TheMechatronic/Skripsie-2022/Report/AppendixDefinitions.tex

\newpage

\chapter{Definitions, Clarifications and Explanations}

\label{ch:defs}

\section{Chapter \ref{ch:concept}}

\subsection*{Definitions}

\label{sec:defs3}

\textbf{Platform}: A solution neutral reference to the system that is being conceptualised. Used interchangeably with \acf{nsoi}, the platform has defined boundaries and interfaces with the \acf{wsoi} and the environment.

\textbf{User}: Refers to the cyclist who will be using the developed platform. At this stage, conceptualisation was focused on the development of the platform as opposed to the overarching objective of providing source material and resources to future development.

\subsection*{Explanations}

\subsubsection{Performance Requirements \ref{PR:27speed} \& \ref{PR:29speed}:}

The typical speed of a cyclist typically ranges from \SI{10}{\kilo\meter\per\hour} to \SI{50}{\kilo\meter\per\hour} when cycling on reasonably flat ground. For the design of the platform, a maximum required speed of \SI{50}{\kilo\meter\per\hour} was assumed. Considering the two wheel sizes that were identified in Chapter~\ref{sec:specs}, the expected wheel rotational speeds are determined by Equation~\ref{eq:omega}.

\begin{equation}
	\ac{omega} = \frac{2 \ac{v}}{D_{wheel}}
	\label{eq:omega}
\end{equation}

\subsubsection{Performance Requirement \ref{PR:power}:}

Typically, amateur cyclists maintain an average power output between \SI{75}{\watt} and \SI{280}{\watt}, and pro cyclists can maintain up to \SI{400}{\watt}, during a 1 hour workout. As the cyclist's speed increases, less torque is required to maintain the same power output. The relation is expressed as Equation~\ref{eq:pow} and can be used to determine the force that would need to be applied at different wheel speeds to achieve these power outputs.

\begin{figure}[H]
	\begin{center}
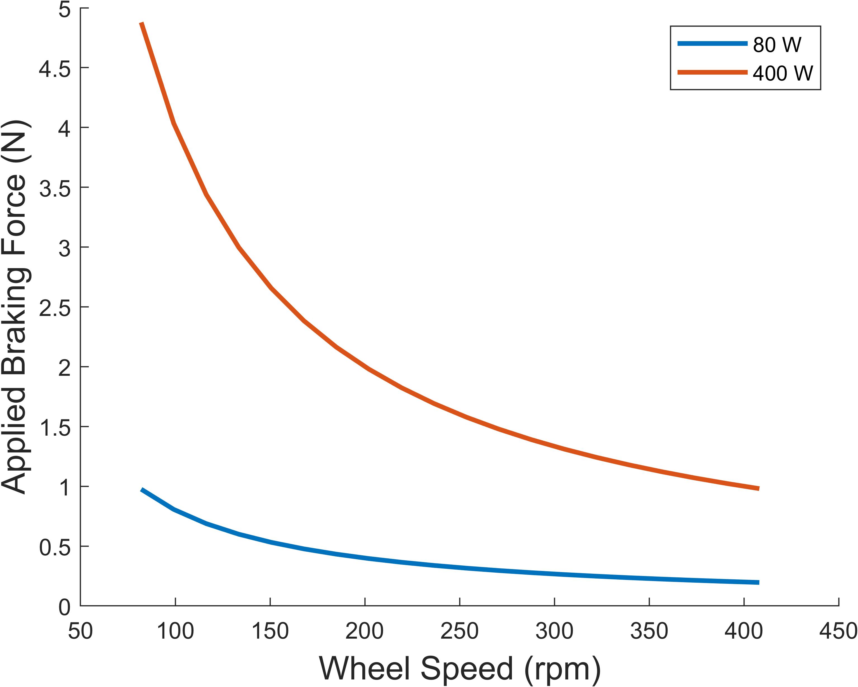
[picture p1: Report/graphics/BrakingForce.jpg]
		
		\caption{Required Braking Force Range}
		\label{fig:force}
	\end{center}
\end{figure}

\subsubsection{System Interface 2: \ac{ble} with \ac{ftms} implementation}

In order to achieve Design Objective 3, requiring the development of software that will be usable by future projects, dependency on the Zwift application \ac{api} had to be avoided. This resulted in the development of software that will enable micro controllers to interact with application hosts in a similar way to conventional smart trainers. This means that the solution will be compatible with the Zwift application irrespective of the device that acts as a host for the application. \ac{ble} was chosen as the communication protocol as this is what is available on most consumer electronic devices that Zwift is expected to operate on, and will thus not need an external unit to communicate with the platform.

%\begin{figure}[h!]
%	\centering
%	\begin{subfigure}[b]{.475\textwidth}
	%		\centering
	%		\includegraphics[width=.9\linewidth]{FluxZeroDeg.jpg}
	%		\caption{\SI{0}{\degree} Phase}
	%		\label{fig:Flux0}
	%	\end{subfigure}
%	\hfill
%	\begin{subfigure}[b]{.475\textwidth}
	%		\centering
	%		\includegraphics[width=.9\linewidth]{FluxSixtyDeg.jpg}
	%		\caption{\SI{60}{\degree} Phase}
	%		\label{fig:Flux60}
	%	\end{subfigure}
%	\vskip\baselineskip
%	\begin{subfigure}[b]{.475\textwidth}
	%		\centering
	%		\includegraphics[width=.9\linewidth]{FluxOneTwentyDeg.jpg}
	%		\caption{\SI{120}{\degree} Phase}
	%		\label{fig:Flux120}
	%	\end{subfigure}
%	\hfill
%	\begin{subfigure}[b]{.475\textwidth}
	%		\centering
	%		\includegraphics[width=.9\linewidth]{FluxOneEightyDeg.jpg}
	%		\caption{\SI{180}{\degree} Phase}
	%		\label{fig:Flux180}
	%	\end{subfigure}
%	\begin{subfigure}{.475\textwidth}
	%		\centering
	%		\includegraphics[width=\linewidth]{FluxLegend.jpg}
	%	\end{subfigure}
%	\caption{Flux Distribution}
%	\label{fig:Flux}
%\end{figure}

\section{Chapter~\ref{ch:electronics}}

\subsubsection{RPR-220 Data Summery}

\begin{table}[H]
	\renewcommand{\arraystretch}{\tablestretch}
	\centering
	\caption{RPR-220 Data Sheet Parameter Summary}
	\citep[2015]{RPR:2015}
	\begin{tabularx}{\textwidth}{X >{\raggedright}p{3cm} >{\raggedright\arraybackslash}p{2cm} }
		\toprule
		Parameter                       & Condition & Value                   \\
		\midrule
		LED Current                     & Maximum   & \SI{50}{\milli\ampere}  \\
		LED Voltage                     & Rated     & \SI{5}{\volt}           \\
		Phototransistor Current (Dark)  & Rated     & \SI{0.5}{\micro\ampere} \\
		Phototransistor Current (Light) & Rated     & \SI{0.8}{\milli\ampere} \\
		Phototransistor Current         & Maximum   & \SI{}{\milli\ampere}    \\
		Phototransistor Response Time   & Rated     & \SI{10}{\micro\second}  \\
		\bottomrule
	\end{tabularx}
	\label{tab:rprdata}
\end{table}

\subsubsection{Nema-23 Wiring}

Determining the correct wiring of the stepper motor requires determining where on the coils the wires are connected. Figure~\ref{fig:motorWire} shows a schematic of the wire colors and coil orientations that were determined for this project.

\begin{figure}[H]
	\begin{center}
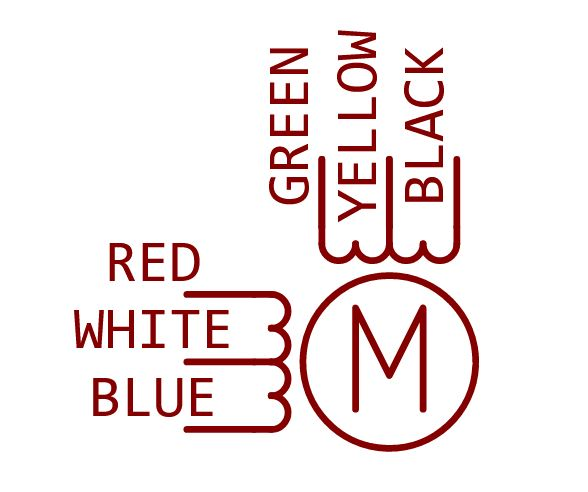
[picture p2: Report/graphics/MotorWire.JPG]
		
		\caption{Nema-23 Wiring}
		\label{fig:motorWire}
	\end{center}
\end{figure}

After testing the resistance level between the wires on the Nema-23 stepper motor, the results are shown in Figure~\ref{tab:nemaTest}. From Table \ref{tab:nemaTest}, the wires associated with each coil can be identified. A resistance of > \SI{1}{\mega\ohm} indicates that the wires are not connected to the same coil. For the wires on the same coil, a larger resistance indicates that there is more coiled wire between the connections, and they are thus further apart.

\begin{table}[H]
	\renewcommand{\arraystretch}{\tablestretch}
	\centering
	\caption{Stepper Motor Wire Resistance Measurement Results}
	\begin{tabularx}{\textwidth}{X X X X X X  }
		\toprule
		& Black               & Green                 & Red                   & Yellow                & White                 \\
		\midrule
		Blue   & > \SI{1}{\mega\ohm} & > \SI{1}{\mega\ohm}   & \SI{41.2}{\ohm}       & > \SI{1}{\mega\ohm}   & \SI{20.7}{\ohm}       \\
		White  & > \SI{1}{\mega\ohm} & > \SI{1}{\mega\ohm}   & \SI{20.8}{\ohm}       & > \SI{1}{\mega\ohm}   & \cellcolor{lightgray} \\
		Yellow & \SI{20.7}{\ohm}     & \SI{20.5}{\ohm}       & > \SI{1}{\mega\ohm}   & \cellcolor{lightgray} & \cellcolor{lightgray} \\
		Red    & > \SI{1}{\mega\ohm} & > \SI{1}{\mega\ohm}   & \cellcolor{lightgray} & \cellcolor{lightgray} & \cellcolor{lightgray} \\
		Green  & \SI{40.5}{\ohm}     & \cellcolor{lightgray} & \cellcolor{lightgray} & \cellcolor{lightgray} & \cellcolor{lightgray} \\
		\bottomrule
	\end{tabularx}
	\label{tab:nemaTest}
\end{table}
