TheMechatronic/Skripsie-2022/Report/Main.pdf

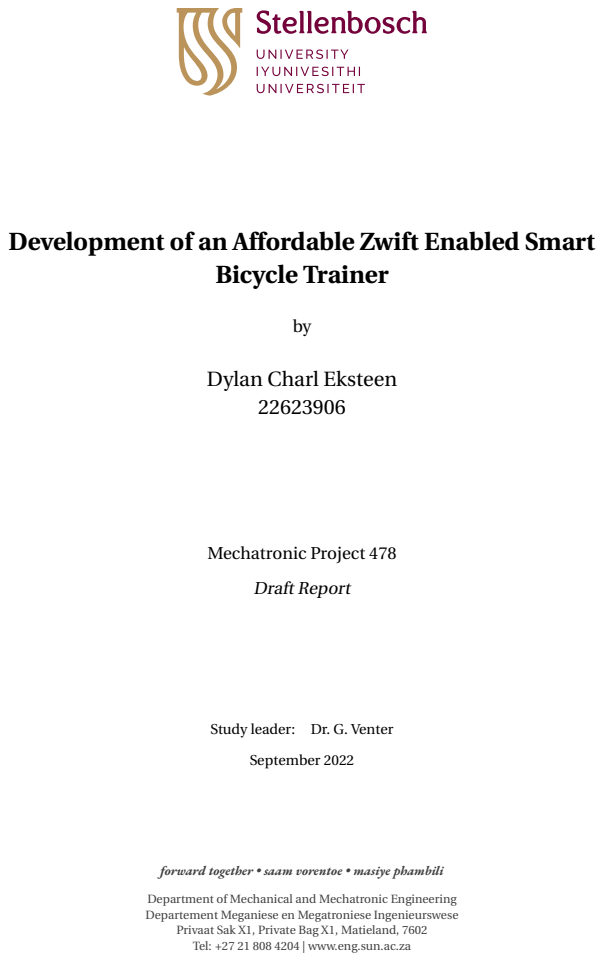
[picture p54: page 1]
Bicycle Trainer; Mechatronic Project 478; Draft Report; September 2022

Development of an Affordable Zwift Enabled Smart

Dylan Charl Eksteen

Study leader: Dr. G. Venter

forward together • saam vorentoe • masiye phambili

Department of Mechanical and Mechatronic Engineering
Departement Meganiese en Megatroniese Ingenieurswese
Privaat Sak X1, Private Bag X1, Matieland, 7602
Tel: +27 21 808 4204 | www.eng.sun.ac.za

# Declaration

By submitting this report electronically, I declare that the entirety of the work contained therein is my own, original work, that I am the sole author thereof (save to the extent explicitly otherwise stated), that reproduction and publication thereof by Stellenbosch University will not infringe any third party rights and that I have not previously in its entirety or in part submitted it for obtaining any qualification.

Signature: |

September 20, 2022
Date: |
D. C. Eksteen
Student Name: |

22623906
Student Number: |

Copyright © 2022 Stellenbosch University All rights reserved.

i

### MECHATRONIC PROJECT 478:

### EXECUTIVE SUMMARY

Student: D. C. Eksteen

Title of Project

Development of an Affordable Zwift Enabled Smart Bicycle Trainer

Objectives

- Design and build an inexpensive bicycle trainer with controllable resistance
- Design and implement software for connecting and interfacing with Zwift
- Test and calibrate the resistance and connectivity of the trainer

What is current practice and what are its limitations?

- Commercial smart trainers that are compatible with Zwift are very expensive and thus inaccessible to

many consumers

- Accessories such as training tyres and additional cassettes also add to the costs of many available trainers

What is new in this project?

The project will develop a focused product, that will be inexpensive, simple and intuitive to use and easy

to maintain

If the project is successful, how will it make a difference?

The developed trainer will make the Zwift training experience more accessible and affordable to a wider

range of consumers. The trainer will also not need many accessories to use, and will be usable by many

different types of bicycles

What are the risks to the project being a success? Why is it expected to be successful?

- Connectivity with Zwift: There is a risk that Zwift will require proprietary software in order to connect

hardware to the platform

- Supply and manufacturing of components. There is a global shortage of components and manufacturing

may be expensive and time consuming

What contributions have other students made?

- There are various different examples of non-smart trainers on the market, which will serve as examples

of what technologies work with similar products

- There are some examples of developed BLE connectivity, as well as some libraries to enable the use of

python in the development process

ii

Mechatronic Project 478: | Executive Summary | iii

Which aspects of the project will carry on after completion and why?

NA

What arrangements have been made to expedite continuation?

- The developed software and electronics schematics will be available on a GitHub repository under an

open license

- The hardware design and concept will be documented and presented in this report, and in the final

project poster

Student

September 20, 2022

Date | Lecturer

### MECHATRONIC PROJECT 478: ECSA EXIT LEVEL OUTCOME EVALUATION

ELO 1: Problem Solving
Demonstrate competence to identify, assess, formulate and solve convergent and divergent engineering problems creatively and innovatively.
- Chapters 1,2,3
and 4
- Poster
- Identify the need for an inexpensive smart trainer that will be able to interface with

Zwift.

- Indicate the criteria needed to connect with Zwift, as well as have a usable trainer done

in Introcuction and Literature Review. (Chapter 1 and 2).

- Best sollution for general problem presented, then split into seperate sections to solve

further ito. Software and Hardware requirements (Chapter 3 and 4)

ELO 2: Application of Scientific and Engineering Knowledge Demonstrate competence to apply knowledge of mathematics, basic science and engineering sciences from first principles to solve engineering problems.

- Section 4.1
- Model of Forces involved in trainer for use in basic hardware design and component

selection.

- Mathematical model and analysis of Eddy Current Brake. (Section 4.1)

ELO 3: Engineering Design
Demonstrate competence to perform creative, procedural and non-procedural design and synthesis of components, systems, engineering works, products or processes.
- Chapter 2 and 3
- Design the software approach, communicating with Zwift through BLE protocol.
- Design a hardware approach for both the resistance brake and the general trainer.
- Design the electro-mechanical control of the braking unit and the controlling software.

(Chapter 2 and 3)

iv

Mechatronic Project 478: | Executive Summary | v

ELO 5: Engineering Methods, Skills and Tools, Including Information Technology Demonstrate competence to use appropriate engineering methods,
skills and tools, including those based on information technology.
- Chapter 3 and 4
- Engineering method applied to solving the communication and control of the trainer

with an external Zwift host.

- Engineering method applied to selecting, designing and implementing the hardware

components needed for the trainer.

- Adequate consideration for the goal of the product applied to the planning and design

phases.

ELO 6: Professional and Technical Communication Demonstrate competence to communicate effectively, both orally and in writing, with engineering audiences and the community at large.

- Report
- Poster
- Presentation
- The Report and the oral presentation will aim to prove the ability to achieve the

communication.

- The Report will focus on presenting the project to a technical and engineering

audience where the poster will be aimed at presenting to the wider community.

ELO 8: Individual, Team and Multidisciplinary Working Demonstrate competence to work effectively as an individual, in teams and in multi-disciplinary environments.

- Section X
- Project focuses on Individual work, with guidance from supervisor and input from

other students working under same supervisor.

- The project proposal, progress report, progress presentation, draft report and final

report will be handed in to achieve this.

Mechatronic Project 478: | Executive Summary | vi

ELO 9: Independent Learning Ability Demonstrate competence to engage in independent learning through well-developed learning skills.

- Chapter 2 & 3
- The learning of Bluetooth technology and application of Eddy Current Brake models

prove independent learning.

# Contents

Declaration | i
Executive Summary | ii
ECSA Exit Level Outcome Evaluation | iv
Contents | vii
List of Tables | ix
List of Figures | x
List of Abbreviations | xi
List of Symbols | xii
1 Introduction | 1
2 Literature Review | 4

vii

CONTENTS | viii
3 Hardware Development | 14
4 Software Development | 20
5 Electronics Design | 24
List of References | 28
A Eddy Current Brake Calculations | i
B Budget | iv

# List of Tables

2.1 | Zwift Supported Fittness Machine Data (FTMS) Commands | | 6
2.2 | Technical Specifications of the Bluetooth Low Energy (BLE) Standard | 9
2.3 | Relevant Optional Fitness Machine Features of Fittness Machine
Data (FTMS) Protocol | 10
2.4 Relevant Optional Target Setting Features of Fittness Machine Data
(FTMS) Protocol | 10
2.5 | Indoor Bike Simulation (SIM) Mode Parameter Data | 11
2.6 | Best Selling Road and Mountain Bike (MTB) specifications | 12
3.1 | Objectives of Hardware Development | 14
3.2 | Outcomes of Condition Analysis | 16
5.1 | RPR-220 Data Sheet Parameter Summary | 25
5.2 | Stepper Motor Wire Resistance Measurement Results | 26

ix

# List of Figures

2.1 | Bluetooth Low Energy (BLE) Star Network Topology | | 8
2.2 | Bicycle Dimensions | 12
3.1 | Rotational Speed of Roller Size Comparison | 15
3.2 | Magnetic Flux Density of Disc Magnet | 17
3.3 | Flux Distribution | 18
3.4 | Figure 7 | 19
3.5 | Figure 8 | 19
4.1 | Overview of General Software Structure | 21
4.2 | Bluetooth Low Energy (BLE) Protocol Stack | 22
5.1 | Sensor Implementation | 26
5.2 | Motor Control Components | 26
5.3 | Nema-23 Wiring | 27
A.1 | Eddy Current Brake Dimensions | | i
A.2 | Figure 5 | | iii
A.3 | Figure 6 | | iii

x

# List of Abbreviations

API | Application Program Interface
BLE | Bluetooth Low Energy
BR/EDR Basic Rate/Enhanced Data Rate
BSIG | Bluetooth Special Interest Group
Crr | Coefficient of Rolling Resistance
Cw | Wind Resistance Coefficient
DIS | Device Information Service
FTMS | Fittness Machine Data
GATT | Generic ATTribute Profile
GPIO | General Purpose Input and Output
IDE | Integrated Development Environment
IPC | Inter-Process Communicationt
MTB | Mountain Bike
RPC | Remote Procedure Calls
rpm | Revolutions Per Minute
SIM | Indoor Bike Simulation
UHF | Ultra-High Frequency

xi

# List of Symbols

Br | Magnet Remanence Field | T
ω | Angular Velocity | rads⁻¹
θ | Angle | rad
T | Torque | Nm
F | Force | N
I | Current | A
v | Velocity | ms⁻¹
B | Magnetic Flux Density | T
σ | Conductivity | Sm⁻¹

xii

# Chapter 1

# Introduction

## 1.1 Background

Bad weather, time, safety or other factors may prevent cyclists from being able to train outside. Modern city lifestyle often means that it is often safer and more convenient In recent years, it has become very popular for cyclists to train indoors as this is often safer than cycling on busy city streets, it makes cycling less reliant on the weather and is more convenient. The problem is that indoor cycling can often be very boring and lonely.
Zwift is an online based virtual reality platform that allows indoor cyclists to virtually ride courses in the real world whilst communicating and competing with other people in real time through the platform. This allows for indoor cycling to become more interactive and exciting, allowing the cyclist to train more effectively and enabling social engagement during training sessions. In order to use the Zwift platform, you need a compatible trainer or training device in order to send riding information to Zwift and to receive feedback that will adjust the riding experience based on the virtual circumstances. These trainers are very expensive and thus not very accessible to many consumers. This project will aim to demonstrate the development, design and testing of an inexpensive smart bicycle trainer. The project, conducted by Mr D.C. Eksteen as part of Mechatronic Project 475, stems from a proposal by Dr G. Venter.

1

CHAPTER 1. INTRODUCTION | 2

## 1.2 Aim and Objectives

This project aims to develop, build and test a smart trainer, with specific focus on compatibility with Zwift.
The objectives will be to:
- Develop Hardware to:
1. Monitor and measure the rider inputs. These include, for example, cycling speed, cadence, power, heart rate etc.
2. Change the riding conditions based on feedback from Zwift platform. These include, for example, rolling resistance, incline etc.
- Develop Software to:
1. Collect and process rider inputs and to communicate this to the Zwift platform.
2. Receive feedback information from Zwift and enable hardware to change the riding conditions as mentioned above.
- Combine developed Hardware and Software to produce a smart trainer that is comparable to smart trainers that are available on the market, but at a lower cost point. (Needs refinement)

CHAPTER 1. INTRODUCTION | 3

## 1.3 Motivation

Motivation will focus on:

- What:

– Zwift = popular indoor training and competitive platform.

– Bicycle trainer = Convenient way to train cycling without needing to cycle outside.

- Why:

– Indoor training increasing in popularity.

– Making access to Zwift more accessible and thus promoting cycling and exercise.

- How:

– Convert existing "dumb" trainer into smart trainer.

– Enable trainer to connect with Zwift platform.

– Using and leveraging existing industry standards to produce a robust solution.

# Chapter 2

# Literature Review

The literature review is performed to define the requirements for the connection with Zwift, as well as discovering and understanding the various desired and required features and products that exist on the market today.

## 2.1 Overview

4

CHAPTER 2. LITERATURE REVIEW | 5

## 2.2 Zwift: Technology and Requirements

As mentioned above, Zwift uses real-time training data to drive the avatar in the virtual world. In order to achieve this, Zwift needs to run on a device that has :

- An internet connection to connect to the Zwift servers via the Application Program Interface (API).
- Bluetooth Low Energy (BLE) or ANT+ functionality to receive the data from the training session.

This device is usually a laptop, mobile phone or tablet, and will also display the avatar in the virtual world to the player. Moving forward, this device will be referred to as the "host" device as it is the central device controlling the user experience. (von Bromley, 2022)

### 2.2.1 Basic Requirements

As mentioned above, Zwift requires real-time tracking data from the player in order to control the avatar. The interactiveness and accuracy of the experience greatly depends on the amount and nature of the data that is sent to the host device (also sometimes referred to as the ’main unit’).

Parameter | Unit | Connectivity | Control
Speed | (rpm) | Essential | Essential
Cadence | (rpm) | Optional | Optional
Power | (W) | Optional | Optional

### 2.2.2 BLE vs ANT+

Both BLE and ANT+ devices communicate using Ultra-High Frequency (UHF) electromagnetic waves with frequencies around 2.4 GHz. The communication also takes part over a small distance.

CHAPTER 2. LITERATURE REVIEW | 6

BLE for Fitness Devices

BLE is one of two standards for Bluetooth communication that has been developed and maintained by Bluetooth Special Interest Group (BSIG).¹The

specific details of the technology and standard is discussed in Section 2.4. For the sake of Zwift requirements, this section will look at the specific protocol of the BLE specification that Zwift supports.
In the past, when Zwift was just launched, all of the Bluetooth communication was performed using proprietary protocols provided by the manufacturers of trainers and training equipment as there has not yet been a standard protocol defined to handle Bluetooth communication of controllable sports equipment. On 14 February 2017, BSIG adopted the Fittness Machine Data (FTMS) protocol to the BLE Generic ATTribute Profile (GATT). Then, in late 2021 Zwift announced that they will be supporting FTMS in their latest update, and thus any new trainer that would like to interact with the Zwift platform would be required to follow the FTMS protocol as is discussed in Section 2.4. (Zwift Forums)
Table 2.1 below shows the different commands within the FTMS protocol that Zwift uses to control connected trainers. This can be deducted from the control modes that are available on the platform, and have been confirmed by a Zwift engineer on the official support forums.

Table 2.1: Zwift Supported FTMS Commands

Command | Description

Set Target Resistance
Level

Sends the desired resistance level to the trainer.

Set Target Power | Sends the targeted power (Watts) that the trainer
should aim to maintain.
Start or Resume | Starts or resumes a training session on the trainer
Stop or Pause | Stop or pause a training session on the trainer.

Set Indoor Bike
Simulation Parameter

Set the simulation parameters on the trainer

1The other being Bluetooth Basic Rate/Enhanced Data Rate (BR/EDR)

CHAPTER 2. LITERATURE REVIEW | 7

Depending on the type of workout that is being performed, Zwift will use the different control point commands listed in Table 2.1 above. When the user is normally riding around within the Zwift world, it will send Indoor Bike Simulation (SIM) parameter commands. This is explained in more detail in Section 2.4. When the user is using the "Workout Mode", Zwift has the option to engage "ERG" mode, where it will send a desired power target that the trainer should aim to maintain regardless of the speed. Thus the user can decide to go faster, with the trainer lowering the resistance, or go slower with the trainer having an increased resistance. Lastly, the user can adjust the resistance on their trainer from within the Zwift software, requiring Zwift to then send that specific command to the trainer.

CHAPTER 2. LITERATURE REVIEW | 8

## 2.3 Existing Trainer Technology

## 2.4 BLE Communication

BLE works by forming pico - and scatter-net networks between various master and slave devices. Each device in the network is either a master or a slave, but never both. The devices then form a piconet when one or more slaves connect and synchronize with a single master device. The role of the master device is then to manage the slave devices through the protocol. This forms a network as can be seen in Figure 2.1 below.

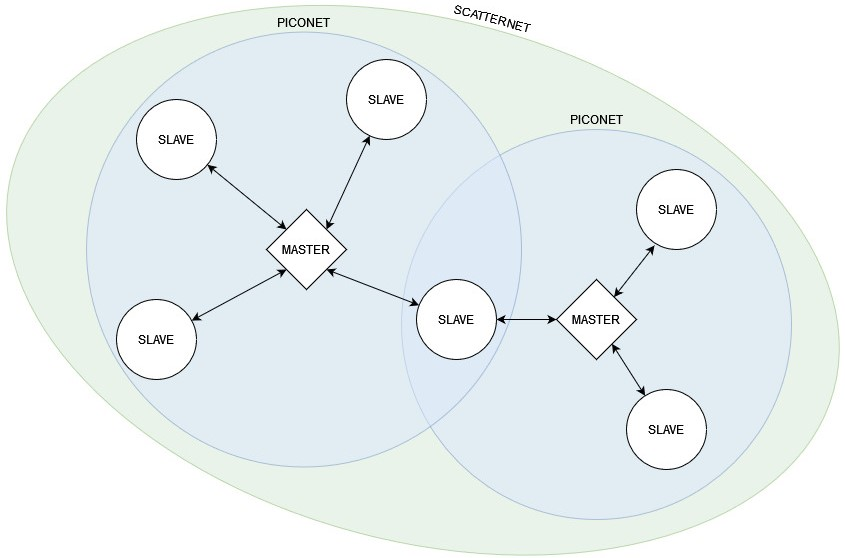
[picture p55: figure]

Figure 2.1: BLE Star Network Topology

The master thus determines how often a slave is allowed to communicate, and slaves only communicate when requested to do so by a master. This is with one exception in the case of "advertising". Advertising is a feature that allows a slave device to announce that it has something to transmit to the master. This is either an event message or a measurement value.

CHAPTER 2. LITERATURE REVIEW | 9

Some other features worth considering are listed in Table 2.2 below:

Table 2.2: Technical Specifications of the BLE Standard

Description | Specification | Detail
Data Package Size | 64 bit (min) to 216 bit (max) | The size data packages that can be sent between a master and slave(s).
Data Transfer Rate | 1 Mbps | The rate at which the data is typically transferred between devices.
Security | 128-bit AES | Security and encryption varies in levels, but generally data is encrypted between devices with a "shared secret" key that is generated during pairing.
Latency | 6 ms | Time between device starting transmission and data getting transferred. (Aka network lag).
Power Consumption | 0.01 W to 0.5 W | The power required by a device to join and operate on the piconet.

FTMS Protocol

Within the FTMS protocol, there is a sub-protocol dedicated to Indoor Bike Data that focuses specifically on the application of the protocol for bike trainers. (Bluetooth®Service Specification, section 4.9).

The specification outlines and defines services that are supported by the protocol. Table 2.3 and 2.4 below lists the available features that are of interest to the project. Machine Features are Parameters that can be requested from the trainer, and Target Features are training parameters that can be set from an external device. (Bluetooth®Service Specification)

CHAPTER 2. LITERATURE REVIEW | 10

Table 2.3: Relevant Optional Fitness Machine Features of FTMS Protocol

Number Feature | Description

NAa
| Instantaneous Speed | Trainer can determine the instantaneous speed of the user.
0 | Average Speed Supported | Trainer can determine the average speed of the user for the duration of the session.
1 | Cadence Supported | Trainer can determine pedalling rate of the user (rpm).
7 | Resistance Level Supported | Trainer can determine the resistance the user experiences.
10 | Heart Rate Measurement Supported | Trainer is able to determine the heart rate of the user.
14 | Power Measurement Supported | Trainer is able to determine the power generated by the user.

aThis feature is compulsory for protocol.

The parameters that would be relevant to the control of a bicycle trainer connected to Zwift are listed in Table 2.4 below:

Table 2.4: Relevant Optional Target Setting Features of FTMS Protocol

Number Feature | Description
1 | Inclination Target Setting | Trainer can adjust difficulty to simulate inclination.
2 | Resistance Target Setting | Trainer can adjust resistance level.
3 | Power Target Setting | Trainer can adjust difficulty to maintain power target.
13 | SIM Parameters | Trainer supports SIM mode.

CHAPTER 2. LITERATURE REVIEW | | | 11

SIM mode

This mode is defined in the FTMS documentation, and needs Control Permission to be activated. Once the mode is activated, the trainer will receive parameter arrays with the data shown in Table 2.5 below to determine the required resistance level.

Table 2.5: SIM Mode Parameter Data

Parameter | Unit | Size | Resolution
Wind Speed | ms⁻¹ | 16 bit | 0.001
Grade | % | 16 bit | 0.01
Coefficient of Rolling Resistance (Crr) | | 8 bits | 0.0001
Wind Resistance Coefficient (Cw) | kgm⁻¹ | 8 bits | 0.01

The Grade indicates the gradient of the road that the avatar is travelling on. The Coefficient of Rolling Resistance (Crr) is determined by the road surface and wheel type of the avatar in the game, where the Wind Resistance Coefficient (Cw) is determined by the player’s weight and height, and can then be reduced by in-game events such as equipment selection and drafting behind other avatars when this feature is active. Currently Zwift does not utilize the Wind Speed parameter.
These parameters are then used by the trainer to determine the resistance required to simulate the conditions in the game. This is what creates the realistic training experience.

CHAPTER 2. LITERATURE REVIEW | 12

## 2.5 Bicycle Specifications

The two most common types of bicycles that are expected to be used on the trainer are Mountain Bikes (MTBs) and road bicycles. For the design of a bike trainer, the relevant dimensions to consider are the wheelbase wheel diameter and weight. Figure 2.2 below shows where the dimensions are measured.

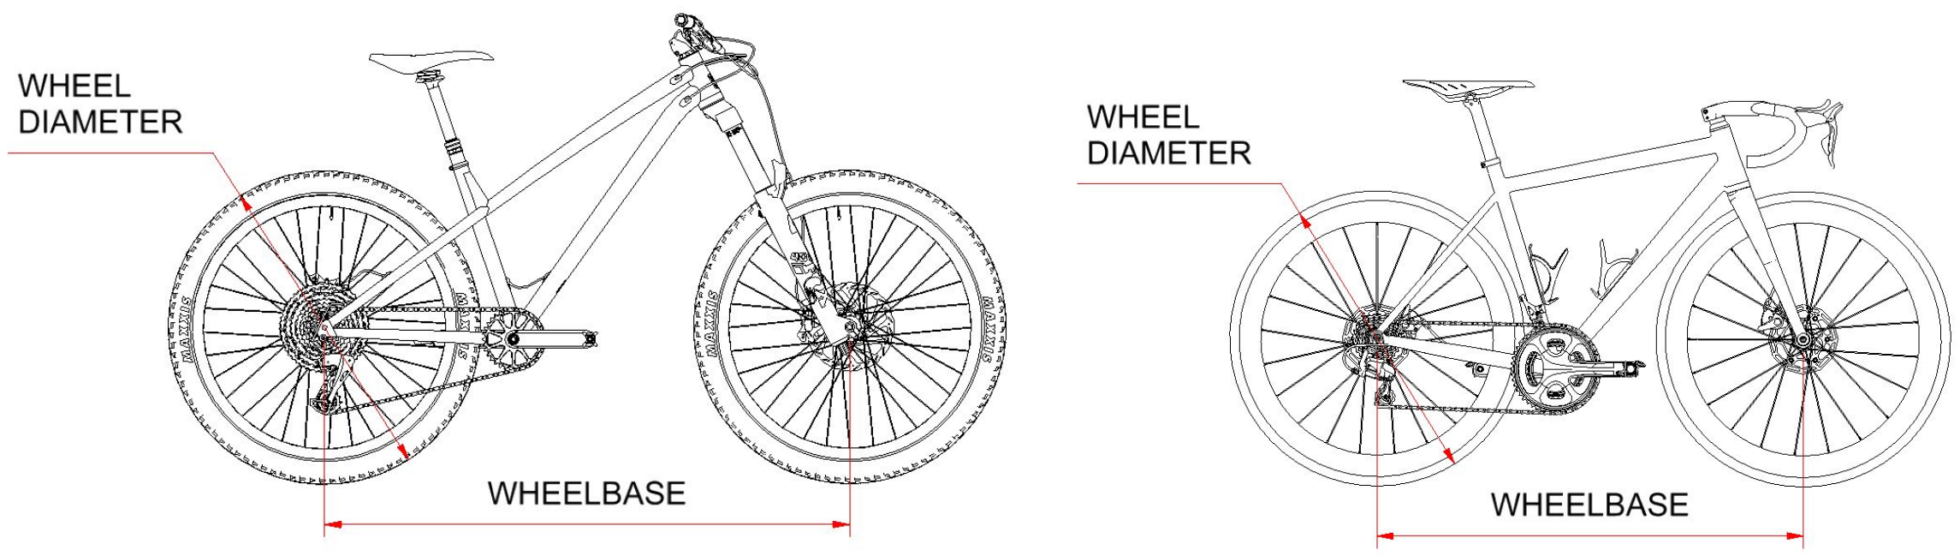
[picture p56: figure]

(a) MTB (model by: Pratama, 2021) (b) Road Bicycle (model by: Morozev, 2017)

Figure 2.2: Bicycle Dimensions

Although these dimensions vary between brands, models and sizes, a general overview of common dimensions can be found by comparing the dimensions of the largest and smallest size offerings from the best selling models in each category. (Lin, 2021)The results are shown in Table 2.6 below: (Geometry Geeks)

Table 2.6: Best Selling Road and MTB specifications

Road Bike | Wheelbase | MTB | Wheelbase
Smallest Largest | Smallest Largest

Specialized
Tarmac
969 mm | 1012 mm | Specialized
Epic

1116 mm 1211 mm

Specialized
Roubaix
981 mm | 1024 mm | Trek Fuel EX | 1144 mm 1323 mm
Cervelo R3 | 971 mm | 1024 mm | Specialized
Stumpjumper

1152 mm 1302 mm

CHAPTER 2. LITERATURE REVIEW | 13

## 2.6 Eddy Current Brake

## 2.7 Sensor Technology

## 2.8 Conclusion

# Chapter 3

# Hardware Development

For the project, hardware was developed with the aim of achieving the objectives shown in 3.1 below:

Table 3.1: Objectives of Hardware Development

Hardware Design
Outcome
Description | Target Objective
HDO 1 | Eddy Current Brake Design | O1
HDO 2 | Speed Sensors Design | Adequate Braking Force
HDO 3 | Frame and Shafts Design | Description
HDO 4 | Outcome 4 | Description

14

CHAPTER 3. HARDWARE DEVELOPMENT | 15

## 3.1 Expected Operating Conditions

Roller trainers require the cyclist to be travelling at some speed for stability. Thus, the expected operating range of a cyclist on the trainer will typically range between 10 kmh⁻¹

and 50 kmh⁻¹
. For the design, a maximum high speed of 60 kmh⁻¹ was considered. The corresponding drum speeds are shown in Figure

3.1 below.

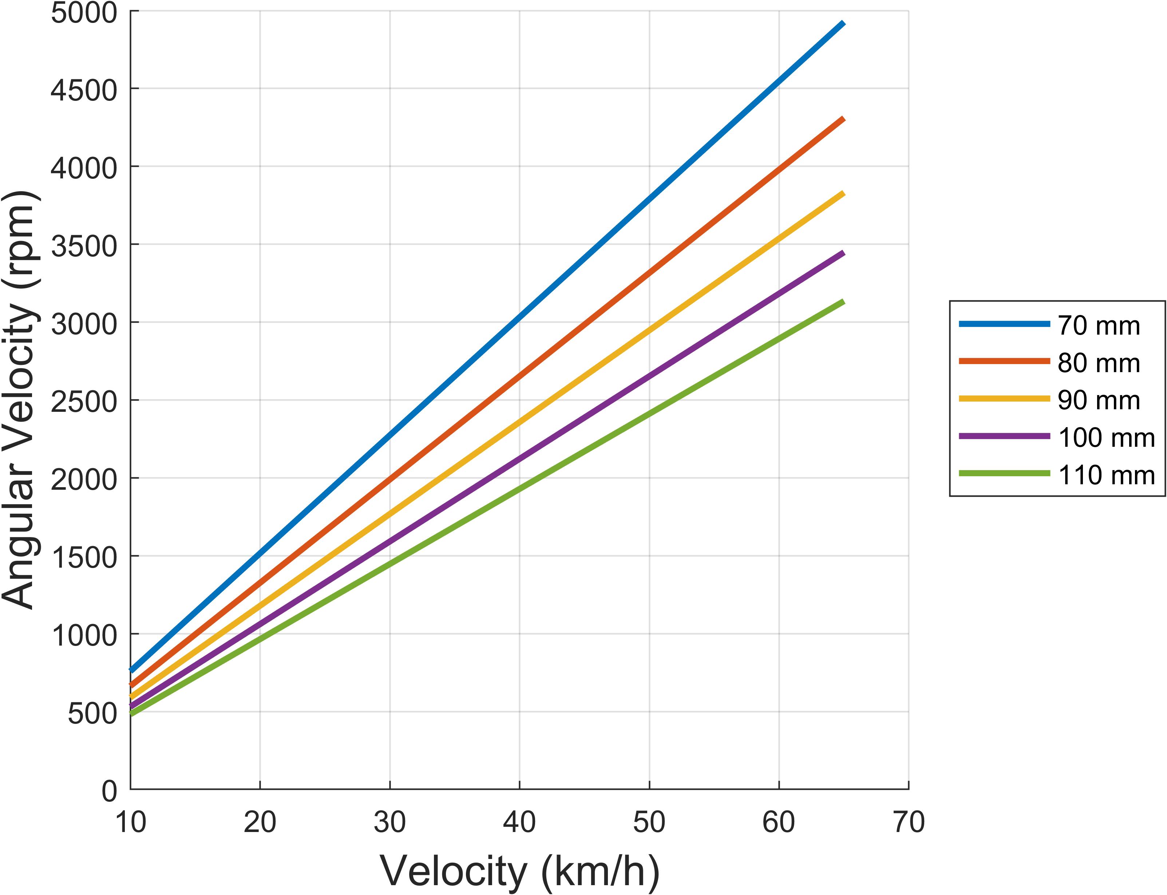
[picture p57: figure]

Figure 3.1: Rotational Speed of Roller Size Comparison

Considering the design of the Eddy Current brake, as discussed in Section 3.2, higher braking force can be achieved at higher drum speeds, and result in a larger operating range. On the other hand, On the other hand, higher speeds will also increase the free-rolling resistance of the trainer, and allow for less range at higher speeds. Thus, 90 mm drums were selected as a good compromise, and were selected for the model.

Typical cyclists average between 75 and 100 W, and pro cyclists can reach up to 400 W, during a 1 hour workout.

CHAPTER 3. HARDWARE DEVELOPMENT | 16

Table 3.2: Outcomes of Condition Analysis

Outcome | Description | Value
Drum Rotational Speed | Maximum | 3500 rpm
Wheelbase | Range
Braking Torque | Target
Allowable Weight | Maximum

CHAPTER 3. HARDWARE DEVELOPMENT | 17

## 3.2 Eddy Current Brake Design


Figure 3.2: Magnetic Flux Density of Disc Magnet

(Addapted from Supermagnete)

B =

Br
2

(

t + z
p
r

2 + t + z

2

−

z
r

2 + z

2

) | (3.1)

CHAPTER 3. HARDWARE DEVELOPMENT | 18

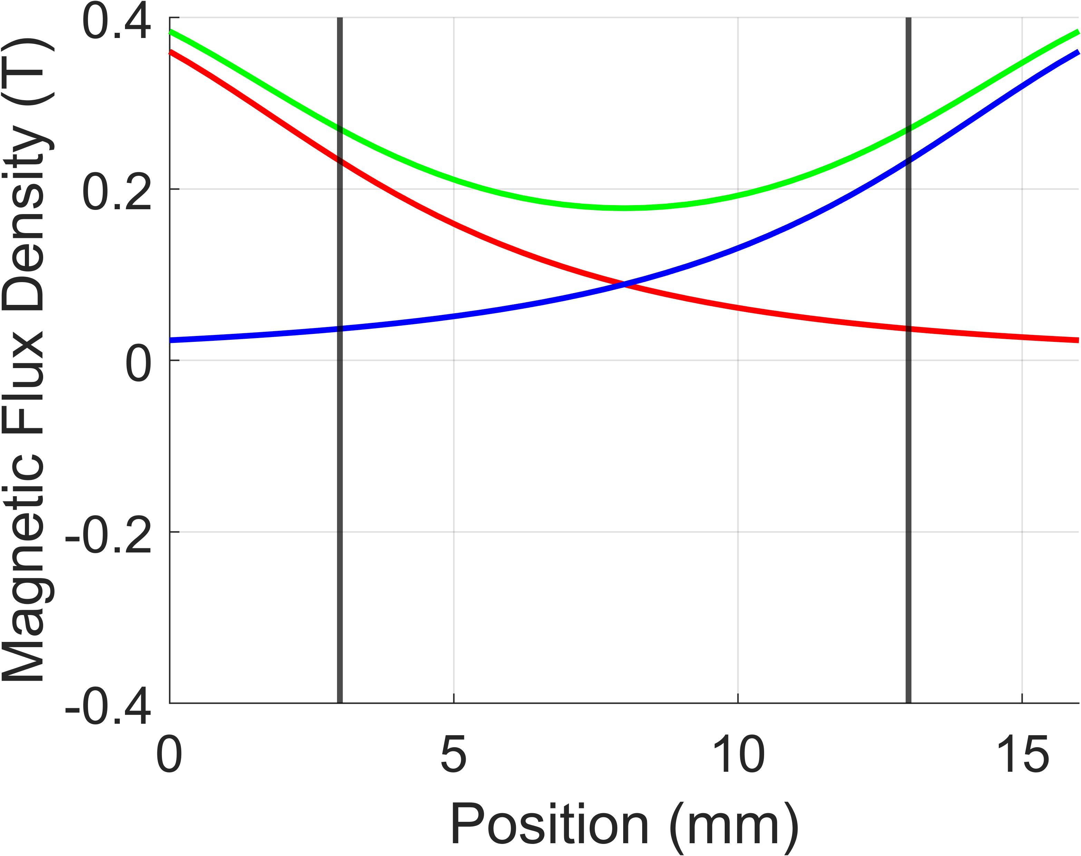
[picture p58: figure]
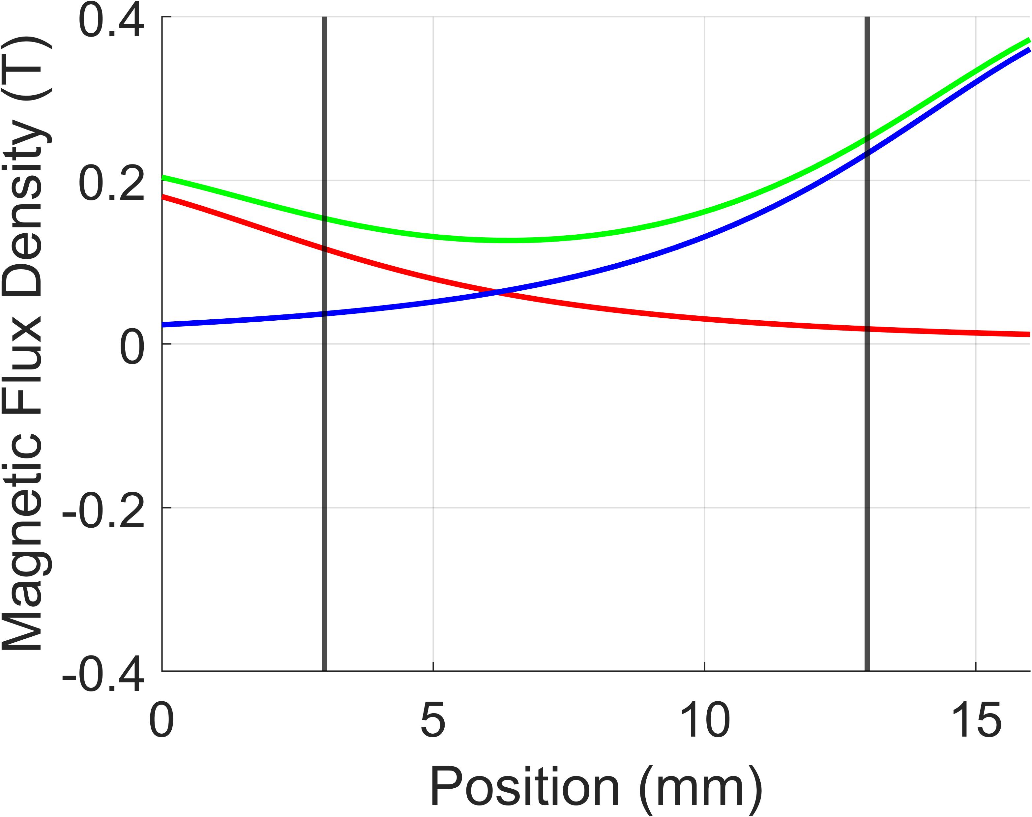
[picture p59: figure]

(a) 0◦ Phase | (b) 60◦ Phase

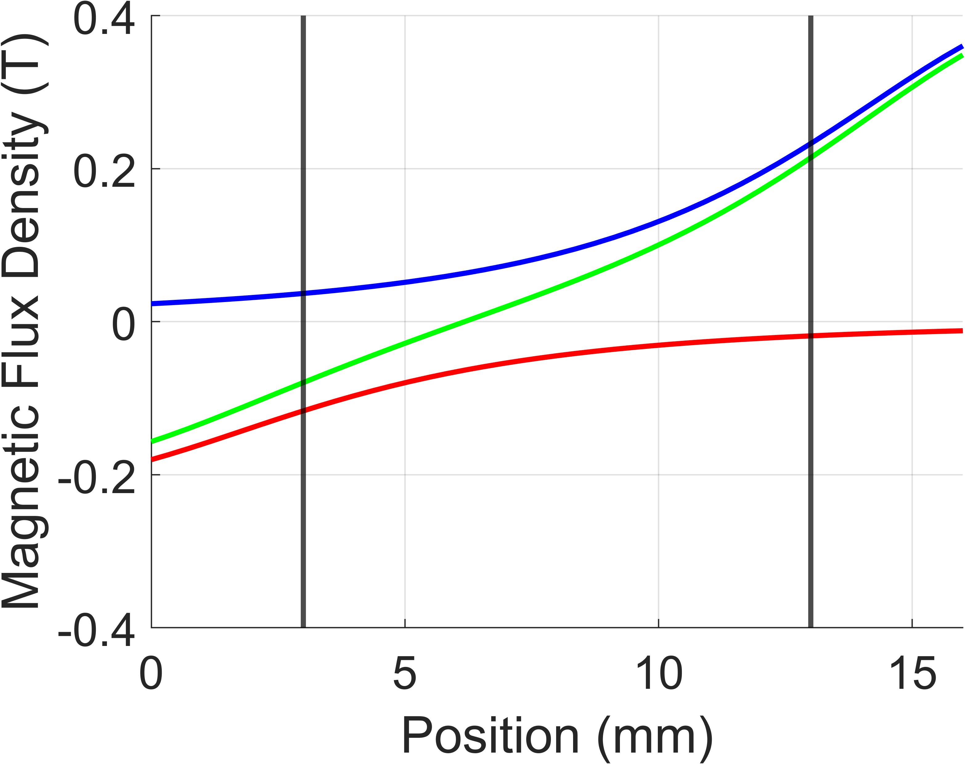
[picture p60: figure]
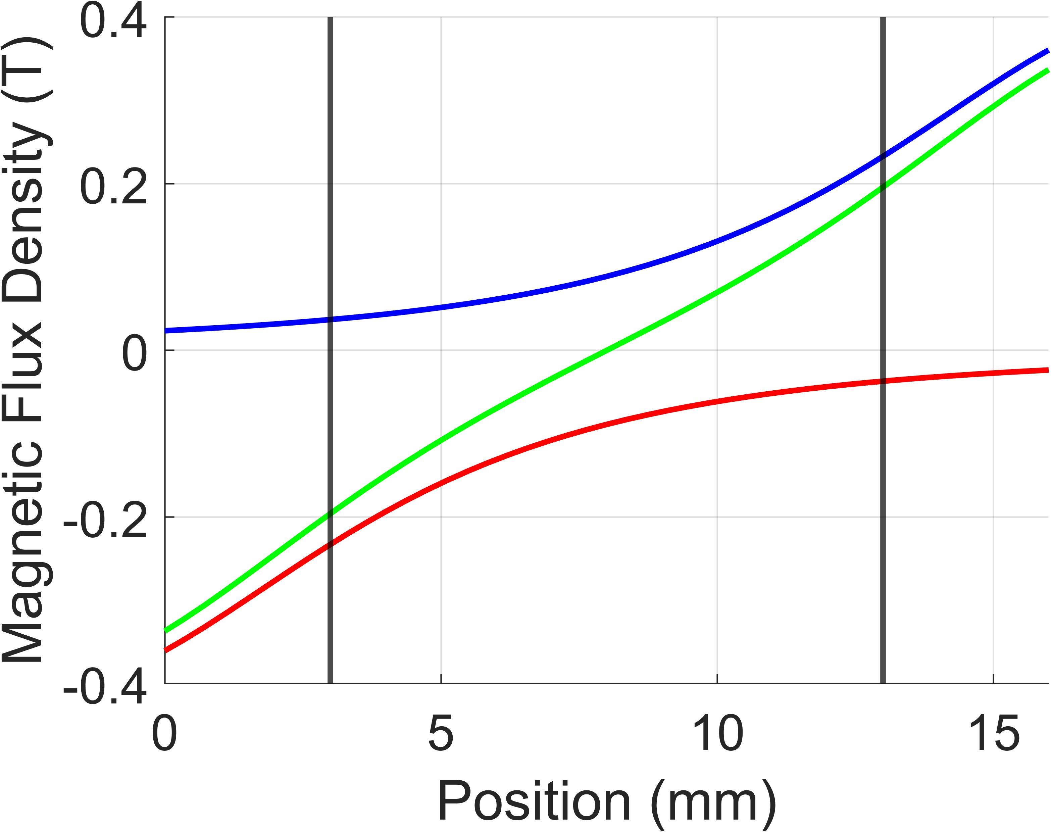
[picture p61: figure]

(c) 120◦ Phase | (d) 180◦ Phase

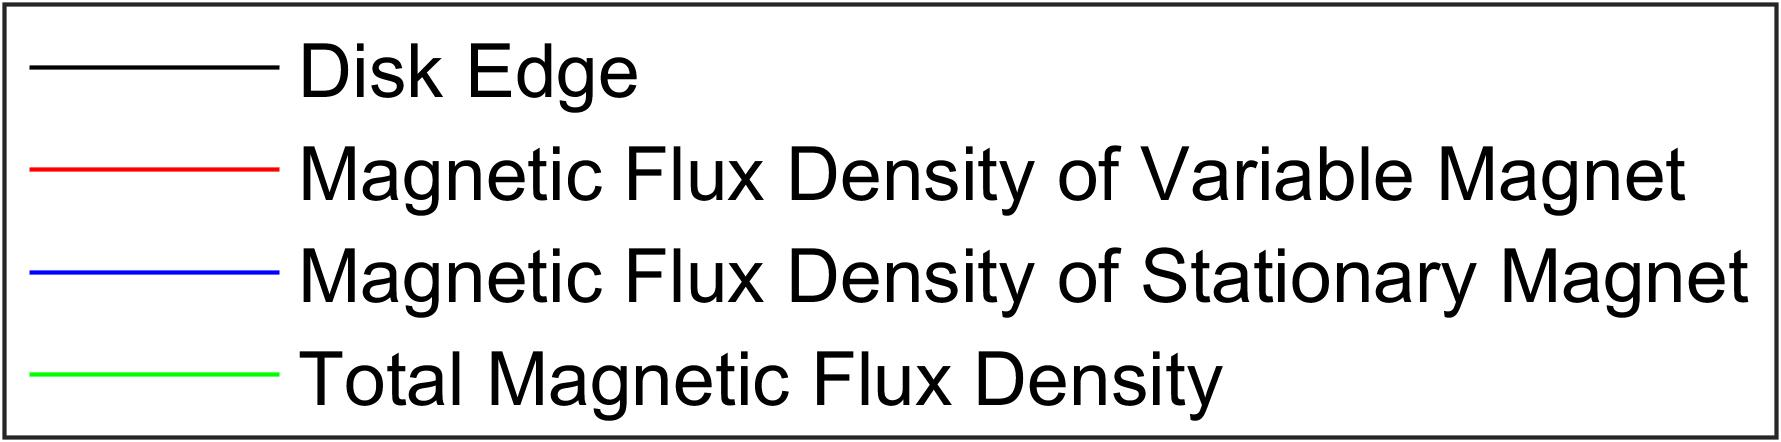
[picture p62: figure]

Figure 3.3: Flux Distribution

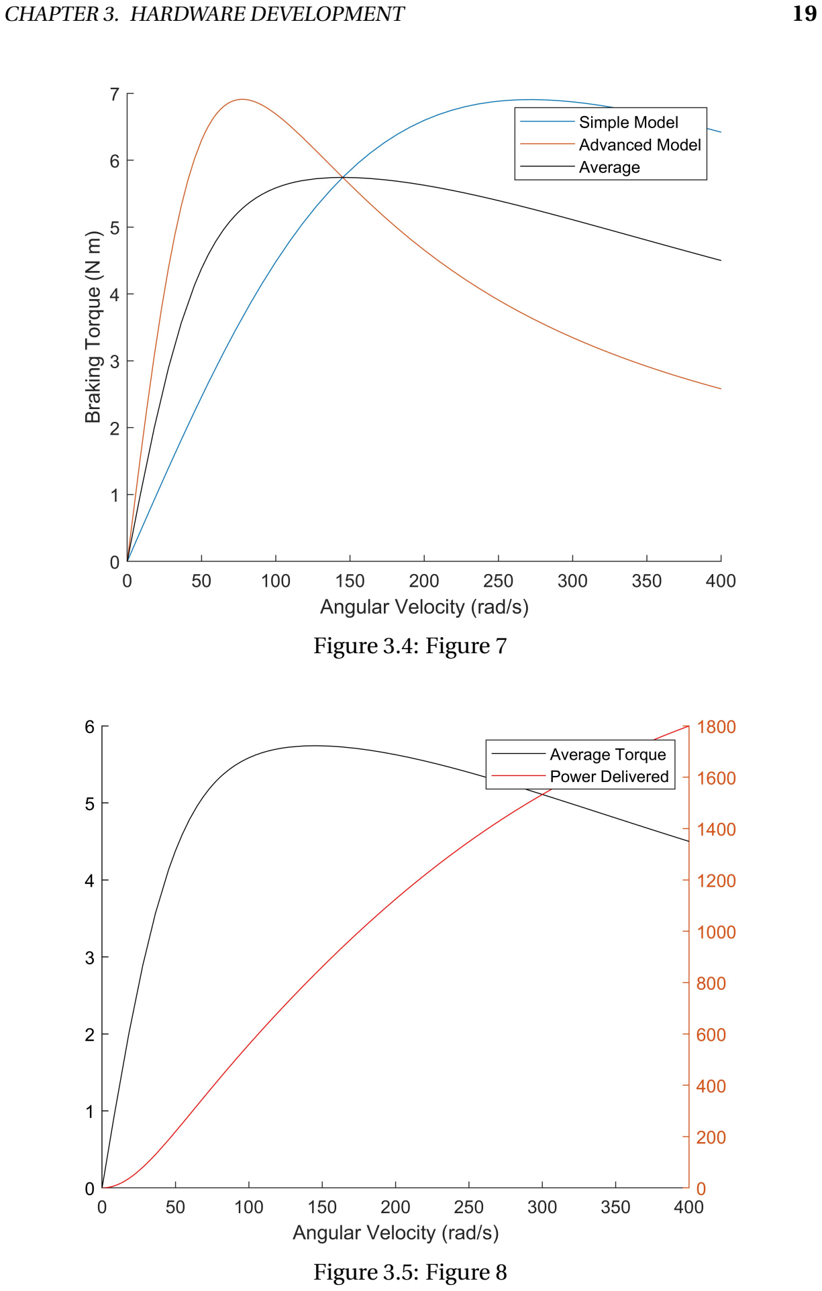
[picture p63: page 32]

CHAPTER 3. HARDWARE DEVELOPMENT | 19

Figure 3.4: Figure 7

Figure 3.5: Figure 8

# Chapter 4

# Software Development

The software that was developed for this project was written in Python 3, using Visual Studio Code Integrated Development Environment (IDE). The software was then deployed on a Raspberry Pi 3 B+ computer.

20

CHAPTER 4. SOFTWARE DEVELOPMENT | 21

## 4.1 Structure

The software for the project has been written to form a very modular structure with separate "handlers" being written/developed for different functions of the greater application. There are some exceptions where existing libraries and servers were used, but these are referenced in the relevant sections later in this chapter.
Figure 4.1 below shows the modular structure that was implemented for the control of the Raspberry Pi 3B+ single-board computer

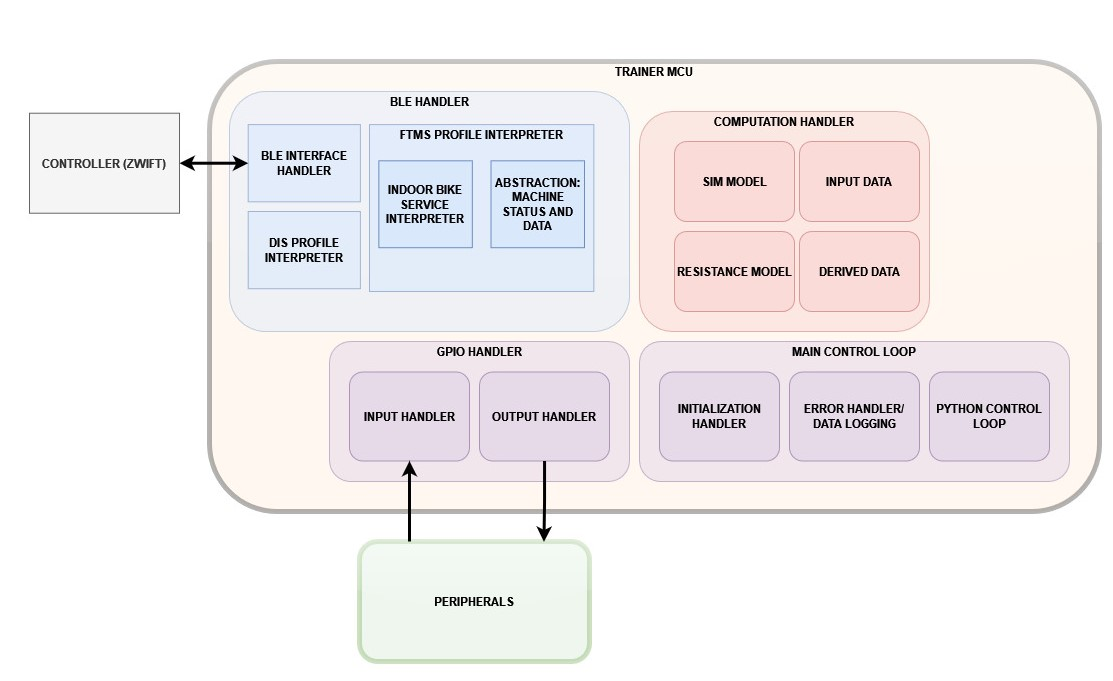
[picture p64: figure]

Figure 4.1: Overview of General Software Structure

## 4.2 BLE Handler

The BLE handler is responsible for all of the Bluetooth communication protocols, and has to strictly conform to the BLE specifications in order to ensure compatibility with common devices. The handler consists of a few different services that in tern manage some service or function within the greater protocol.
The BLE protocol was designed to be used with various layers of abstraction

CHAPTER 4. SOFTWARE DEVELOPMENT | 22

between the low level operations of the system. This results in the structure for the abstraction layers as seen in Figure 4.2 below:

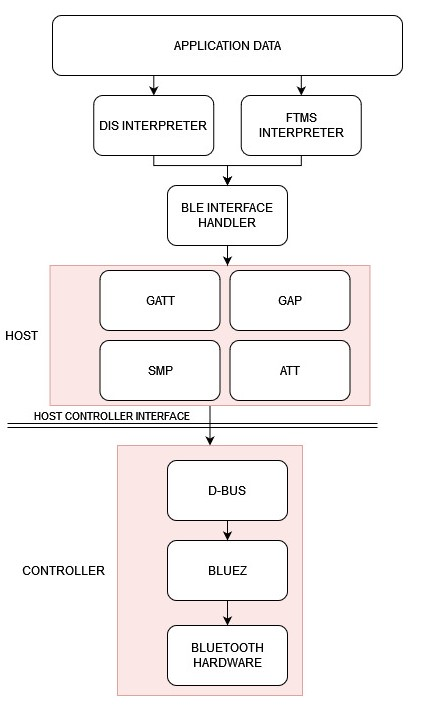
[picture p65: figure]

Figure 4.2: BLE Protocol Stack

The abstraction all the way up to the host already exists and is implemented on the Raspberry Pi. The D-Bus is an Inter-Process Communicationt (IPC) method that allows for Remote Procedure Calls (RPC) between the various processes. The role of the BLE Interface Handler is thus to handle communication between the main process and Bluez. Bluez is the official Linux Bluetooth protocol stack, and is what controls the Bluetooth operations of the system. (Lee, 2020)

The FTMS and Device Information Service (DIS) Interpreters receive and send various BLE commands, requests and replies between the BLE Interface Handler and the running application. It is here where messages are split up into their

CHAPTER 4. SOFTWARE DEVELOPMENT | 23

various components before being acted apron, and replies get created in the required format before being sent to the Bluez stack.

# Chapter 5

# Electronics Design

Electronics section overview ...

24

CHAPTER 5. ELECTRONICS DESIGN | 25

## 5.1 Sensors

Speed sensors are required to measure the rotational speed of the two rear drums. For the application, RPR-220 infrared photoreflectors were used as they allow for reliable contactless speed measurements. The RPR-220 unit was also readily available, inexpensive and would work with the Raspberry Pi’s GPIO pins.

Sensors are required to measure the angular velocity of both the rear cylinders. It was decided that using a infrared transmitter-receiver device with reflective strips on the cylinder would be sufficient. The sampling rate of the sensors should be high enough to gather high resolution measurements, but should remain accurate up to the maximum expected drum speed.

The raspberry Pi is capable of measuring inputs using the standard Rpi.GPIO library up to 5 kHz. Since the maximum expected drum rotation speed is 3500 rpm, which equates to 66.6 Hz, the sensors would be capable of handling up to 75 segments per revolution. Considering a safety factor and in order to reduce the data burden, a sensor system implementing 60 segments was selected to ensure high enough resolution at low speeds.

Table 5.1: RPR-220 Data Sheet Parameter Summary

(RPR-220)

Parameter | Condition | Value
LED Current | Maximum | 50 mA
LED Voltage | Rated | 5 V
Phototransistor Current (Dark) | Rated | 0.5 µA
Phototransistor Current (Light) | Rated | 0.8 mA
Phototransistor Response Time | Rated | 10 µs

fc =

1
2RC

(5.1)

CHAPTER 5. ELECTRONICS DESIGN | 26

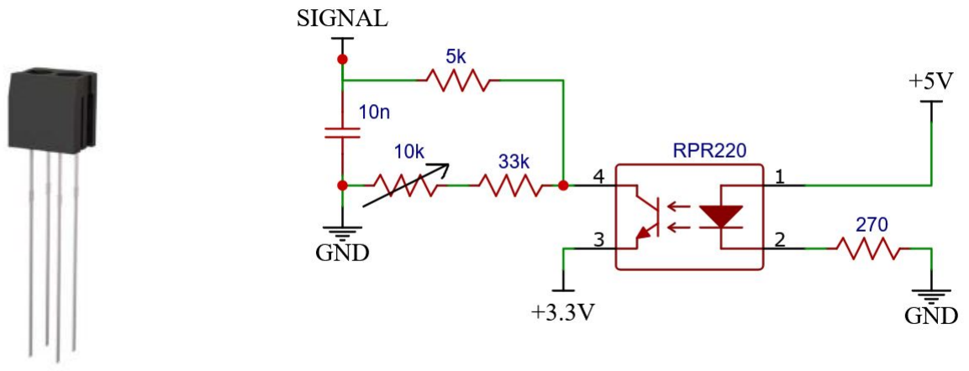
[picture p66: figure]

(a) RPR-220 Photoreflector

(RPR-220)

(b) Sensor Biasing and Filter Circuit

Figure 5.1: Sensor Implementation

## 5.2 Motor Control

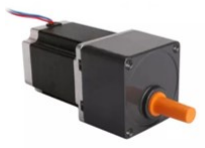
[picture p67: figure]

(a) Nema 23 Stepper Motor with 15:1 Gearbox

(Micro Robotics)

(b) TB660 v1.1 Stepper Motor Driver

(Communica)

Figure 5.2: Motor Control Components

After testing the resistance level between the wires on the Nema-23 stepper motor, the results were:

Table 5.2: Stepper Motor Wire Resistance Measurement Results

| Black | Green | Red | Yellow | White
Blue | > 1 MΩ | > 1 MΩ | 41.2 Ω | > 1 MΩ | 20.7 Ω
White | > 1 MΩ | > 1 MΩ | 20.8 Ω | > 1 MΩ
Yellow | 20.7 Ω | 20.5 Ω | > 1 MΩ
Red | > 1 MΩ | > 1 MΩ
Green | 40.5 Ω

CHAPTER 5. ELECTRONICS DESIGN | 27

From Table 5.2 above, the wires associated with each coil can be identified. A resistance of > 1 MΩ indicates that the wires are not connected to the same coil. For the wires on the same coil, a larger resistance indicates that there is more coiled wire between the connections, and they are thus farther apart. This results in the :


Figure 5.3: Nema-23 Wiring

# List of References

Bluetooth® Service Specification (2017 February 14). Fitness machine service v1.0 [online].

Availible at: https://www.bluetooth.org/DocMan/handlers/DownloadDoc.ashx?doc_

id=423422. (https://www.bluetooth.org/DocMan/handlers/DownloadDoc.ashx?doc_id=423422)
[Accessed 1 January 2022].

Communica (2022). Hkd tb6600 stepper driver 4.5a. [online].
Availible at: https://www.communica.co.za/products/hkd-tb6600-stepper-driver-

4-5a. (https://www.communica.co.za/products/hkd-tb6600-stepper-driver-4-5a)
[Accessed 20 September 2022].

Geometry Geeks (2022). Find and compare bike geometry. [online]. Availible at: https://geometrygeeks.bike/.
[Accessed 18 September 2022].

Lee, A. (2020 June 29). Creating a ble peripheral with bluez [online].
Availible at: https://punchthrough.com/creating-a-ble-peripheral-with-bluez. [Accessed 1 January 2022].

Lin, B. (2021 December 27). The pro’s closet. [online].
Availible at: https://www.theproscloset.com/blogs/news/best-selling-bikes-

2021. (https://www.theproscloset.com/blogs/news/best-selling-bikes-2021)
[Accessed 1 January 2022].

Micro Robotics (2022). Online store. [online]. Availible at: https://www.robotics.org.za/. [Accessed 20 September 2022].

Morozev, M. (2017 December 30). Grabcad [online].
Availible at: https://grabcad.com/library/road-bike-12. [Accessed 1 January 2022].

28

LIST OF REFERENCES | 29

Pratama, M.R.R. (2021 November 20). Grabcad [online].
Availible at: https://grabcad.com/library/am-ht-1.
[Accessed 1 January 2022].
RPR-220 (2017). | RPR-220 Reflective photosensor (photoreflector) Datasheet, Rev.B. | ROHM
Co., | https://fscdn.rohm.com/en/products/databook/datasheet/opto/optical_
sensor/photosensor/rpr-220.pdf. (https://fscdn.rohm.com/en/products/databook/datasheet/opto/optical_sensor/photosensor/rpr-220.pdf)

Supermagnete (2010 January 1). Faq: How do you calculate the magnetic flux density? [online]. Availible at: https://www.supermagnete.de/eng/faq/How-do-you-calculate-the-

magnetic-flux-density. (https://www.supermagnete.de/eng/faq/How-do-you-calculate-the-magnetic-flux-density)
[Accessed 1 January 2022].

von Bromley, S. (2022). Zwift: your complete guide: Everything you need to know [online]. Availible at: https://www.bikeradar.com/features/zwift-your-complete-guide. [Accessed 1 January 2022].

Zwift Forums (2022 January 2). Improvements to ftms controllable trainers [online].
Availible | at: | https://forums.zwift.com/t/bluetooth-improvements-for-
controllable-trainers-treadmills-january-2022/569781/38?page=4. (https://forums.zwift.com/t/bluetooth-improvements-for-controllable-trainers-treadmills-january-2022/569781/38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) [Accessed 1 January 2022].

# Appendix A

# Eddy Current Brake Calculations

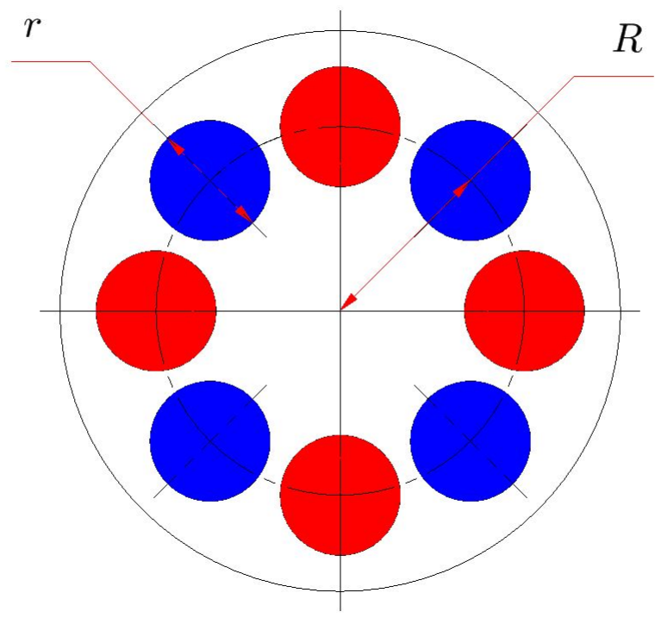
[picture p68: figure]

Figure A.1: Eddy Current Brake Dimensions

i

APPENDIX A. EDDY CURRENT BRAKE CALCULATIONS | ii

At low speeds:
The Eddy Currents in the Aluminium disc will be:

I e =

σBv
2

The eddy currents within the disc is then:

di =

I e
2π

dθ

Using Ampere’s Law, the force on an element at length l is then:

dF = B di dl

dT = l dF

Thus, combining all these, we get:

dT =

B I e
2π

l dθdl

By integrating, we get:
Z R

0

Z 2π

0

B I e
2π

l dθdl

T =

σB

2ωnR

2

6

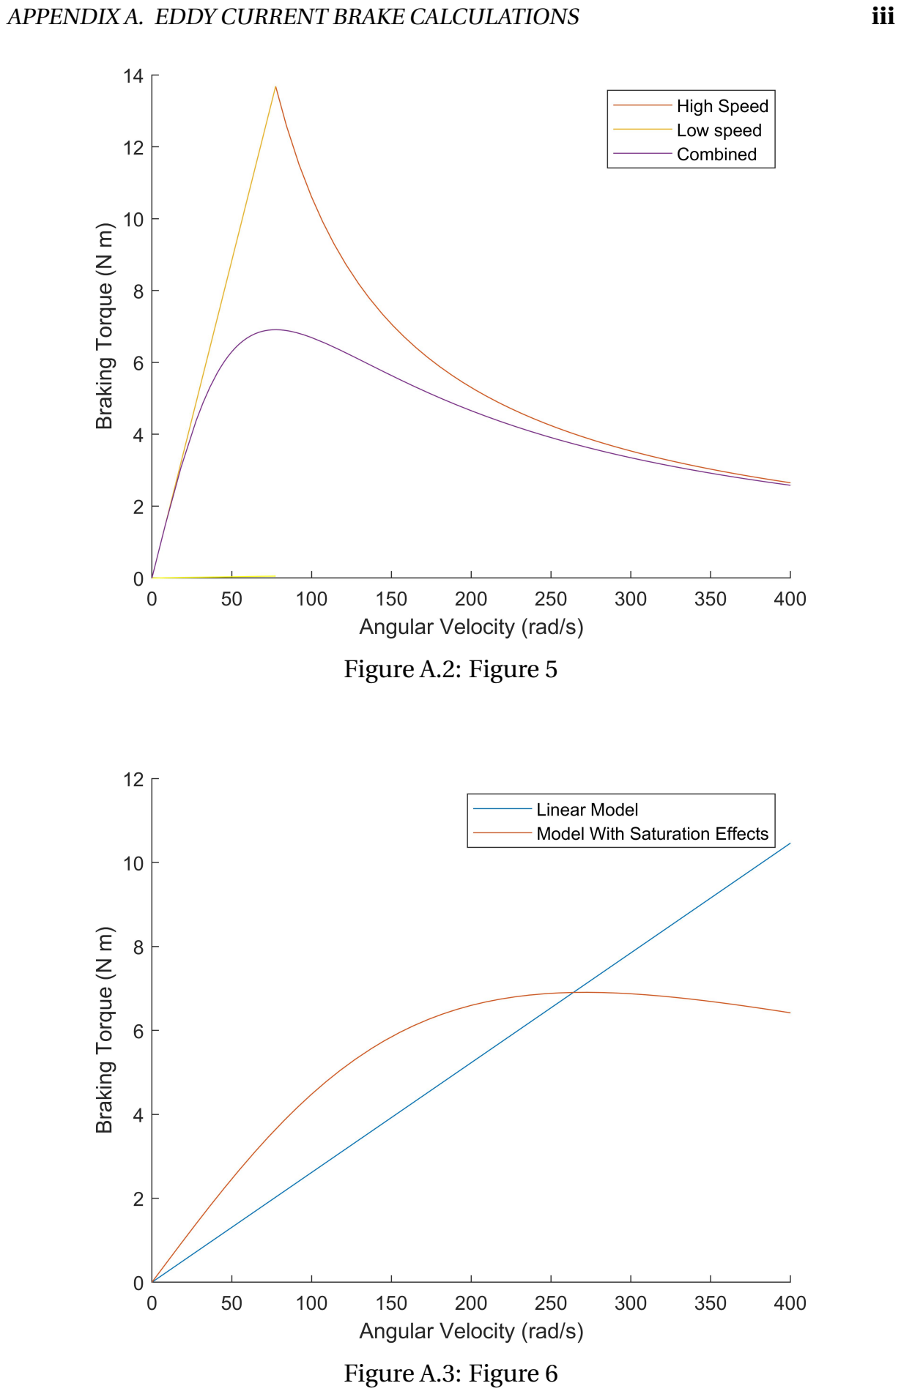
[picture p69: page 45]

APPENDIX A. EDDY CURRENT BRAKE CALCULATIONS | iii

Figure A.2: Figure 5

Figure A.3: Figure 6

# Appendix B

# Budget

Description | Supplier | Amount (R)
Stepper Motor | Micro Robotics SA | 1665. 20
Bearings 6902RS | Bearings Online SA | 392. 00
Magnets N38 | MagnetStoreSA | 392. 00
TOTAL | 4 000. 00

iv
