TheMechatronic/Skripsie-2022/Report/Safety Report/11_PDFsam_Main.pdf

# List of Figures

2.1 | Zwift Connection Overview | | 6
2.2 | Bluetooth Low Energy (BLE) Star Network Topology | 11
2.3 | Bluetooth Low Energy (BLE) Specification Structure | 12
2.4 | Bicycle Dimensions | 15
2.5 | Bicycle Dimensions | 16
2.6 | Eddy Current Brake Dimensions (To be changed ...) | 18
3.1 | Concept Boundary of Interest | 22
4.1 | Rotational Speed of Roller Size Comparison | 26
4.2 | Roller Development | 27
4.3 | Torque Requirement Curve | 28
4.4 | Disk Magnet | 29
4.5 | Flux Distribution | 30
4.6 | Figure 7 | 31
4.7 | Figure 8 | 31
5.1 | Overview of General Software Structure | 33
5.2 | Bluetooth Low Energy (BLE) Protocol Stack | 34
6.1 | Sensor Design | 42
6.2 | Motor Control Components | 43
6.3 | Nema-23 Wiring | 44
1 | Structural Lab Escape Route | vii

x
