TheMechatronic/Skripsie-2022/Report/Safety Report/12_PDFsam_Main.pdf

# List of Abbreviations

API | Application Program Interface
BLE | Bluetooth Low Energy
BR/EDR Basic Rate/Enhanced Data Rate
BSIG | Bluetooth Special Interest Group
Crr | Coefficient of Rolling Resistance
Cw | Wind Resistance Coefficient
DIS | Device Information Service
ECB | Eddy Current Brake
ERG | "Ergasia"
FE-C | Fitness Equipment - Control
FM | Fitness Machine
FTMS | Fittness Machine Data
GATT | Generic ATTribute Profile
GPIO | General Purpose Input and Output
IDE | Integrated Development Environment
IPC | Inter-Process Communicationt
LED | Light Emitting Diode
MTB | Mountain Bike
N-SOI | Narrow System of Interest
RPC | Remote Procedure Calls
rpm | Revolutions Per Minute
SIM | Indoor Bike Simulation
UHF | Ultra-High Frequency
uPVC | Unplasticized Polyvinyl Chloride
UUID | Universal Unique Identifier
W-SOI | Wider System of Interest
| xi
