TheMechatronic/Skripsie-2022/Report/Safety Report/13_PDFsam_Main.pdf

# List of Symbols

µ | Magnetic Permeability | Hm⁻¹
E | Electric Field | Vm⁻¹
J | Current | A
Br | Magnet Remanence Field | T
ω | Angular Velocity | rads⁻¹
T | Torque | Nm
F | Force | N
v | Velocity | ms⁻¹
B | Magnetic Flux Density | T
σ | Conductivity | Sm⁻¹

xii
