TheMechatronic/Skripsie-2022/Report/Safety Report/31_PDFsam_Main.pdf

CHAPTER 2. LITERATURE REVIEW | 18

Mathematical Model

Smythe first proposed a mathematical model that includes two distinct torque regions. Below the critical speed, the torque vs. speed relation is approximately linear, and the high speed region approaches some constant. This model was the further expanded and improved by Smythe (1950).

Wouterse (1991) proposed a model for the induced torque at the critical speed, as the torque in this region cannot be expressed simply as a function of magnetic flux and disk speed.

Baum and Eberhardt (2016) proposed a model for the performance of an ECB with two pole pairs on a rotating conductive disk. This model builds on the work of Smythe (1950) and Wouterse (1991) to take into account the saturation of the disk and the demagnetization effect of the induced magnetic flux on the magnets. This results in Equation 2.6 for the low speed region and Equation 2.7 for the high speed region. The critical speed is found by equating these two equations.

FLowSpeed = npai r s ·σ· v ·B0

2
- Amag net ·tdi sk | (2.6)

F Hi g hSpeed = npai r s ·

1
v

·t

2
mag net ·

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
2Dmag net

tdi sk ·δdmag net s

(2.7)

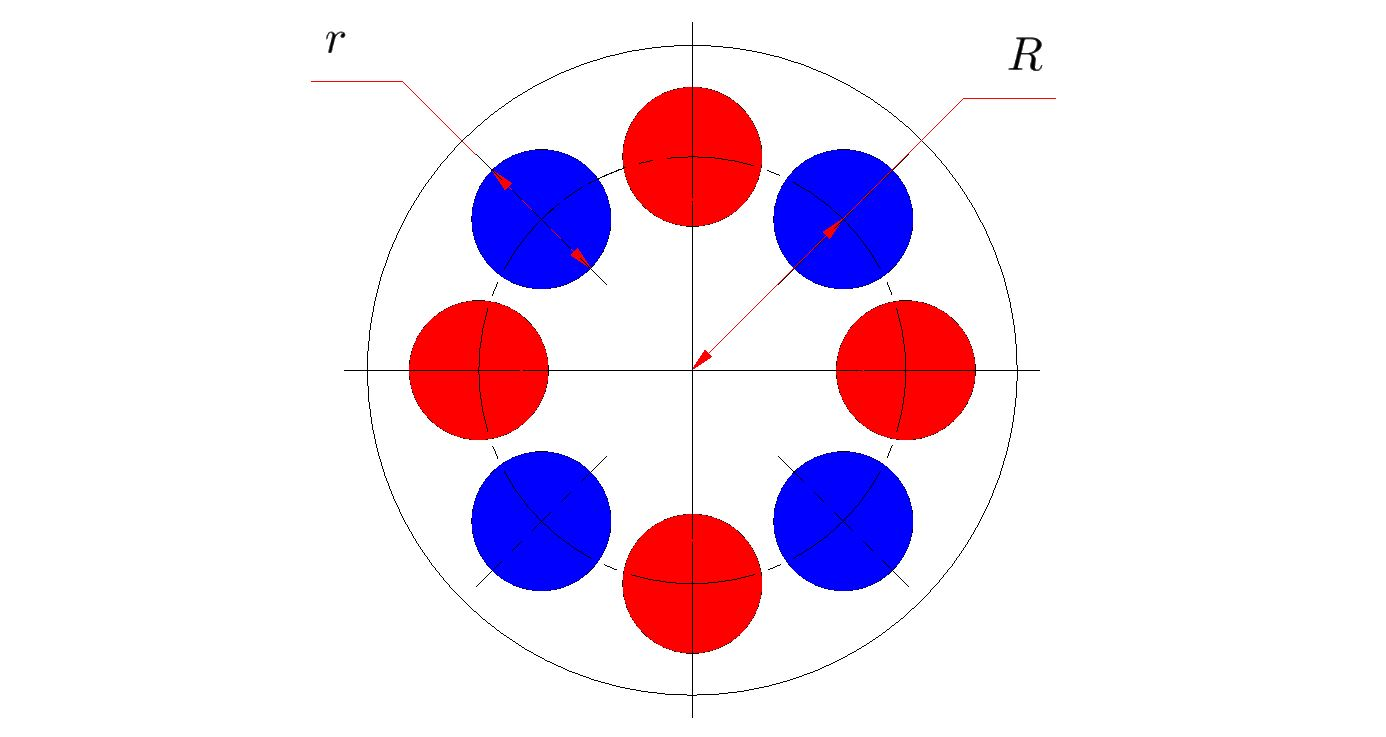
[picture p74: figure]

Figure 2.6: Eddy Current Brake Dimensions (To be changed ...)
