TheMechatronic/Skripsie-2022/Report/Safety Report/32_PDFsam_Main.pdf

CHAPTER 2. LITERATURE REVIEW | 19

## 2.7 Sensor Technology
