TheMechatronic/Skripsie-2022/Report/Safety Report/40_PDFsam_Main.pdf

CHAPTER 4. HARDWARE DEVELOPMENT | 27

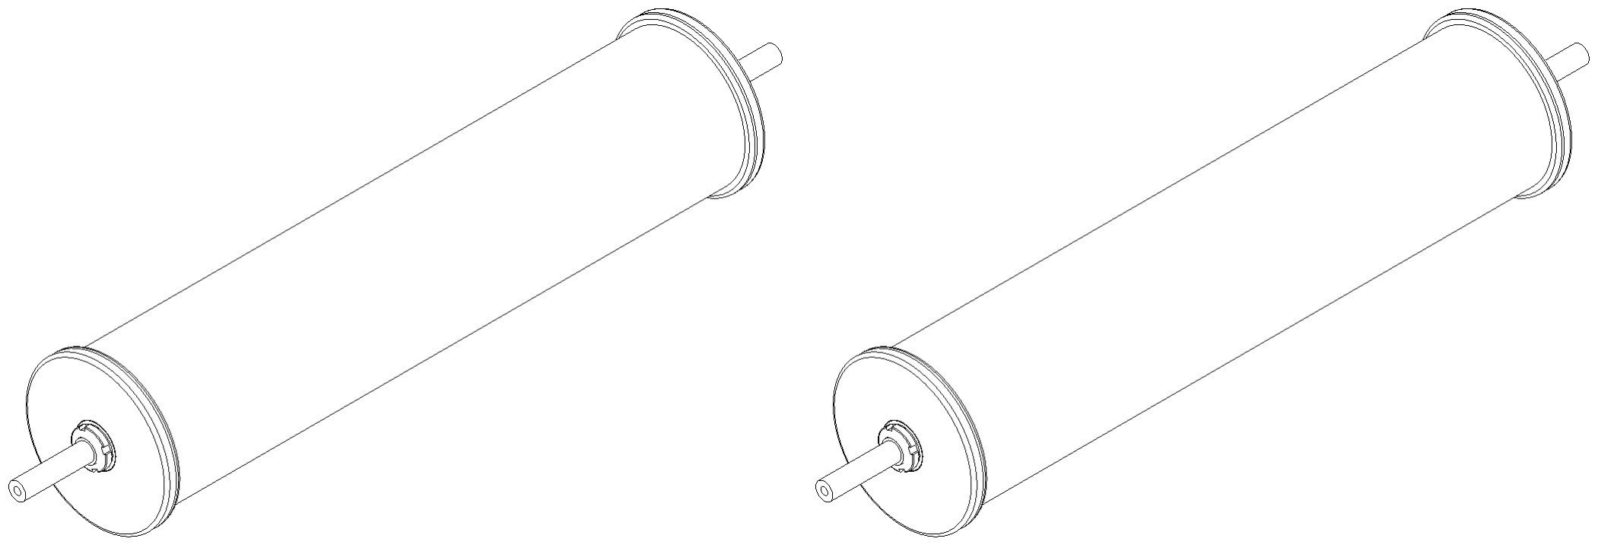
[picture p77: figure]

(a) Roller Design | (b) Built Roller

Figure 4.2: Roller Development

For the two front idler rollers, the uPVC pipe and end-caps rotate freely on a a fixed shaft, and are coupled together with a rubber elastic band that is used on existing roller models. The rear roller is attached to the shaft with a key at both end-caps in order to allow for force to be transferred from the braking unit to the rear wheel of the cyclist.
