TheMechatronic/Skripsie-2022/Report/Safety Report/42_PDFsam_Main.pdf

CHAPTER 4. HARDWARE DEVELOPMENT | 29


(a) Neodymium Disk Magnet | (b) B Field Calculation

Figure 4.4: Disk Magnet

(Addapted from Supermagnete)

B =

Br
2

(

t + z
p
r

2 + t + z

2

−

z
r

2 + z

2

) | (4.1)
