TheMechatronic/Skripsie-2022/Report/Safety Report/49_PDFsam_Main.pdf

CHAPTER 5. SOFTWARE DEVELOPMENT | 36

### 5.3 Sensor Data Measuring and Logging
