TheMechatronic/Skripsie-2022/Report/Safety Report/50_PDFsam_Main.pdf

CHAPTER 5. SOFTWARE DEVELOPMENT | 37

## 5.4 Power Calculations
