TheMechatronic/Skripsie-2022/Report/Safety Report/51_PDFsam_Main.pdf

CHAPTER 5. SOFTWARE DEVELOPMENT | 38

## 5.5 Motor Control
