TheMechatronic/Skripsie-2022/Report/Safety Report/53_PDFsam_Main.pdf

CHAPTER 6. ELECTRONICS DESIGN | 40

## 6.1 Raspberry Pi setup

Pi voltage range = 1.8V to 3.3V (High)
