TheMechatronic/Skripsie-2022/Report/Safety Report/55_PDFsam_Main.pdf

CHAPTER 6. ELECTRONICS DESIGN | 42

R =

V
I

(6.1)

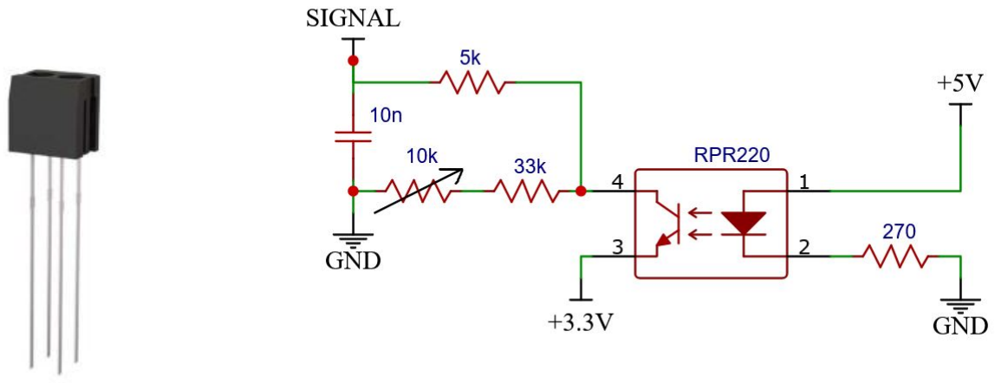
[picture p79: figure]

(a) RPR-220 Photoreflector

(RPR-220)

(b) Sensor Biasing and Filter Circuit

Figure 6.1: Sensor Design

Thus, with the 3.3 V source and 0.8 mA of current, the resistor value can be calculated using equation 6.1 as 4125 Ω. This, however, is for the ideal case, and a much lower percentage can be expected to reflect when the sensor is implemented. For the design, a reflection of 90 % at a distance of 6 mm where the data sheet indicates the current will be 0.3 mA. Following the same calculation, a resistor value of 11 kΩ is determined.

fc =

1
2RC

(6.2)
