TheMechatronic/Skripsie-2022/Report/Safety Report/57_PDFsam_Main.pdf

CHAPTER 6. ELECTRONICS DESIGN | 44


Figure 6.3: Nema-23 Wiring

## 6.4 Electronics Overview
