TheMechatronic/Skripsie-2022/Report/Safety Report/58_PDFsam_Main.pdf

# List of References

Abt, S. (2022 July 28). cycling. [online].
Availible at: https://www.britannica.com/sports/cycling.
[Accessed 22 September 2022].

Alff, D. (2011 February). The world’s best bicycle trainers: A complete guide. [online]. Availible at: https://bicycletouringpro.com/bicycle-trainers/.
[Accessed 24 April 2022].

Baum, E. and Eberhardt, S. (2016 June 27). Eddy current brake with two pole pairs. COMPEL
- The international journal for computation and mathematics in electrical and electronic engineering, vol. 28, no. 1, pp. 67–76.

Bluetooth® Service Specification (2017 February 14). Fitness machine service v1.0 [online].

Availible at: https://www.bluetooth.org/DocMan/handlers/DownloadDoc.ashx?doc_

id=423422. (https://www.bluetooth.org/DocMan/handlers/DownloadDoc.ashx?doc_id=423422)
[Accessed 1 January 2022].

Communica (2022). Hkd tb6600 stepper driver 4.5a. [online].
Availible at: https://www.communica.co.za/products/hkd-tb6600-stepper-driver-

4-5a. (https://www.communica.co.za/products/hkd-tb6600-stepper-driver-4-5a)
[Accessed 20 September 2022].

Gay, S.E. (2005). Contactless Magnetic Brake for Automotive Applications. Master’s thesis, Electrical Engineering, Texas A&M University, Texas, USA.

Geometry Geeks (2022). Find and compare bike geometry. [online].
Availible at: https://geometrygeeks.bike/.
[Accessed 18 September 2022].

Huawei (2022 September 16). Ftms characteristics. [online].
Availible | at: | https://developer.huawei.com/consumer/en/doc/development/
HMSCore-Guides/ftms-list-0000001055208574. (https://developer.huawei.com/consumer/en/doc/development/HMSCore-Guides/ftms-list-0000001055208574)
[Accessed 23 September 2022].

45
