TheMechatronic/Skripsie-2022/Report/Safety Report/60_PDFsam_Main.pdf

LIST OF REFERENCES | 47

Townsend, K., Cufi, C., Akiba and Davidson, R. (2014 May). Getting Started with Bluetooth Low Energy. O’Reilly Media, Inc., https://www.oreilly.com/library/view/gettingstarted-with/9781491900550/ch04.html. (https://www.oreilly.com/library/view/getting-started-with/9781491900550/ch04.html) ISBN 9781491949511.

Wouterse, J. (1991). Critical torque and speed of eddy current brake with widely separated soft iron poles. IEE Proceedings-B, vol. 138, no. 4, pp. 153–158.

Zwift (2022). Official zwift website. [online].
Availible at: https://www.zwift.com/.
[Accessed 22 September 2022].

Zwift Forums (2022 January 2). Improvements to ftms controllable trainers [online].
Availible | at: | https://forums.zwift.com/t/bluetooth-improvements-for-
controllable-trainers-treadmills-january-2022/569781/38?page=4. (https://forums.zwift.com/t/bluetooth-improvements-for-controllable-trainers-treadmills-january-2022/569781/38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) [Accessed 1 January 2022].
