TheMechatronic/Skripsie-2022/Report/Safety Report/61_PDFsam_Main.pdf

# Appendix C

# Safety Report

Description | Supplier | Amount (R)
Stepper Motor | Micro Robotics SA | 1665. 20
Bearings 6902RS | Bearings Online SA | 392. 00
Magnets N38 | MagnetStoreSA | 392. 00
Fasteners | BMG | 130. 63
Power Supply | Micro Robotics SA | 339. 25
Electronic Components | Micro Robotics SA | 319. 70
Class 12 uPVC Pipe | Cape Agri Mark | 729. 00
TOTAL | | 4 000. 00

i
