TheMechatronic/Skripsie-2022/Report/Safety Report/9_PDFsam_Main.pdf

CONTENTS | viii
2.3 Bluetooth Low Energy (BLE) Communication | 11
2.4 Existing Trainer Technology | 15
2.5 Bicycle Specifications | 16
2.6 Eddy Current Brake | 17
2.7 Sensor Technology | 19
3 Concept Design and Evaluation | 20
3.1 Requirement Analysis | 21
3.2 Concept Design | 22
3.3 Concept Evaluation | 24
4 Hardware Development | 25
4.1 Roller Design | 26
4.2 Eddy Current Brake Design | 28
5 Software Development | 32
5.1 Structure | 33
5.2 Bluetooth Low Energy (BLE) Handler | 33
5.3 Sensor Data Measuring and Logging | 36
5.4 Power Calculations | 37
5.5 Motor Control | 38
6 Electronics Design | 39
6.1 Raspberry Pi setup | 40
6.2 Speed Sensor Design | 41
6.3 Motor Control | 43
6.4 Electronics Overview | 44
List of References | 45
C Safety Report | i
