TheMechatronic/Skripsie-2022/Report/FrontMatter.tex

% Title: Report LaTex File: Front Matter
% Auther: DC Eksteen
% Student Number: 22623906
% Contact: 22623906@sun.ac.za
% Date: 2022/09/14
% Version: 2.0

\begin{singlespace}
	\TitlePage
\end{singlespace}

\DeclarationDate{\today}
\DeclarationPage

\SummeryPage
\ECSApage
% \ECSApageInfo % Include to see the requirements for the ECSA outcomes
\tableofcontents
\listoftables
\listoffigures

\newpage
\printacronyms[include=abbrev,name={List of Abbreviations}, heading=chapter, template=tabular]
