TheMechatronic/Skripsie-2022/Design/Drawings/MEASURING WHEEL.pdf

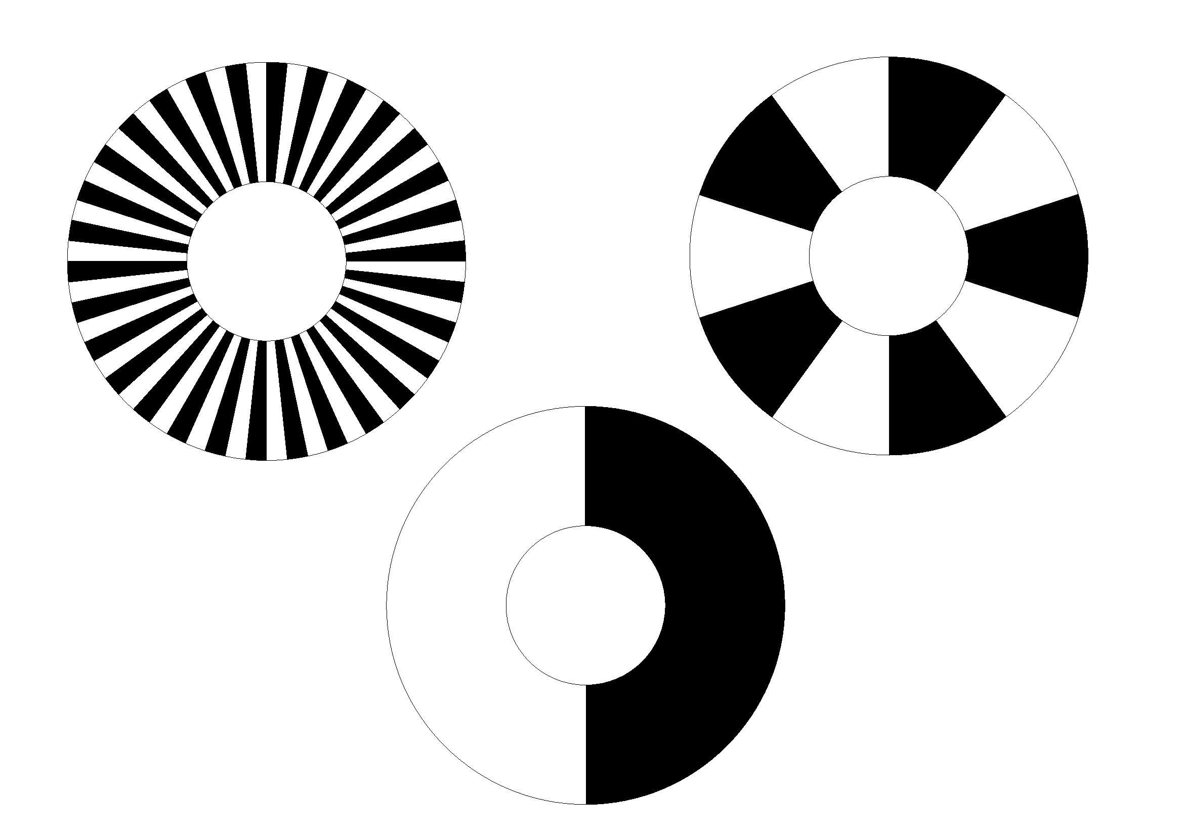
[picture p86: page 1]
