TheMechatronic/Skripsie-2022/Report/Safety Report/43_PDFsam_Main.pdf

CHAPTER 4. HARDWARE DEVELOPMENT | 30


(a) 0◦ Phase | (b) 60◦ Phase


(c) 120◦ Phase | (d) 180◦ Phase


Figure 4.5: Flux Distribution
