TheMechatronic/Skripsie-2022/Report/Safety Report/44_PDFsam_Main.pdf

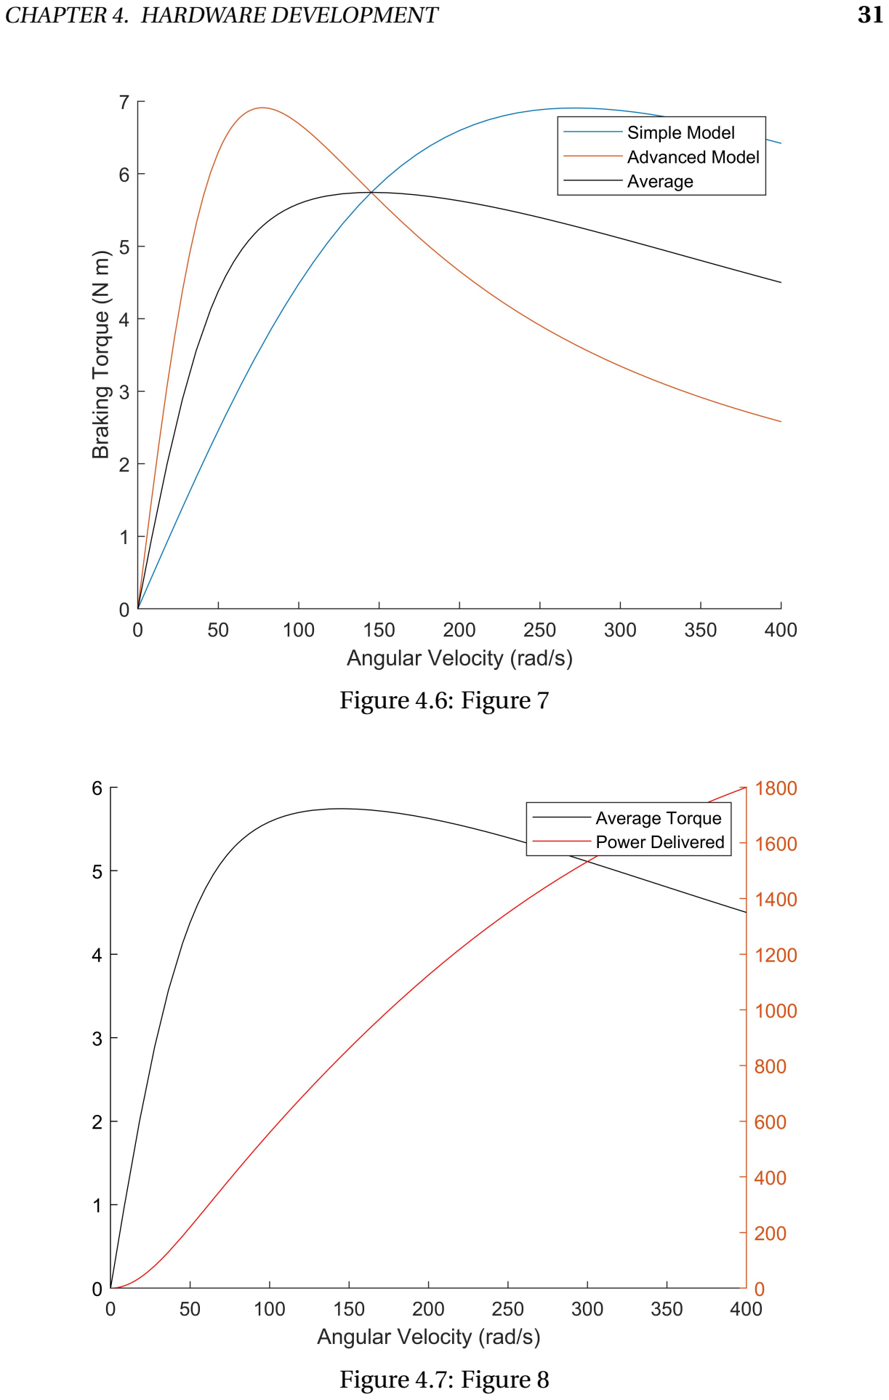
[picture p88: page 1]

CHAPTER 4. HARDWARE DEVELOPMENT | 31

Figure 4.6: Figure 7

Figure 4.7: Figure 8
