TheMechatronic/Skripsie-2022/Report/Safety Report/8_PDFsam_Main.pdf

# Contents

Declaration | i
Executive Summary | ii
ECSA Exit Level Outcome Evaluation | iv
Contents | vii
List of Tables | ix
List of Figures | x
List of Abbreviations | xi
List of Symbols | xii
1 Introduction | 1
1.1 Background | | 1
1.2 Aim and Objectives | | 3
1.3 Motivation | | 4
2 Literature Review | 5
2.1 Zwift Technical Requirements | | 6
2.1.1 Basic Requirements | | 6
2.1.2 Training Platform Requirements | | 7
2.2 Bluetooth Low Energy (BLE) vs ANT+ | | 8
2.2.1 ANT+ Fitness Equipment - Control | | 9
2.2.2 Bluetooth Low Energy (BLE) for Fitness Devices | | 9

vii
