TheMechatronic/Skripsie-2022/Design/Drawings/IDLE ROLLER.bmp

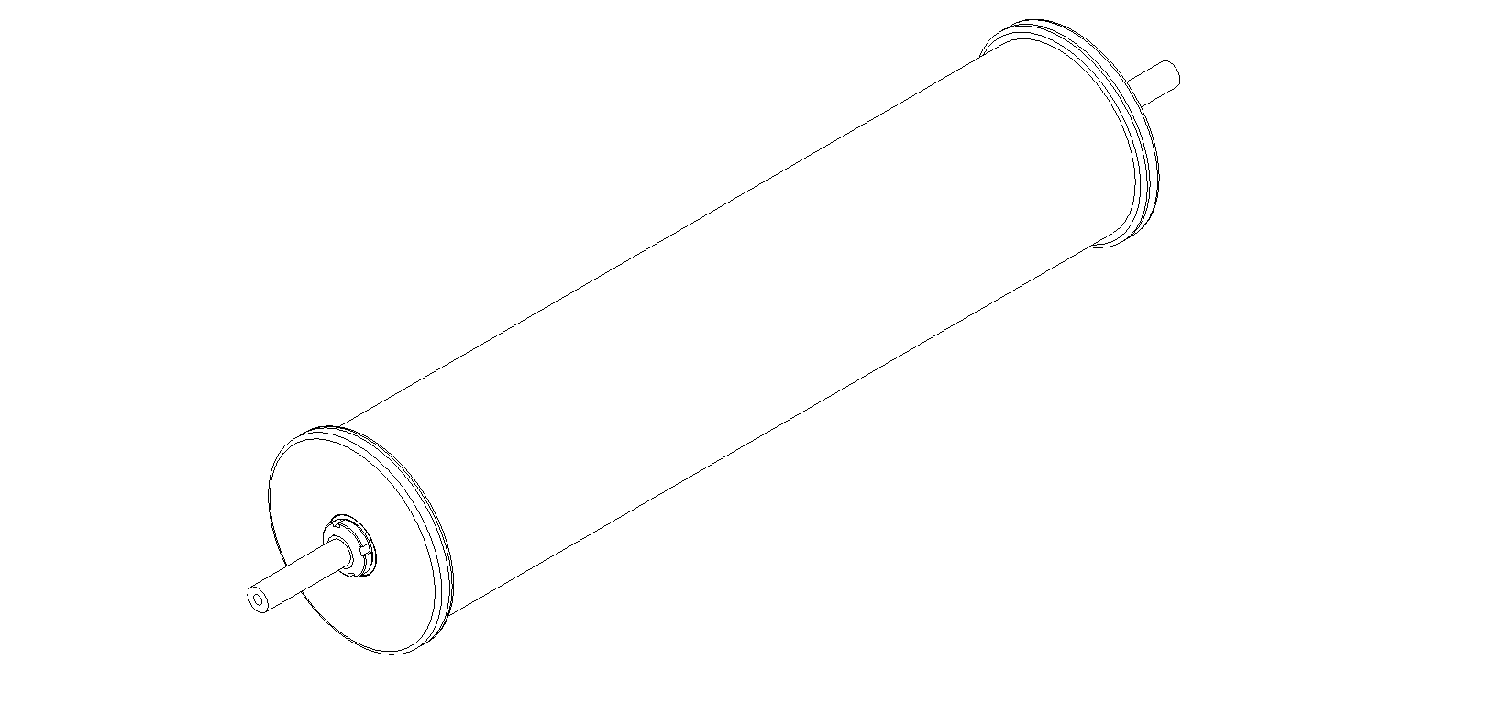
Design/Drawings/IDLE ROLLER.bmp
