TheMechatronic/Skripsie-2022/Design/Drawings/IDLE ROLLER.png

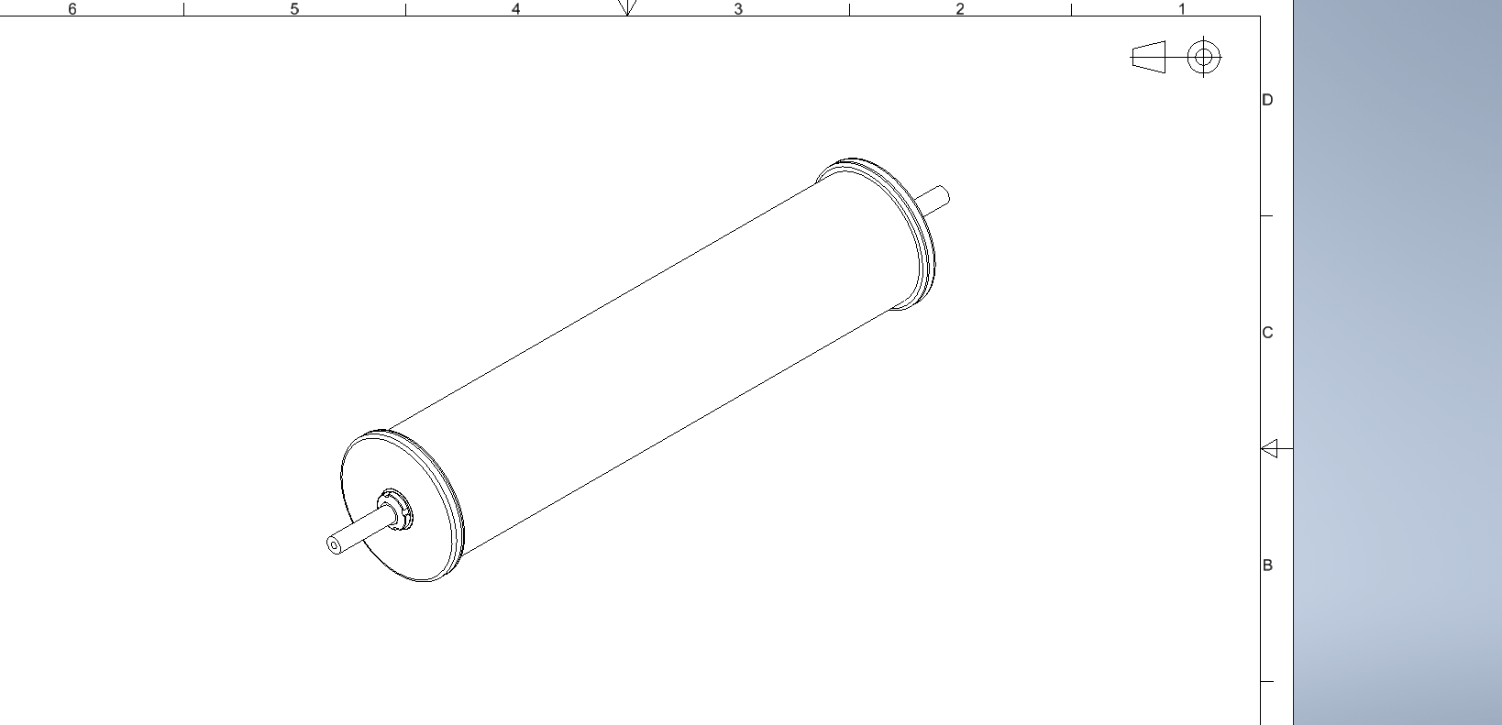
Design/Drawings/IDLE ROLLER.png
