TheMechatronic/Skripsie-2022/Design/Drawings/MEASURING WHEEL.bmp

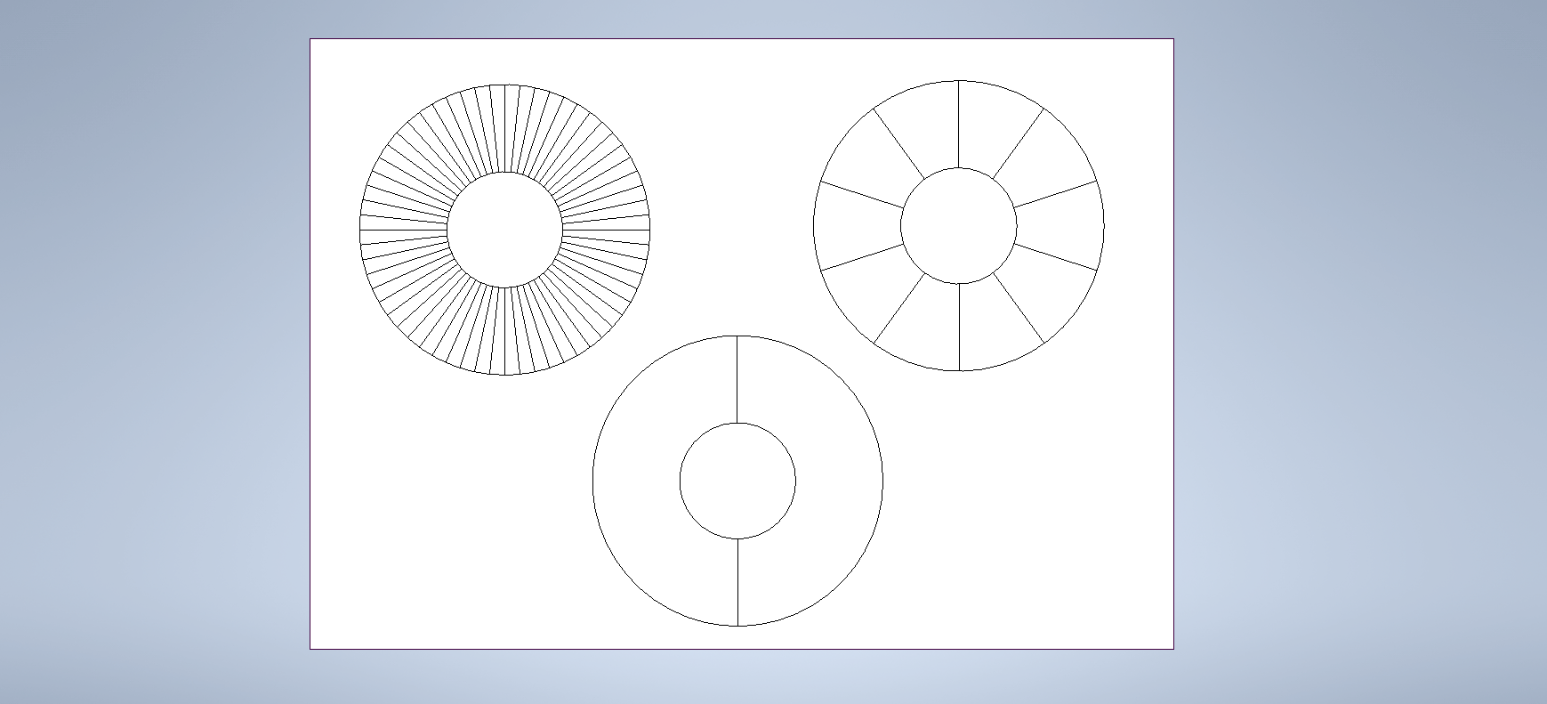
Design/Drawings/MEASURING WHEEL.bmp
