TheMechatronic/Skripsie-2022/Design/Drawings/MEASURING WHEEL.jpg

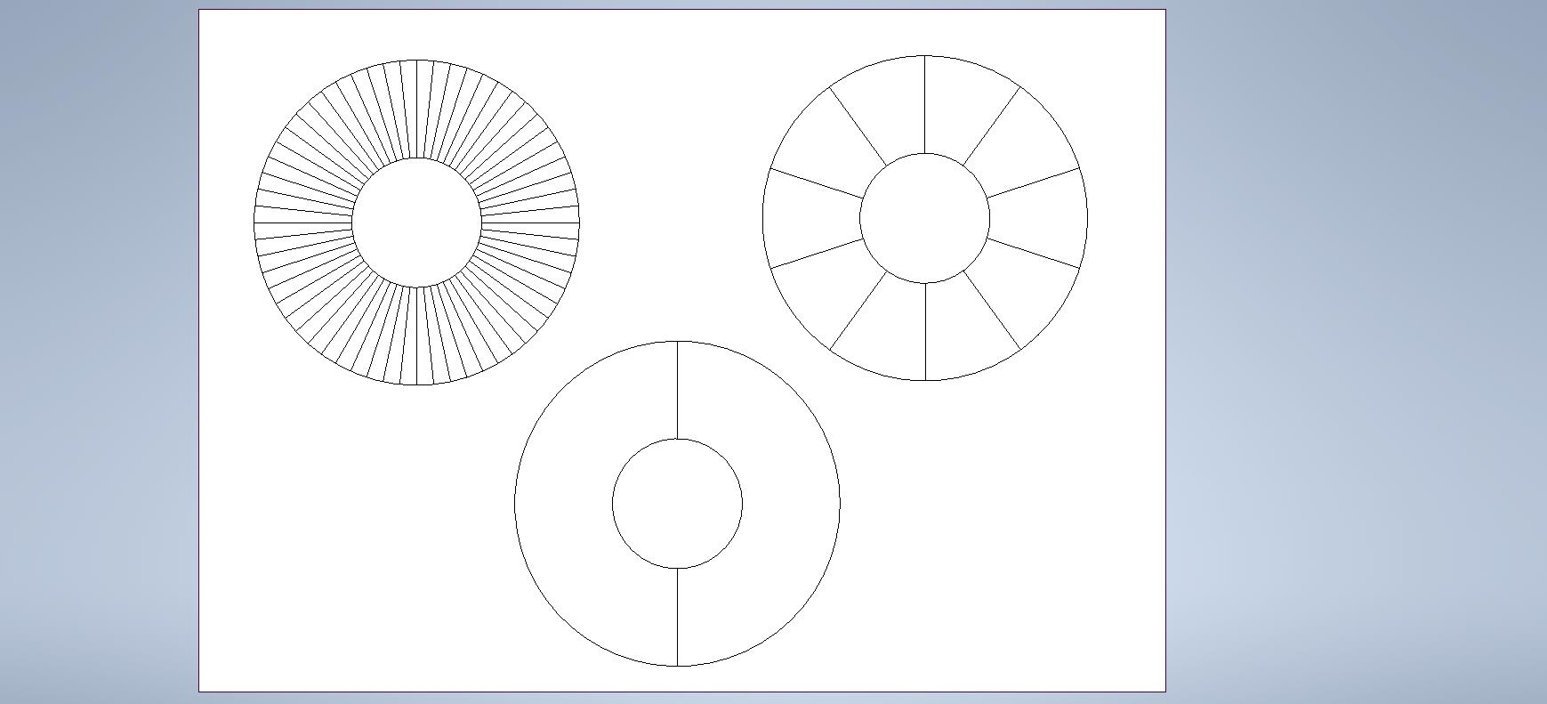
Design/Drawings/MEASURING WHEEL.jpg
