TheMechatronic/Skripsie-2022/Raw/IMG_2095.jpg

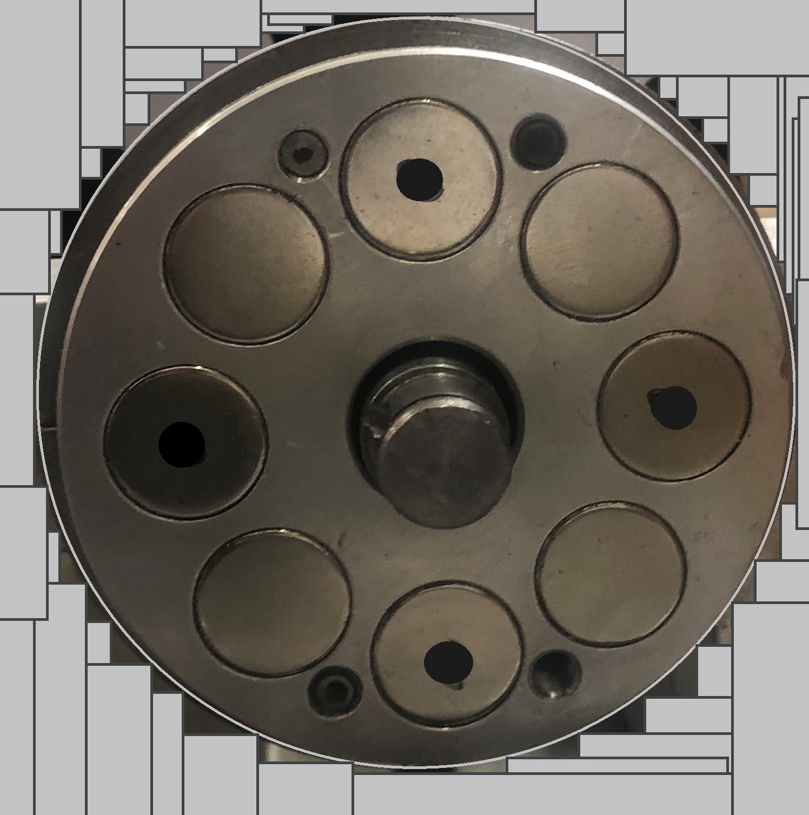
Raw/IMG_2095.jpg
