TheMechatronic/Skripsie-2022/Raw/IMG_2172.jpg

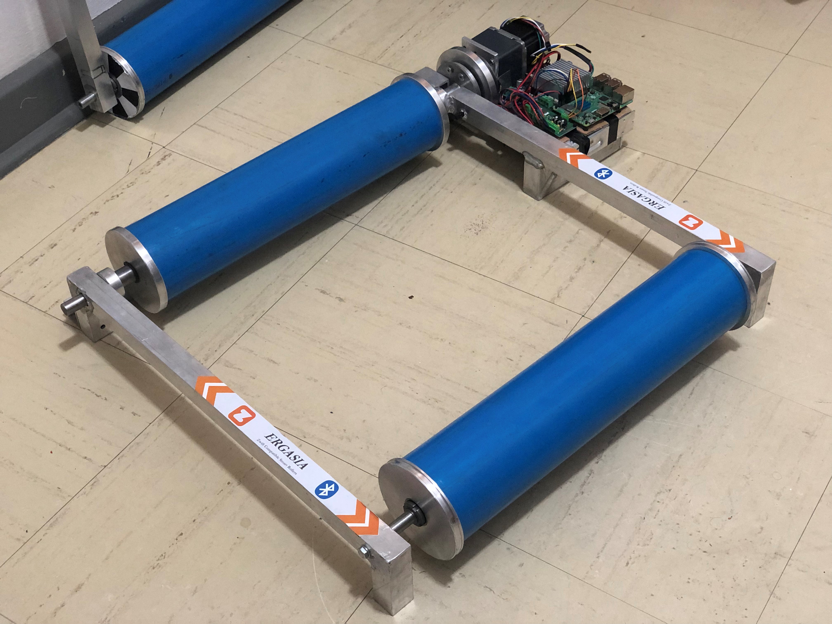
Raw/IMG_2172.jpg
