TheMechatronic/Skripsie-2022/Raw/IMG_2173.jpg

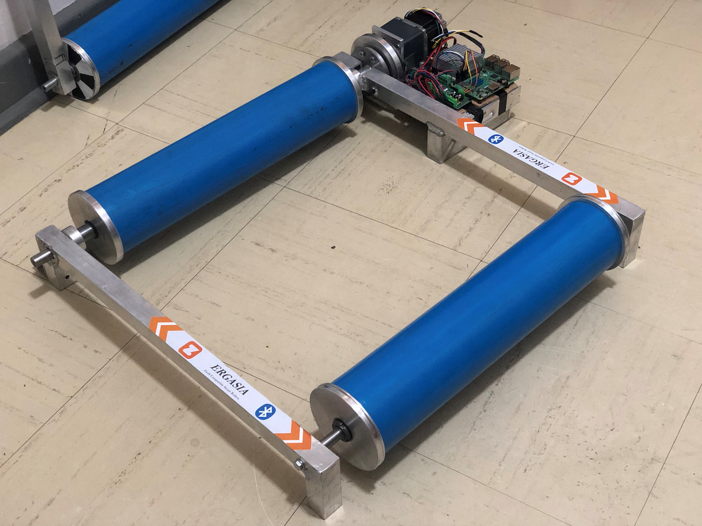
Raw/IMG_2173.jpg
