TheMechatronic/Skripsie-2022/Raw/IMG_2175.jpg

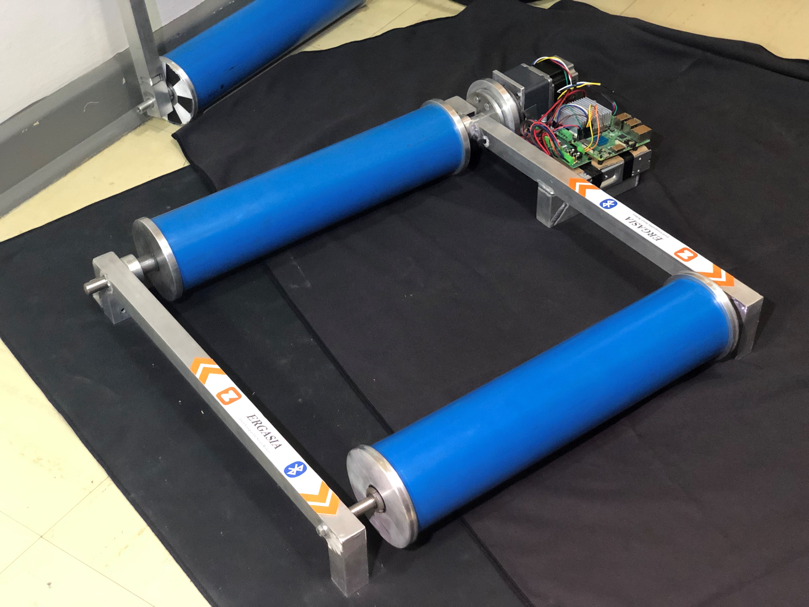
Raw/IMG_2175.jpg
