TheMechatronic/Skripsie-2022/Raw/IMG_2176.jpg

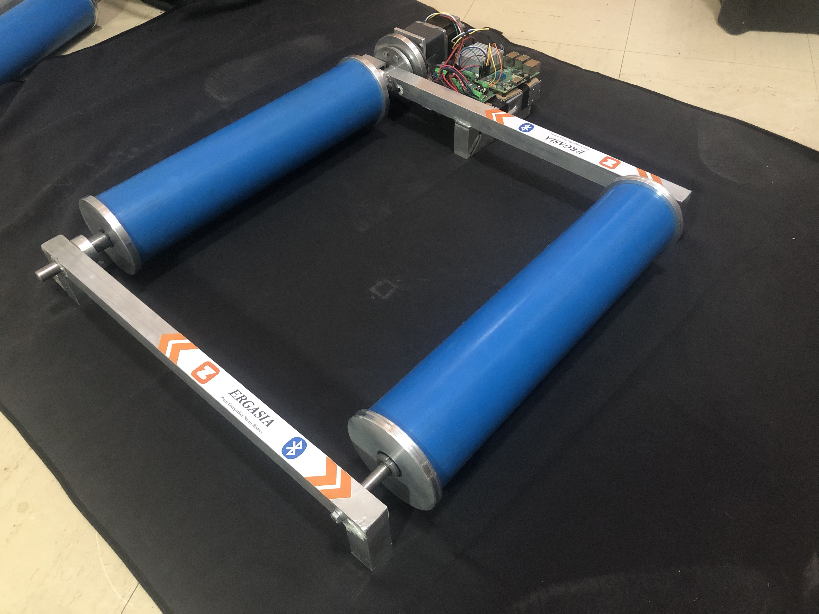
Raw/IMG_2176.jpg
