TheMechatronic/Skripsie-2022/Raw/IMG_2183.jpg

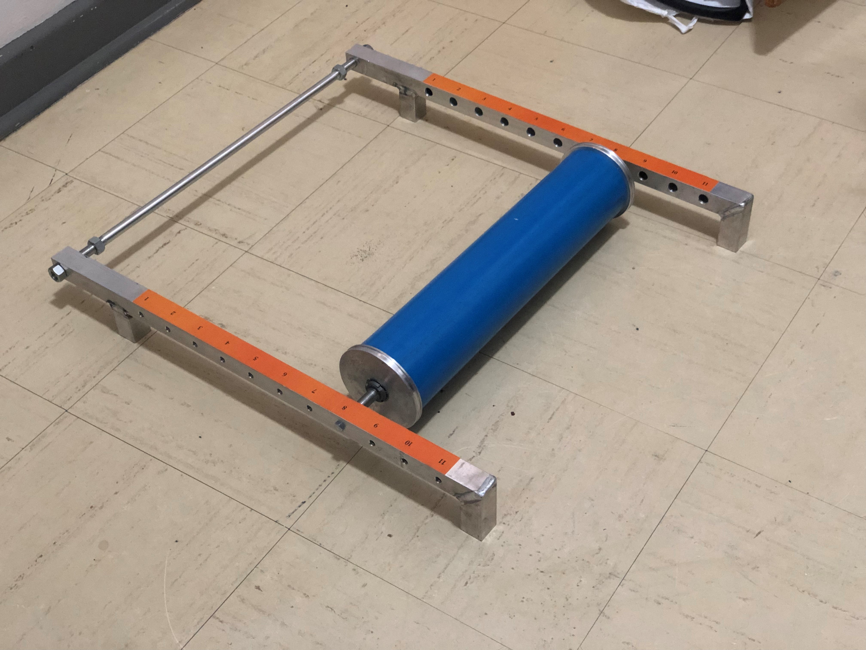
Raw/IMG_2183.jpg
