TheMechatronic/Skripsie-2022/Report/graphics/Bearings.JPG

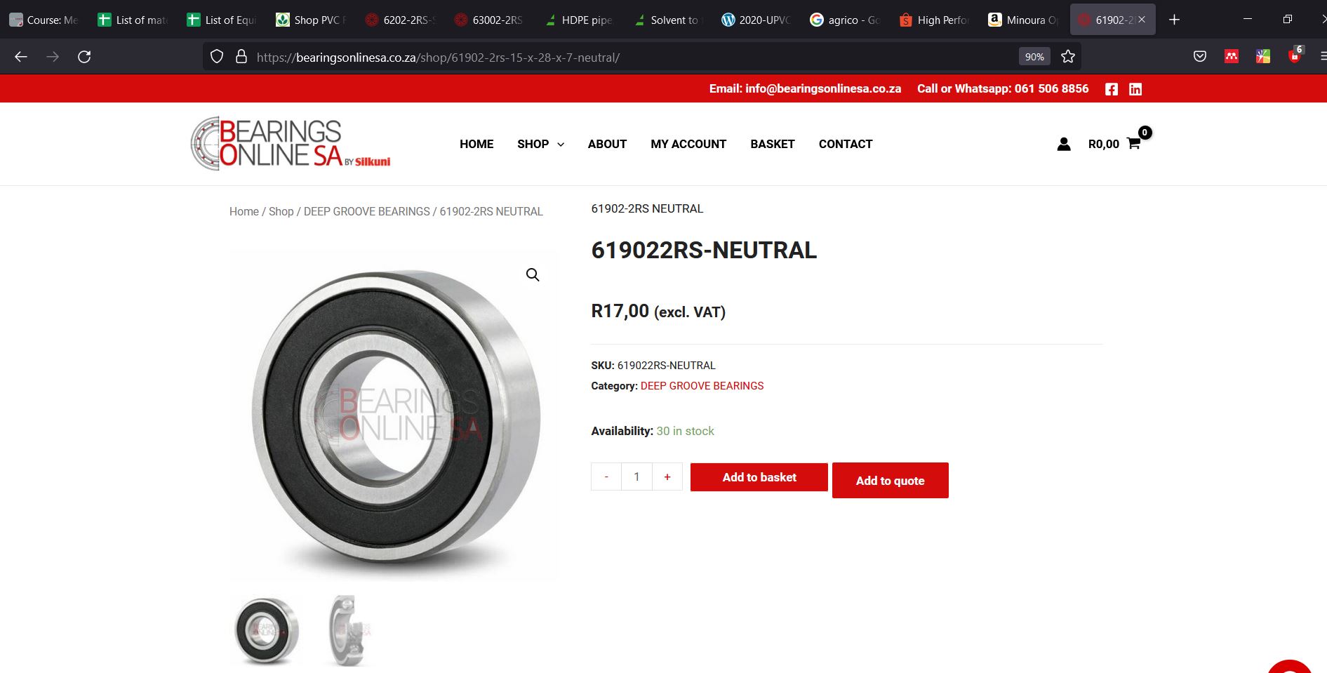
Report/graphics/Bearings.JPG
