TheMechatronic/Skripsie-2022/Report/graphics/Bfieldcalc.JPG

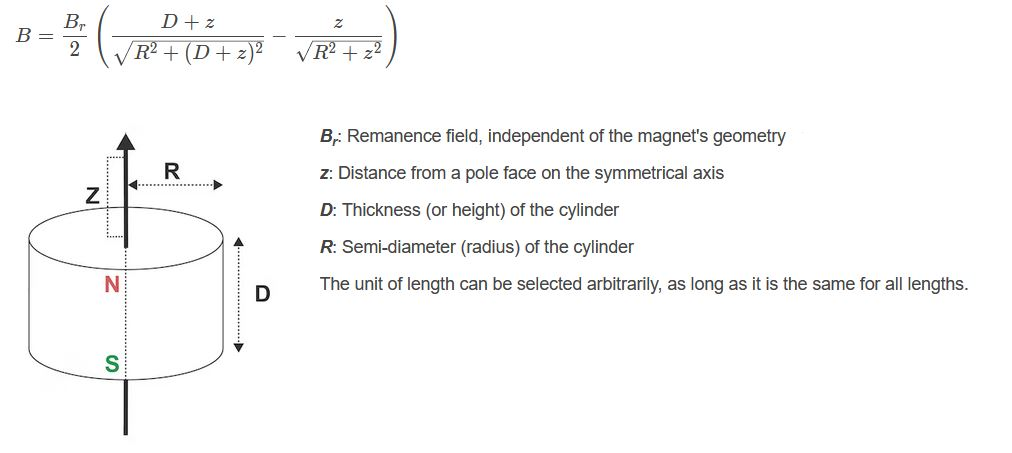
Report/graphics/Bfieldcalc.JPG
