TheMechatronic/Skripsie-2022/Report/graphics/BMG QUOTE.JPG

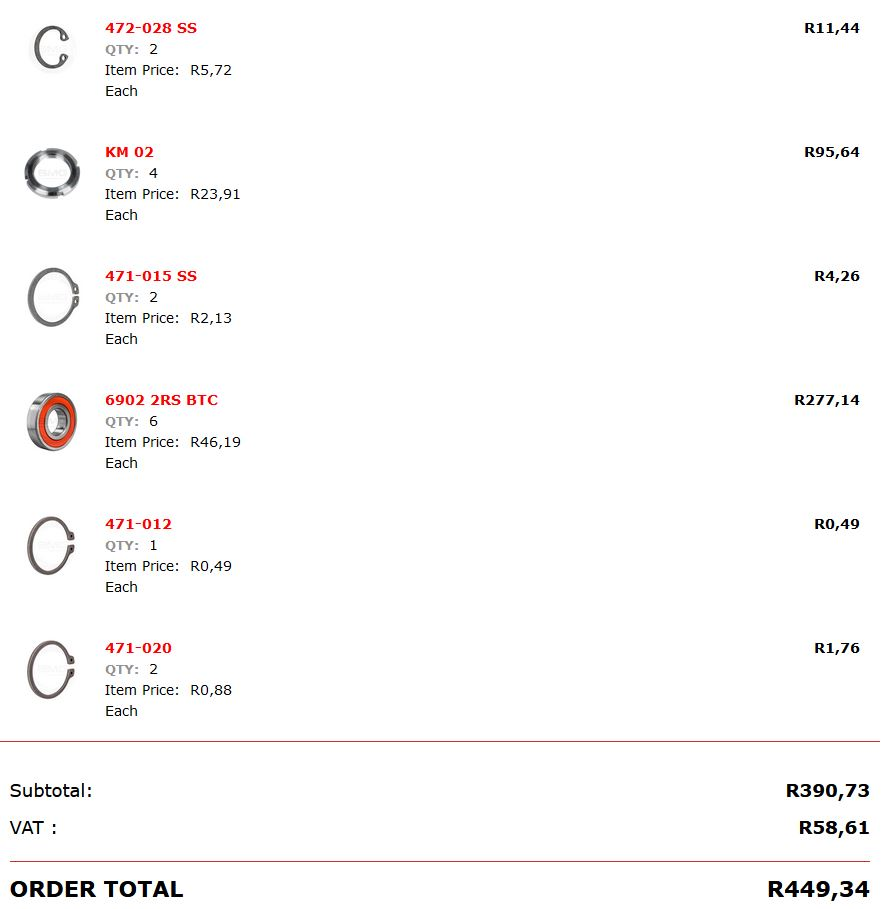
Report/graphics/BMG QUOTE.JPG
