TheMechatronic/Skripsie-2022/Report/graphics/Brake Exploded View.JPG

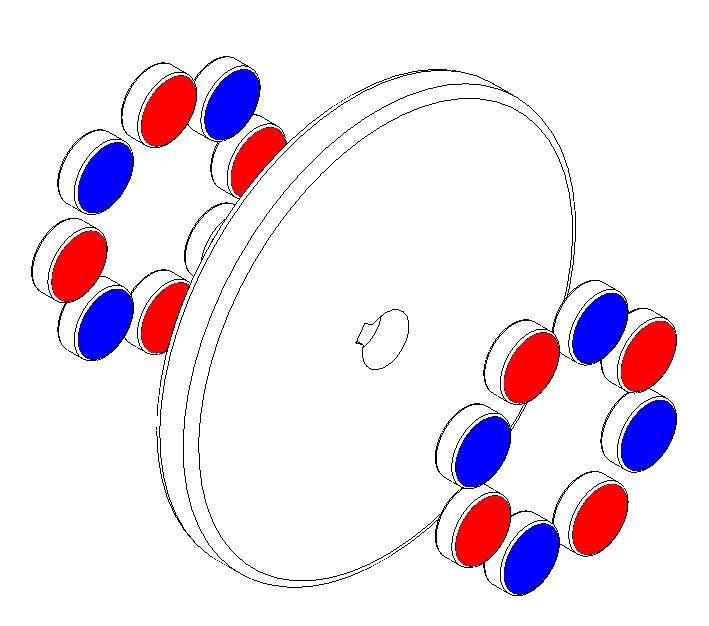
Report/graphics/Brake Exploded View.JPG
