TheMechatronic/Skripsie-2022/Report/graphics/CIRCLIPS.JPG

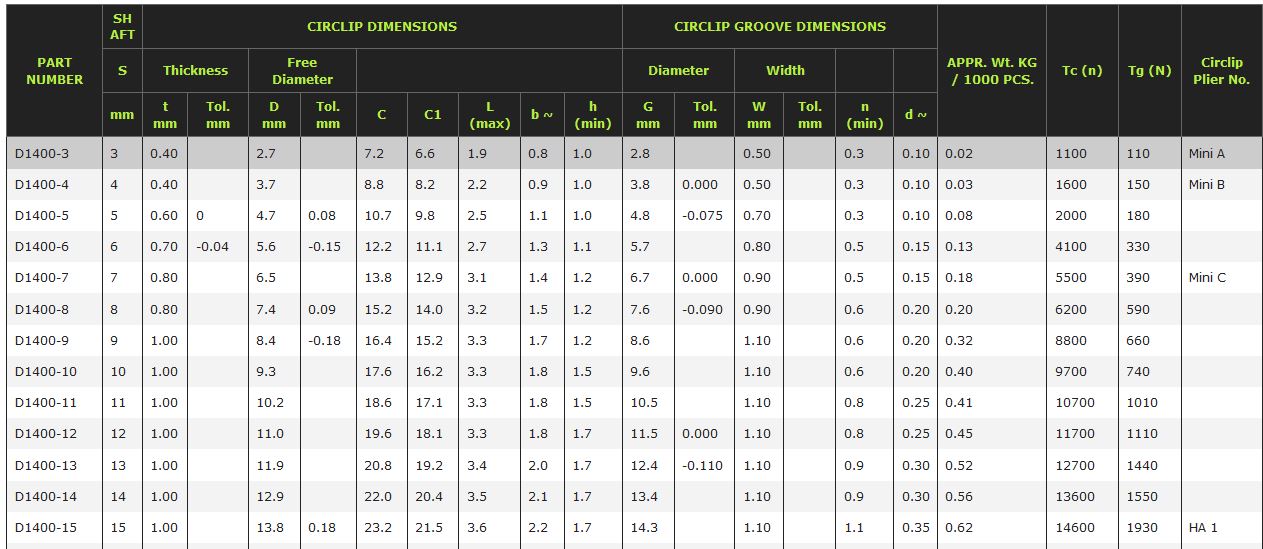
Report/graphics/CIRCLIPS.JPG
