TheMechatronic/Skripsie-2022/Report/graphics/Fig5.jpg

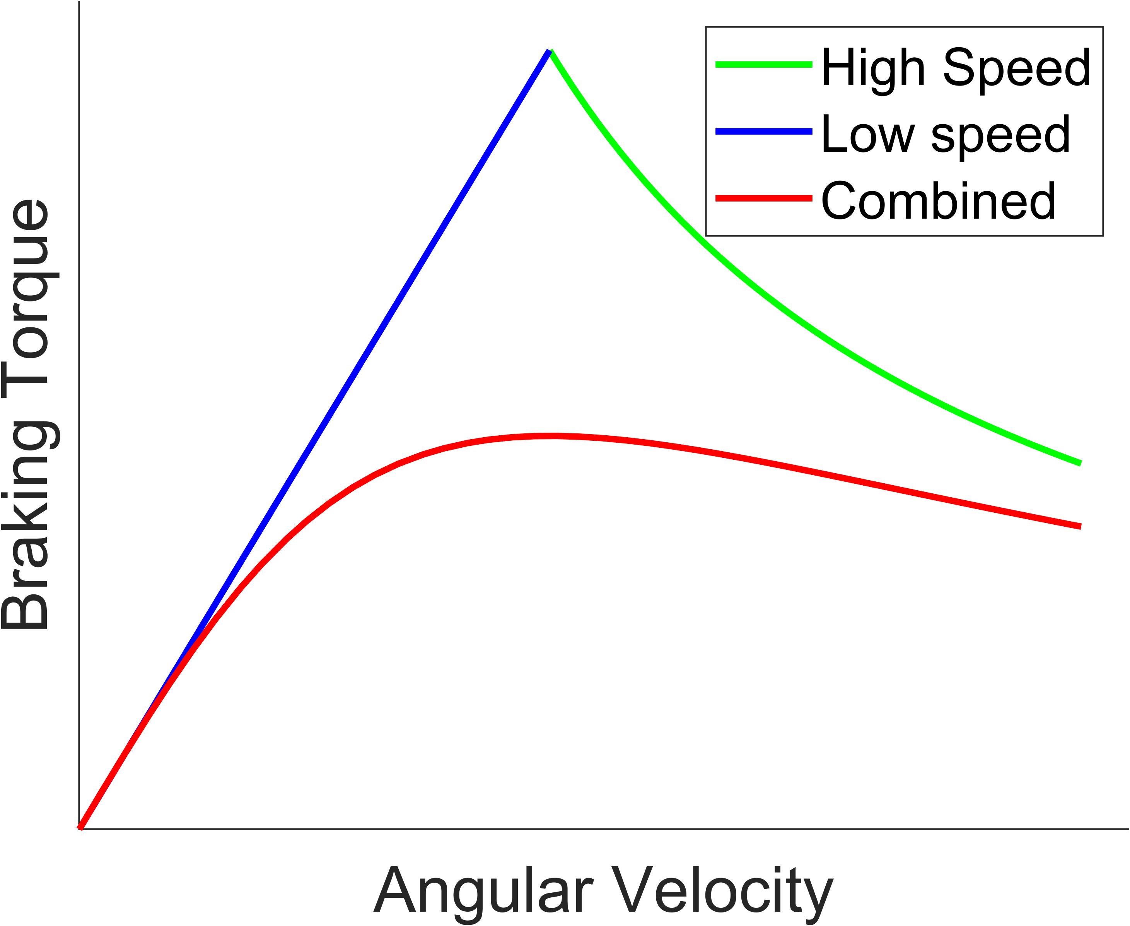
Report/graphics/Fig5.jpg
