TheMechatronic/Skripsie-2022/Report/graphics/Fig6.jpg

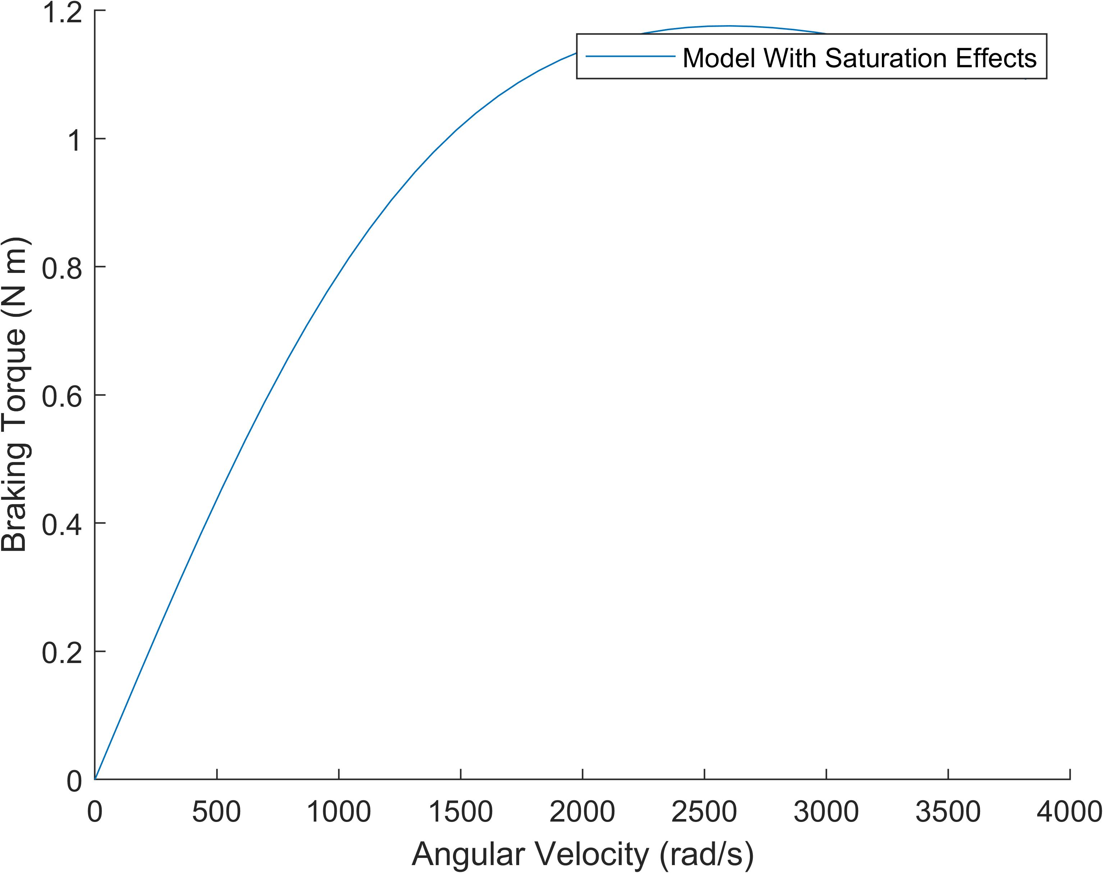
Report/graphics/Fig6.jpg
