TheMechatronic/Skripsie-2022/Report/graphics/Fig7.jpg

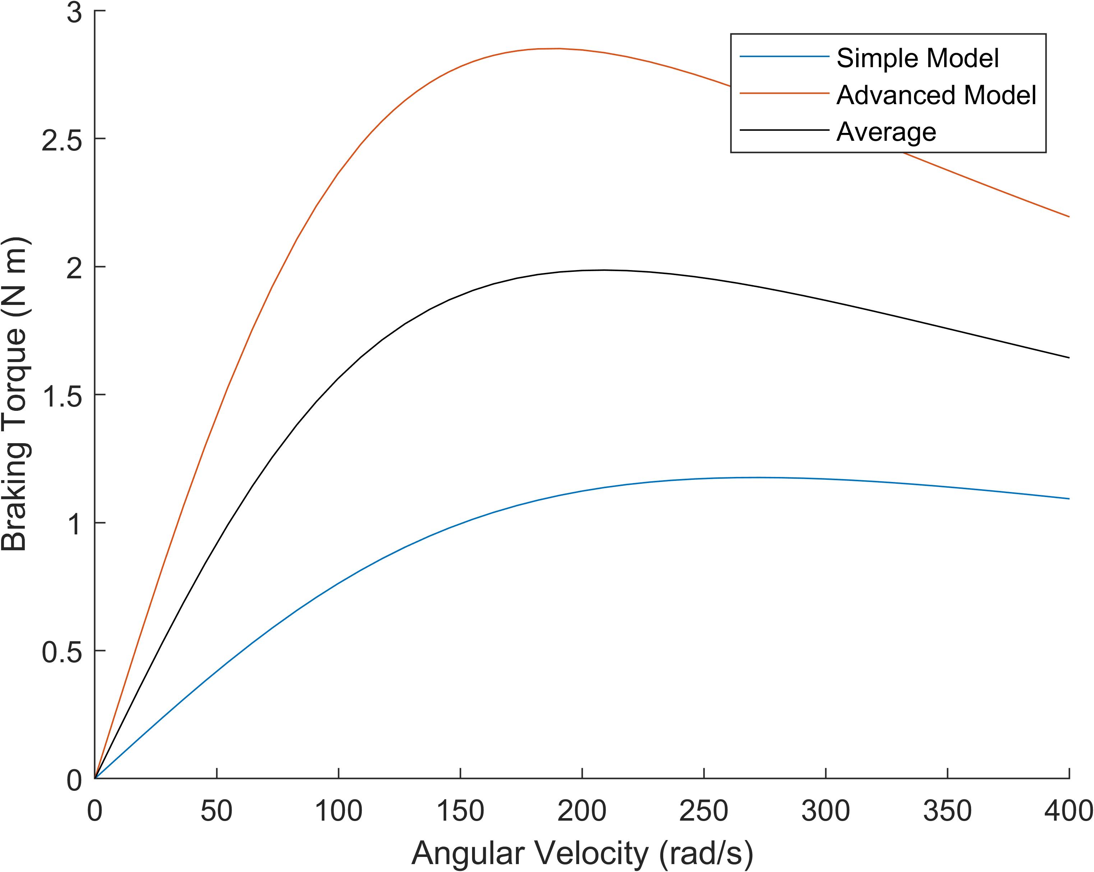
Report/graphics/Fig7.jpg
