TheMechatronic/Skripsie-2022/Report/graphics/Fig8.jpg

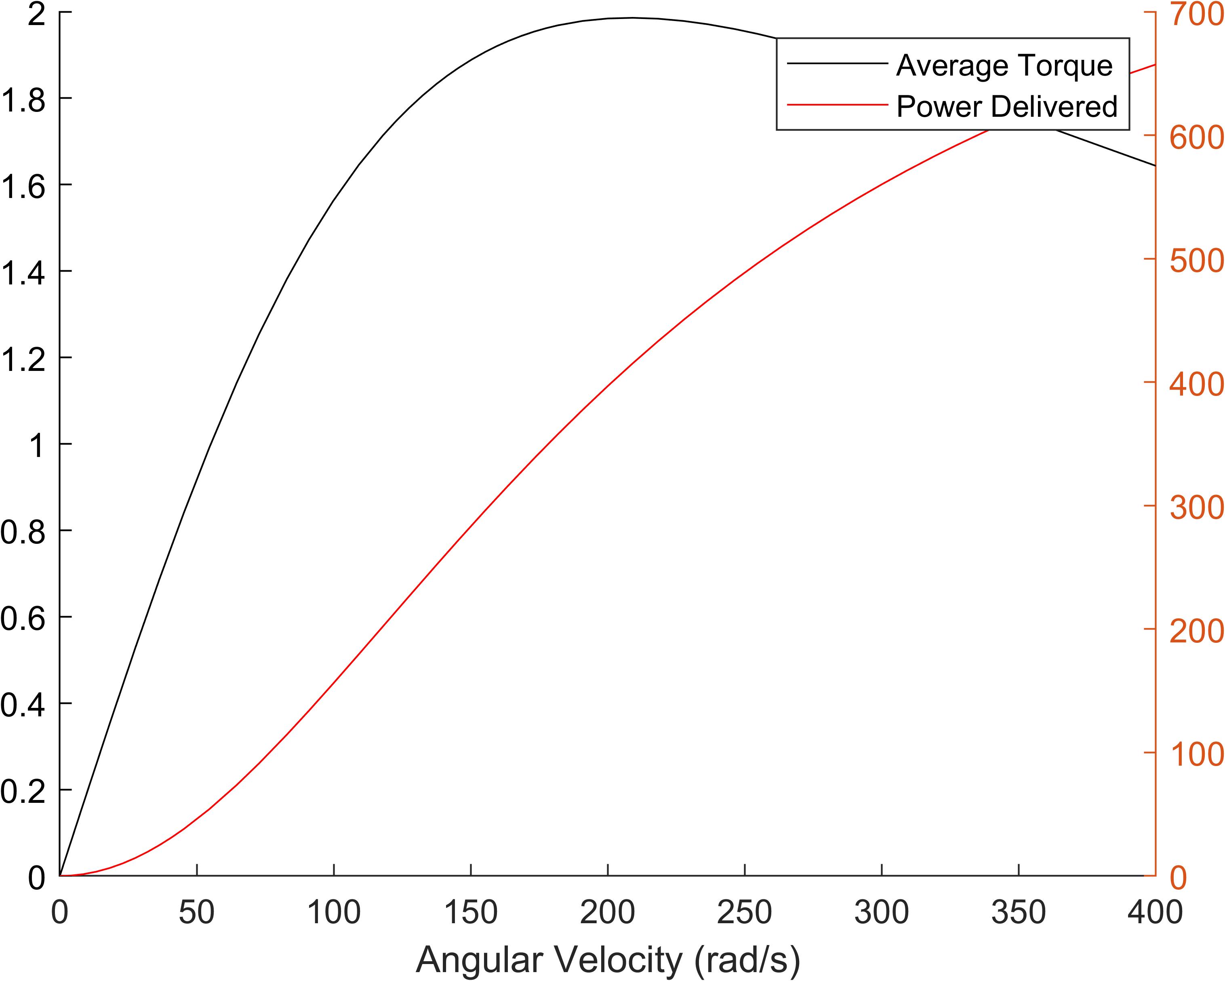
Report/graphics/Fig8.jpg
