TheMechatronic/Skripsie-2022/Report/graphics/FluxDensity0deg.jpg

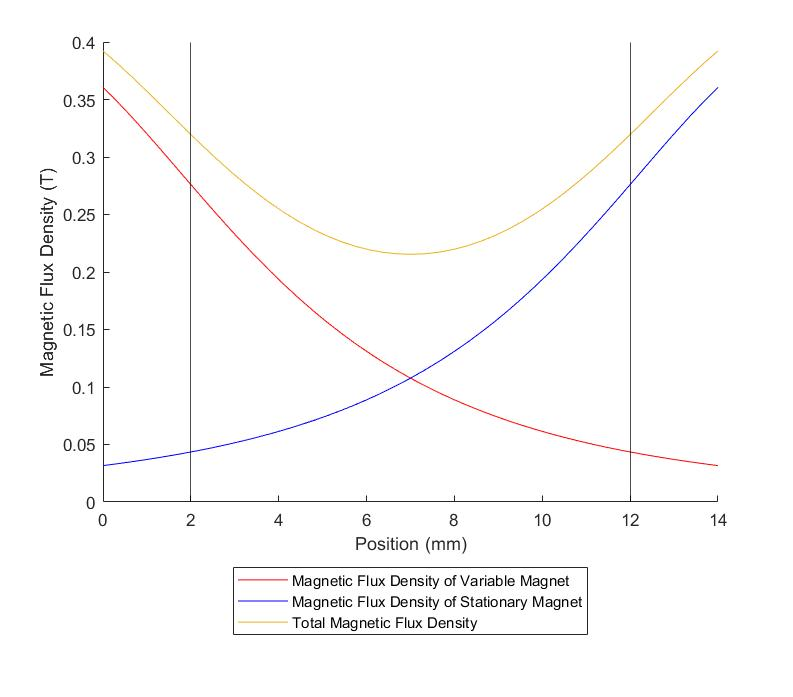
Report/graphics/FluxDensity0deg.jpg
