TheMechatronic/Skripsie-2022/Report/graphics/FluxDensityPhases.jpg

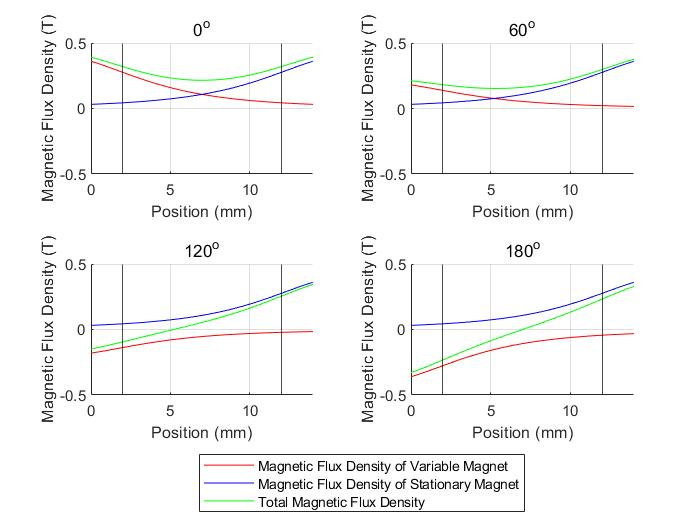
Report/graphics/FluxDensityPhases.jpg
