TheMechatronic/Skripsie-2022/Report/graphics/Frame.JPG

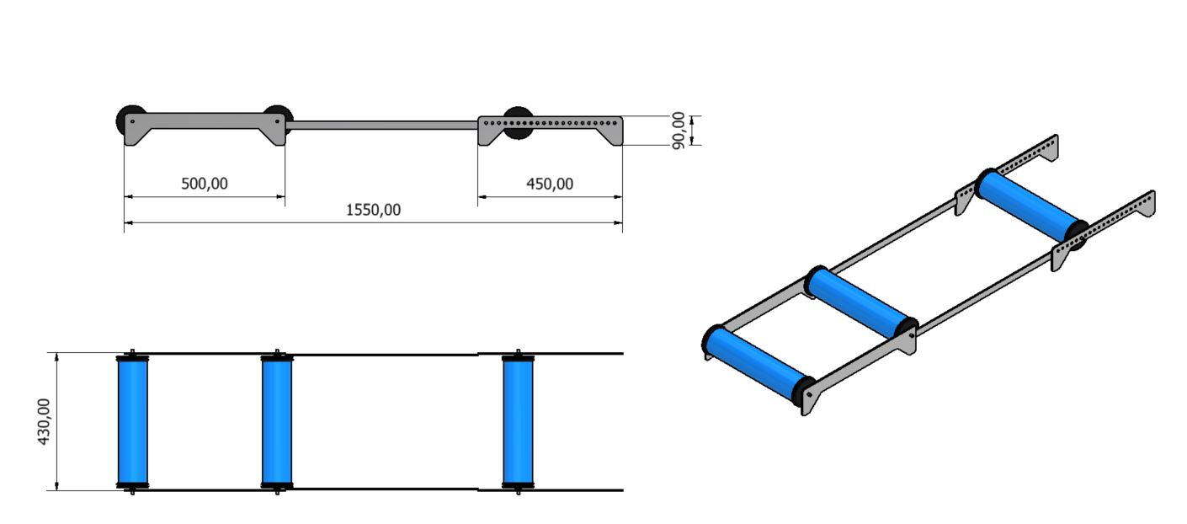
Report/graphics/Frame.JPG
