TheMechatronic/Skripsie-2022/Report/graphics/IMG_2162.jpg

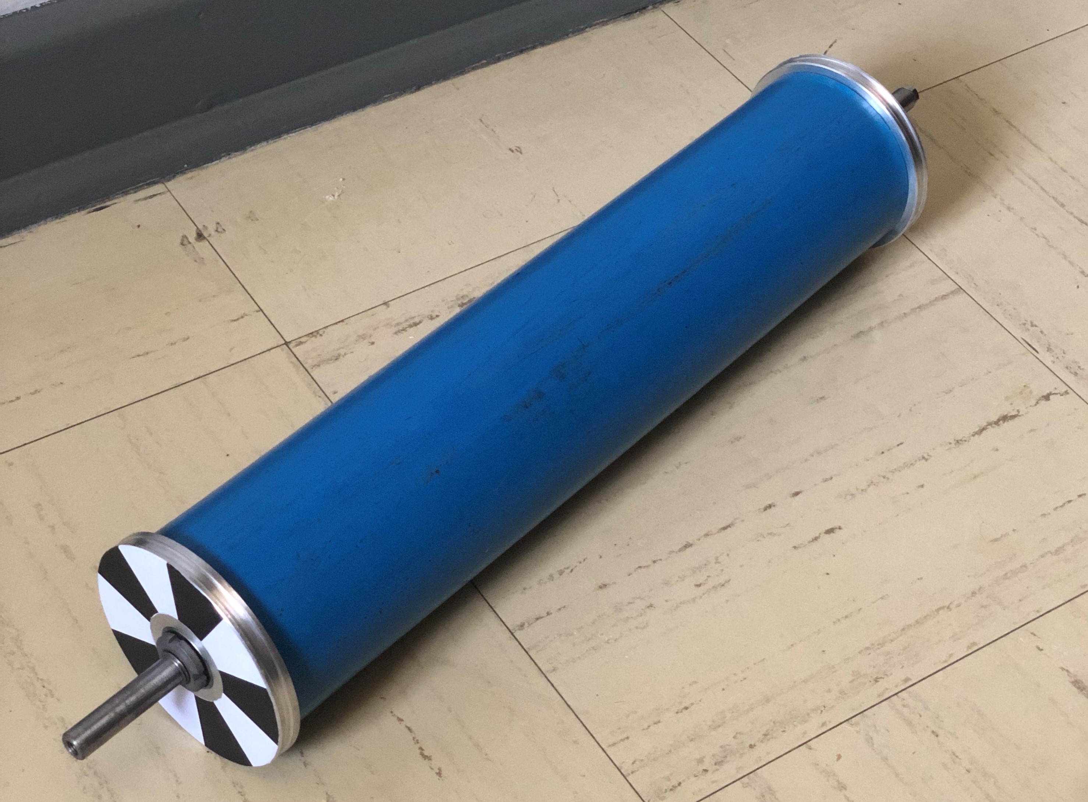
Report/graphics/IMG_2162.jpg
