TheMechatronic/Skripsie-2022/Report/graphics/LightBlue.png

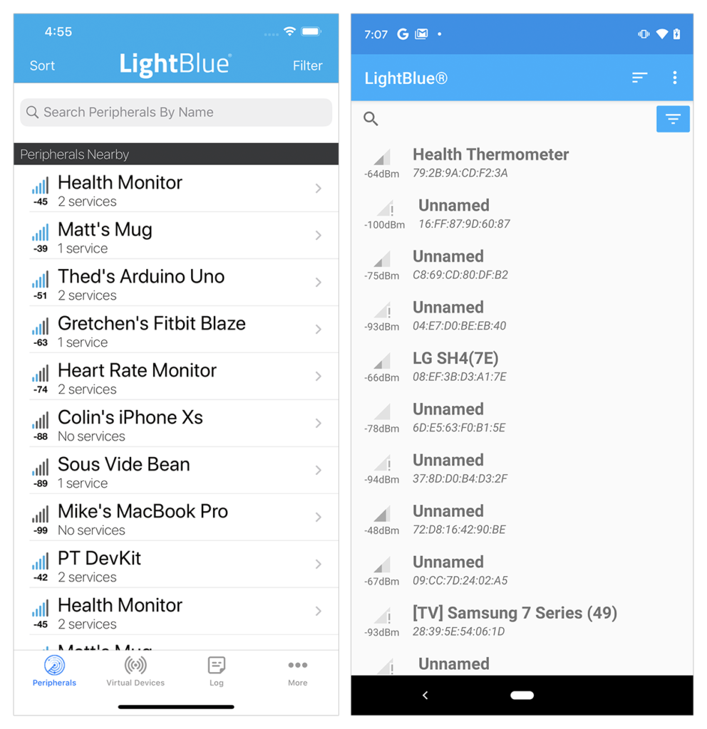
Report/graphics/LightBlue.png
