TheMechatronic/Skripsie-2022/Report/graphics/MOTOR.JPG

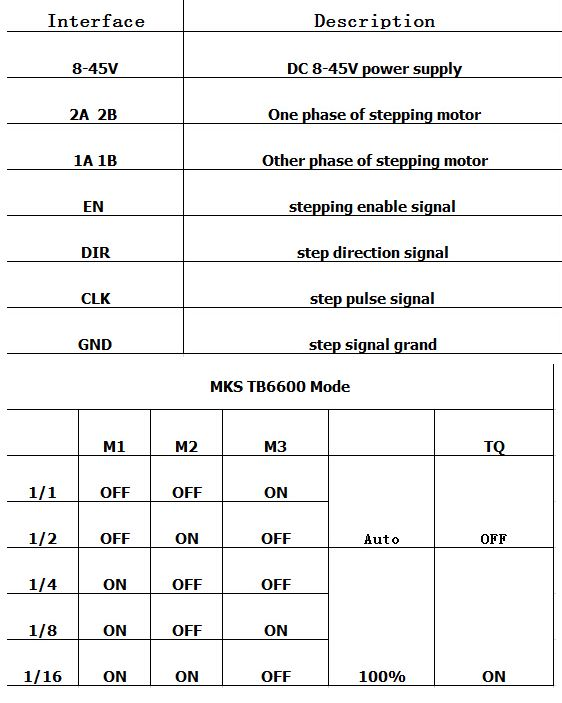
Report/graphics/MOTOR.JPG
