TheMechatronic/Skripsie-2022/Report/graphics/MTB angle.JPG

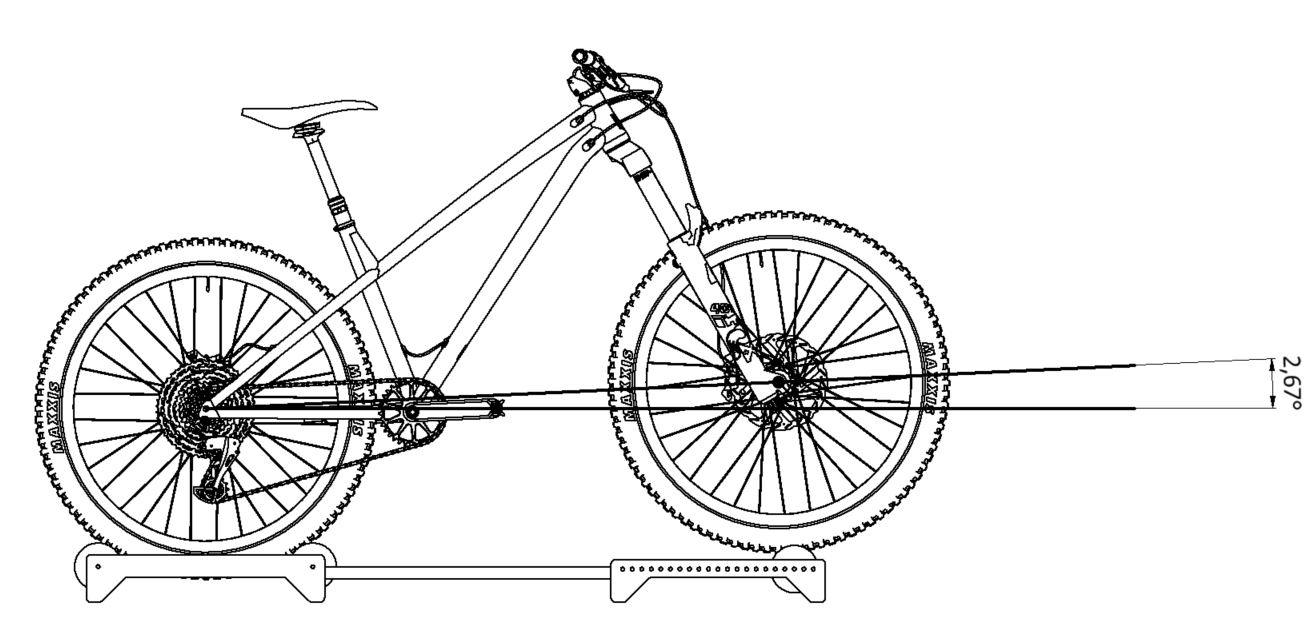
Report/graphics/MTB angle.JPG
