TheMechatronic/Skripsie-2022/Report/graphics/Pipe Dimensions.JPG

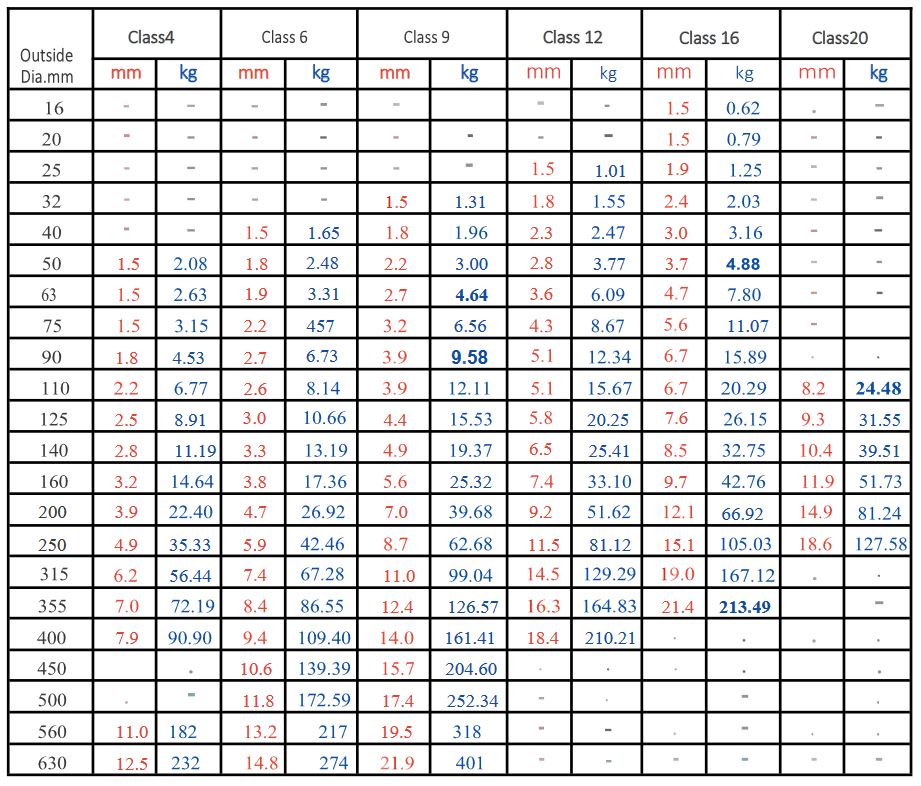
Report/graphics/Pipe Dimensions.JPG
