TheMechatronic/Skripsie-2022/Report/graphics/Road Bike angle.JPG

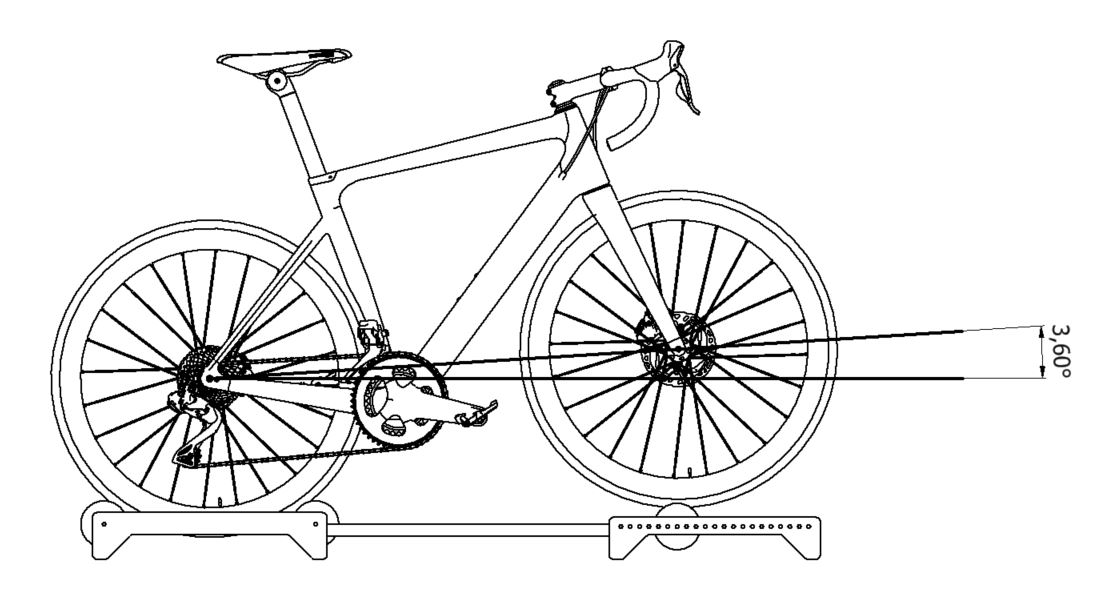
Report/graphics/Road Bike angle.JPG
