TheMechatronic/Skripsie-2022/Report/graphics/Roller Size.png

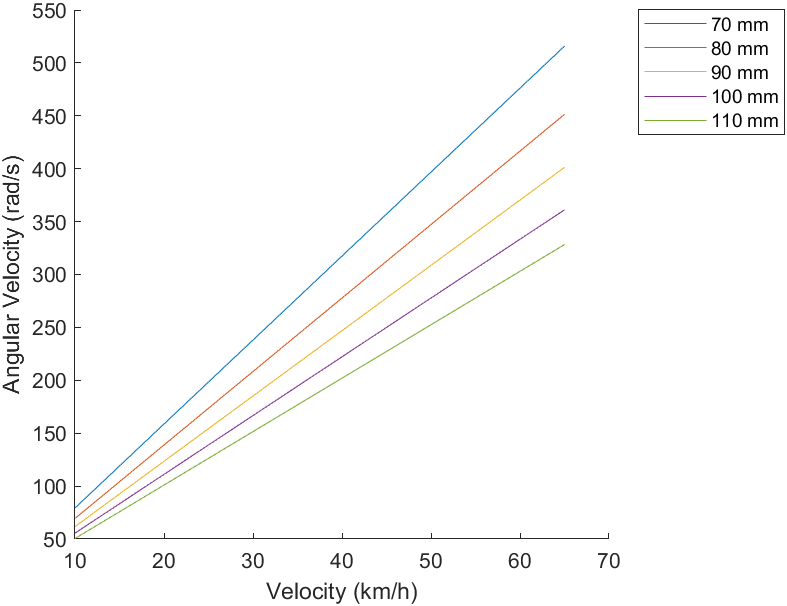
Report/graphics/Roller Size.png
