TheMechatronic/Skripsie-2022/Report/graphics/SIM.jpg

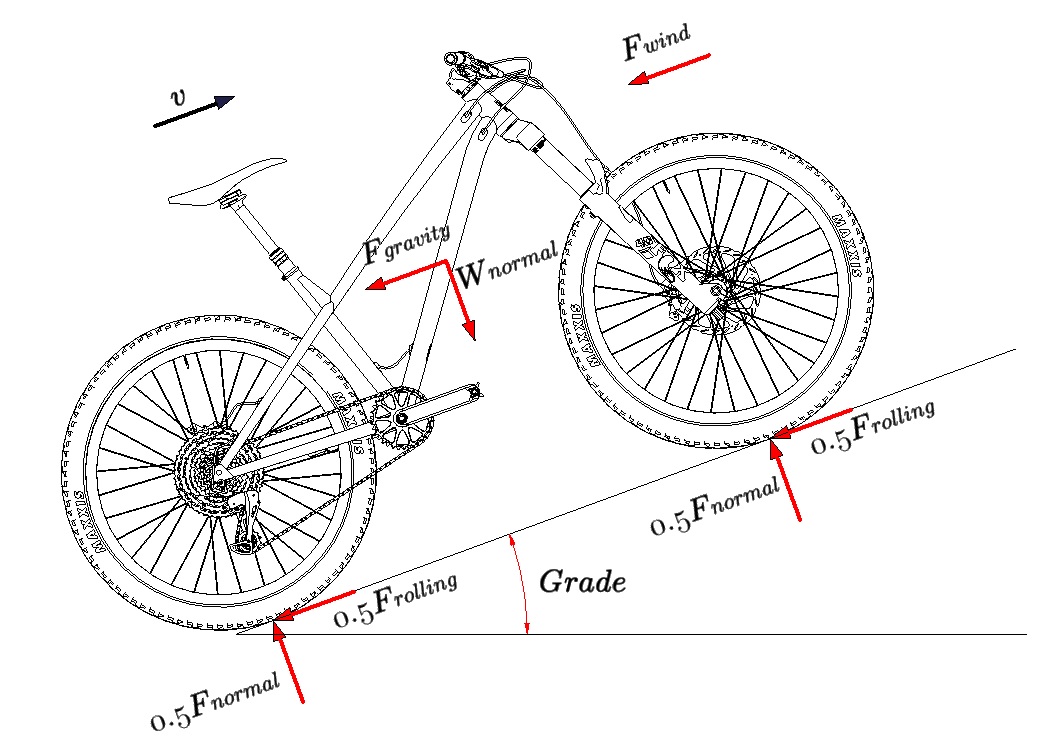
Report/graphics/SIM.jpg
