TheMechatronic/Skripsie-2022/Report/graphics/Simple model.jpg

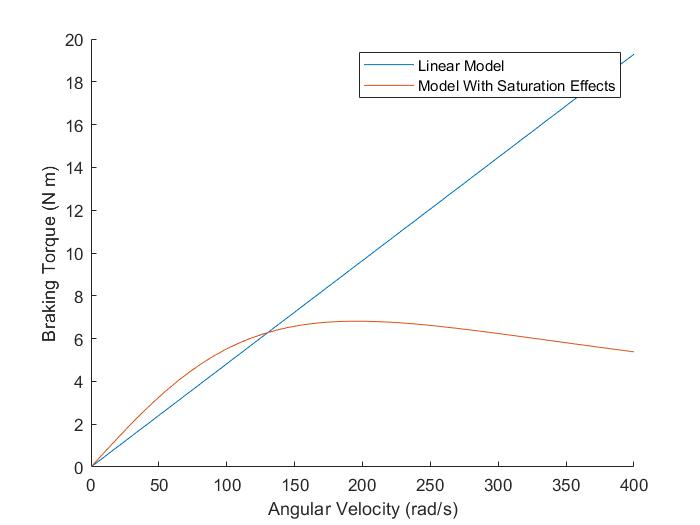
Report/graphics/Simple model.jpg
