TheMechatronic/Skripsie-2022/Report/graphics/ZwiftConnect2.jpg

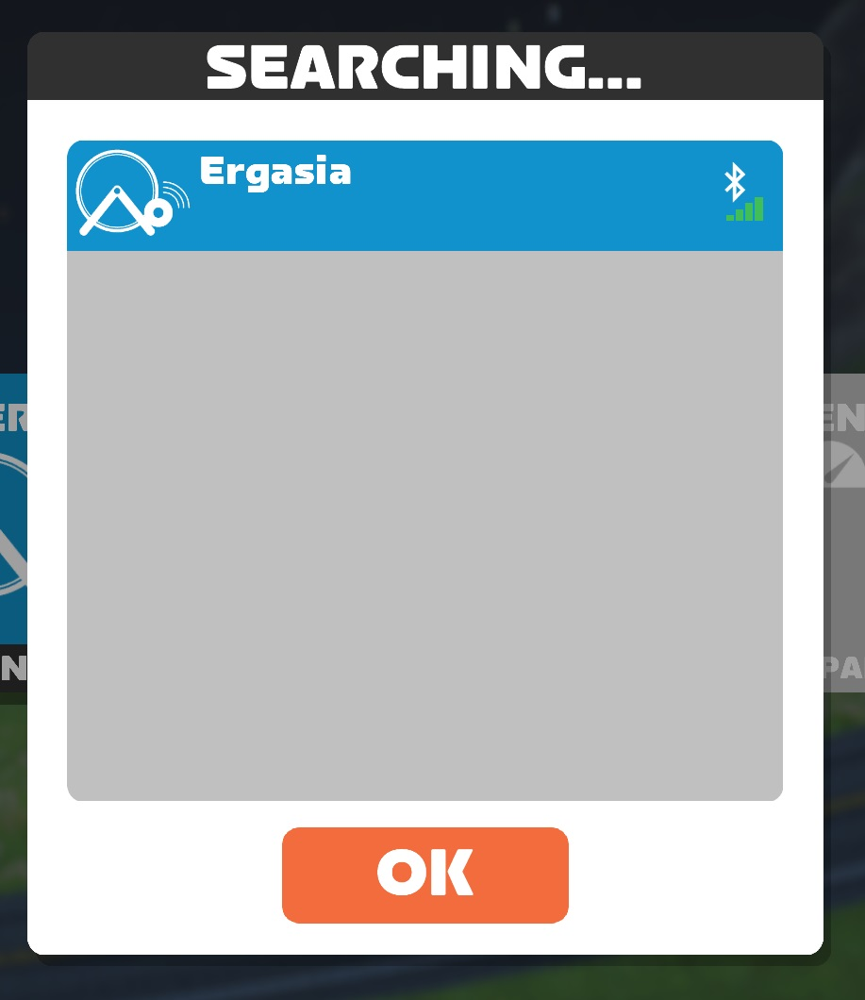
Report/graphics/ZwiftConnect2.jpg
