TheMechatronic/Skripsie-2022/Report/graphics/ZwiftConnect.jpg

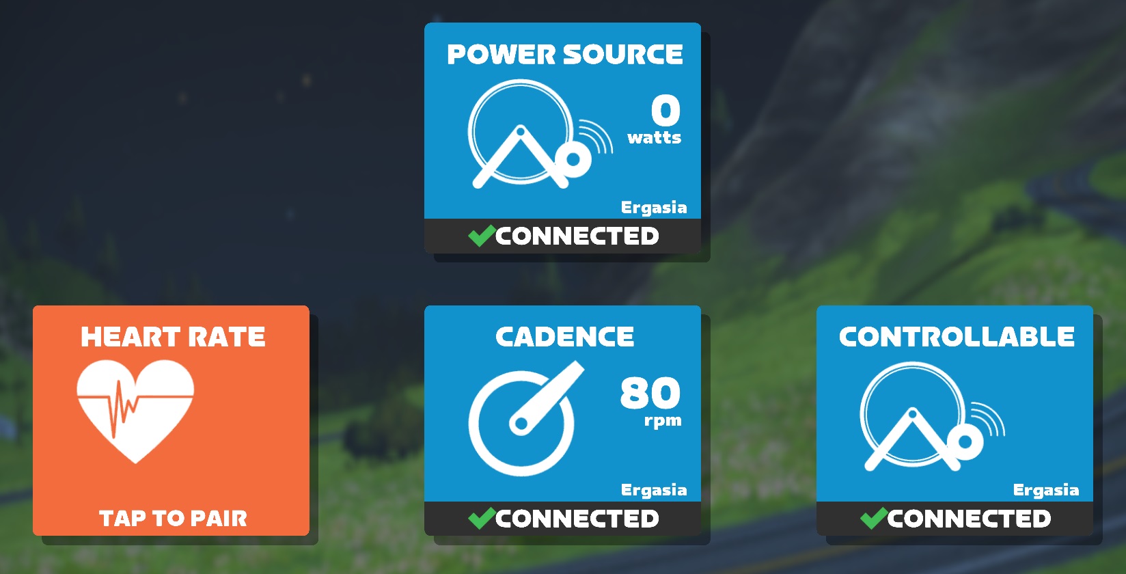
Report/graphics/ZwiftConnect.jpg
