TheMechatronic/Skripsie-2022/Report/Nomenclature.tex

% Title: Report LaTex File: Accronyms and Abbreviations
% Auther: DC Eksteen
% Student Number: 22623906
% Contact: 22623906@sun.ac.za
% Date: 2022/09/14
% Version: 2.0

\DeclareAcronym{api}{
	short = API ,
	long  = Application Program Interface ,
	short-plural = s ,
	long-plural = s ,
	tag = abbrev
}
\DeclareAcronym{ble}{
	short = BLE ,
	long  = Bluetooth Low Energy ,
	short-plural = s ,
	long-plural = s ,
	tag = abbrev
}
\DeclareAcronym{uhf}{
	short = UHF ,
	long  = Ultra-High Frequency ,
	short-plural = s ,
	long-plural = s ,
	tag = abbrev
}
\DeclareAcronym{bsig}{
	short = BSIG ,
	long  = Bluetooth Special Interest Group ,
	short-plural = s ,
	long-plural = s ,
	tag = abbrev
}
\DeclareAcronym{bbr}{
	short = BR/EDR ,
	long  = Basic Rate/Enhanced Data Rate ,
	short-plural = s ,
	long-plural = s ,
	tag = abbrev
}
\DeclareAcronym{ftms}{
	short = FTMS ,
	long  = Fitness Machine Service ,
	short-plural = s ,
	long-plural = s ,
	tag = abbrev
}
\DeclareAcronym{gatt}{
	short = GATT ,
	long  = Generic ATTribute Profile ,
	short-plural = s ,
	long-plural = s ,
	tag = abbrev
}
\DeclareAcronym{sim}{
	short = SIM ,
	long  = Indoor Bike Simulation ,
	short-plural = s ,
	long-plural = s ,
	tag = abbrev
}
\DeclareAcronym{crr}{
	short = $\textbf{Crr}$ ,
	long  = Coefficient of Rolling Resistance ,
	short-plural = s ,
	long-plural = s ,
	tag = abbrev, 
	sort = crr
}
\DeclareAcronym{cw}{
	short = $\textbf{Cw}$ ,
	long  = Wind Resistance	Coefficient ,
	short-plural = s ,
	long-plural = s ,
	tag = abbrev,
	sort = cw
}
\DeclareAcronym{rpm}{
	short = rpm ,
	long  = Revolutions Per Minute ,
	short-plural = s ,
	long-plural = s ,
	tag = abbrev
}
\DeclareAcronym{ide}{
	short = IDE ,
	long  = Integrated Development Environment  ,
	short-plural = s ,
	long-plural = s ,
	tag = abbrev
}
\DeclareAcronym{ipc}{
	short = IPC ,
	long  = Inter-Process Communication  ,
	short-plural = s ,
	long-plural = s ,
	tag = abbrev
}
\DeclareAcronym{rpc}{
	short = RPC ,
	long  = Remote Procedure Call  ,
	short-plural = s ,
	long-plural = s ,
	tag = abbrev
}
\DeclareAcronym{dis}{
	short = DIS ,
	long  = Device Information Service  ,
	short-plural = s ,
	long-plural = s ,
	tag = abbrev
}
\DeclareAcronym{mtb}{
	short = MTB ,
	long  = Mountain Bike  ,
	short-plural = s ,
	long-plural = s ,
	tag = abbrev
}
\DeclareAcronym{gpio}{
	short = GPIO ,
	long  = General Purpose Input and Output  ,
	short-plural = s ,
	long-plural = s ,
	tag = abbrev
}
\DeclareAcronym{led}{
	short = LED ,
	long  = Light Emitting Diode  ,
	short-plural = s ,
	long-plural = s ,
	tag = abbrev
}
\DeclareAcronym{fec}{
	short = FE-C,
	long  = Fitness Equipment - Control ,
	short-plural = s ,
	long-plural = s ,
	tag = abbrev
}																								
\DeclareAcronym{uuid}{
	short = UUID,
	long  = Universal Unique Identifier,
	short-plural = s ,
	long-plural = s ,
	tag = abbrev
}
\DeclareAcronym{fm}{
	short = FM,
	long  = Fitness Machine,
	short-plural = s ,
	long-plural = s ,
	tag = abbrev
}
\DeclareAcronym{erg}{
	short = ERG,
	long  = ``Ergasia'',
	short-plural = s ,
	long-plural = s ,
	tag = abbrev
}
\DeclareAcronym{ecb}{
	short = ECB,
	long  = Eddy Current Brake,
	short-plural = s ,
	long-plural = s ,
	tag = abbrev
}
\DeclareAcronym{nsoi}{
	short = N-SOI,
	long  = Narrow System of Interest,
	short-plural = s ,
	long-plural = s ,
	tag = abbrev
}
\DeclareAcronym{wsoi}{
	short = W-SOI,
	long  = Wider System of Interest,
	short-plural = s ,
	long-plural = s ,
	tag = abbrev
}
\DeclareAcronym{upvc}{
	short = uPVC,
	long  = Unplasticized Polyvinyl Chloride,
	short-plural = s ,
	long-plural = s ,
	tag = abbrev
}
\DeclareAcronym{cpu}{
	short = CPU,
	long  = Central Processing Unit,
	short-plural = s ,
	long-plural = s ,
	tag = abbrev
}
\DeclareAcronym{dbus}{
	short = dBus,
	long  = Desktop Bus Deamon,
	short-plural = s ,
	long-plural = s ,
	tag = abbrev
}

% class `symbol': symbols
\DeclareAcronym{thetadBrake}{
	short = \ensuremath{\dot{\theta}} ,
	long  = Angular Velocity \tabto{8cm} \si{\radian\per\second},
	sort =  ,
	tag = symbol
}

\DeclareAcronym{condDisk}{
	short = \ensuremath{\sigma},
	long  = Conductivity \tabto{8cm} \si{\siemens\per\meter} ,
	sort =  ,
	tag = symbol
}

\DeclareAcronym{B}{
	short = \ensuremath{B},
	long  = Magnetic Flux Density \tabto{8cm} \si{\tesla} ,
	sort =  ,
	tag = symbol
}

\DeclareAcronym{v}{
	short = \ensuremath{v} ,
	long  = Velocity \tabto{8cm} \si{\meter\per\second},
	sort =  ,
	tag = symbol
}

\DeclareAcronym{I}{
	short = \ensuremath{I} ,
	long  = Current \tabto{8cm} \si{\ampere},
	sort =  ,
	tag = symbol
}

\DeclareAcronym{F}{
	short = \ensuremath{F} ,
	long  = Force \tabto{8cm} \si{\newton},
	sort =  ,
	tag = symbol
}

\DeclareAcronym{T}{
	short = \ensuremath{T} ,
	long  = Torque \tabto{8cm} \si{\newton\meter},
	sort =  ,
	tag = symbol
}

\DeclareAcronym{theta}{
	short = \ensuremath{\theta} ,
	long  = Angle \tabto{8cm} \si{\radian},
	sort =  ,
	tag = symbol
}

\DeclareAcronym{omega}{
	short = \ensuremath{\omega} ,
	long  = Angular Velocity \tabto{8cm} \si{\radian\per\second},
	sort =  ,
	tag = symbol
}

\DeclareAcronym{Br}{
	short = \ensuremath{B_r} ,
	long  = Magnet Remanence Field \tabto{8cm} \si{\tesla},
	sort =  ,
	tag = symbol
}

\DeclareAcronym{J}{
	short = \ensuremath{J} ,
	long  = Current \tabto{8cm} \si{\ampere},
	sort =  ,
	tag = symbol
}
\DeclareAcronym{E}{
	short = \ensuremath{E} ,
	long  = Electric Field \tabto{8cm} \si{\volt\per\meter},
	sort =  ,
	tag = symbol
}
\DeclareAcronym{permeability}{
	short = \ensuremath{\mu} ,
	long  = Magnetic Permeability \tabto{8cm} \si{\henry\per\meter},
	sort =  ,
	tag = symbol
}
