TheMechatronic/Skripsie-2022/Design/CAD/FRAME - FOLDED.stp

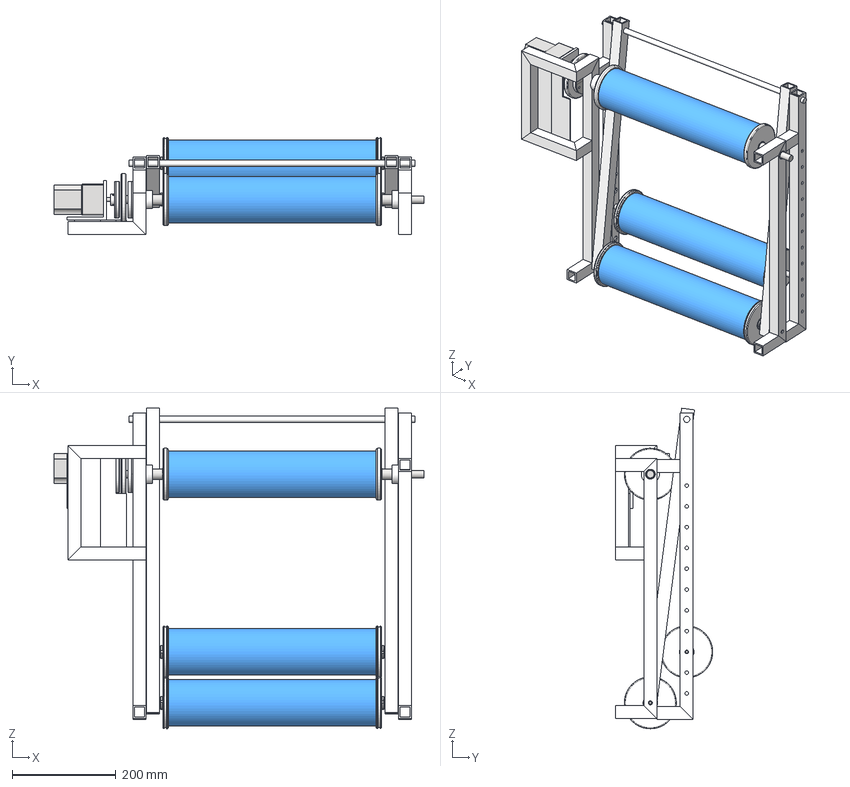
[picture p122: CAD file, 2022-11-10]
Design/CAD/FRAME - FOLDED.stp
712.1 x 187.5 x 617.0 mm
P601 x 2
P602 x 2
P701
P002
P603
P302 x 4
SP001 x 3
6902 2RS BTC x 10
P301 x 2
KM 02 x 4
P303 x 4
P201
P202 x 3
P203
STN 022930 - 20 x 2
DE STD-0004 x 2
STN 022930 - 12
P204 x 2
P501
P403 x 3
P502
P402
P404
P405
P406
P407
P408
P409
P410
P411
P412
MOTOR MODEL
P005
P003
P004 x 4
P001 x 2
