TheMechatronic/Skripsie-2022/(list of files, cad)

Other CAD files:
Design/CAD/472-028.ipt
Design/CAD/BEARING AND MAGNET DISC MOUNT BRACKET.ipt
Design/CAD/BEARING AND MAGNET DISC MOUNT.ipt
Design/CAD/BEARING BLOCK.ipt
Design/CAD/BEARING.ipt
Design/CAD/BRAKE BRACKET.ipt
Design/CAD/BRAKE DISC.ipt
Design/CAD/BRAKE MOUNT PLATE 2.ipt
Design/CAD/BRAKE MOUNT PLATE.ipt
Design/CAD/BRAKE RISER 2.ipt
Design/CAD/CONTROL RISER FRONT.ipt
Design/CAD/CONTROL RISER.ipt
Design/CAD/Elastic.ipt
Design/CAD/FRAME - FOLDABLE.iam
Design/CAD/FRAME - FOLDED.iam
Design/CAD/FRAME - OPEN.iam
Design/CAD/FRONT FRAME ASSEMBLY.iam
Design/CAD/FRONT FRAME HINGE ROD.ipt
Design/CAD/FRONT FRAME LEFT BRACKET.ipt
Design/CAD/FRONT FRAME LEFT.iam
Design/CAD/FRONT FRAME PLAIN RISER.ipt
Design/CAD/FRONT FRAME RIGHT BRACKET.ipt
Design/CAD/FRONT FRAME RIGHT.iam
Design/CAD/FRONT FRAME RISER.ipt
Design/CAD/IDLE ROLLER BAERING SPACER.ipt
Design/CAD/IDLE ROLLER END CAP.ipt
Design/CAD/IDLE ROLLER SHAFT.ipt
Design/CAD/IDLE ROLLER.iam
Design/CAD/KEY.ipt
Design/CAD/LEFT FRAME.iam
Design/CAD/LEFT TOP TUBE.ipt
Design/CAD/LOCK NUT.ipt
Design/CAD/MAGNET MODEL.ipt
Design/CAD/MAGNETPLATE CONCEPT.ipt
Design/CAD/METAL BACKPLATE.ipt
Design/CAD/MIDDLE FRAME.ipt
Design/CAD/MOTOR BRACKET.ipt
Design/CAD/MOTOR MODEL.ipt
Design/CAD/OldVersions/BEARING AND MAGNET DISC MOUNT BRACKET.0001.ipt
Design/CAD/OldVersions/BEARING AND MAGNET DISC MOUNT.0004.ipt
Design/CAD/OldVersions/BEARING BLOCK.0006.ipt
Design/CAD/OldVersions/BRAKE BRACKET.0003.ipt
Design/CAD/OldVersions/BRAKE DISC.0001.ipt
Design/CAD/OldVersions/BRAKE MOUNT PLATE 2.0007.ipt
Design/CAD/OldVersions/BRAKE MOUNT PLATE.0005.ipt
Design/CAD/OldVersions/BRAKE RISER 2.0002.ipt
Design/CAD/OldVersions/BearingAndMagDiscMount.0001.ipt
Design/CAD/OldVersions/CONTROL RISER FRONT.0003.ipt
Design/CAD/OldVersions/CONTROL RISER.0006.ipt
Design/CAD/OldVersions/FRAME - FOLDABLE.0004.iam
Design/CAD/OldVersions/FRAME - FOLDED.0005.iam
Design/CAD/OldVersions/FRAME - OPEN.0002.iam
Design/CAD/OldVersions/FRONT FRAME ASSEMBLY.0001.iam
Design/CAD/OldVersions/FRONT FRAME HINGE ROD.0001.ipt
Design/CAD/OldVersions/FRONT FRAME LEFT BRACKET.0001.ipt
Design/CAD/OldVersions/FRONT FRAME LEFT.0001.iam
Design/CAD/OldVersions/FRONT FRAME PLAIN RISER.0002.ipt
Design/CAD/OldVersions/FRONT FRAME RIGHT BRACKET.0001.ipt
Design/CAD/OldVersions/FRONT FRAME RIGHT.0002.iam
Design/CAD/OldVersions/FRONT FRAME RISER.0002.ipt
Design/CAD/OldVersions/IDLE ROLLER BAERING SPACER.0001.ipt
Design/CAD/OldVersions/IDLE ROLLER END CAP.0001.ipt
Design/CAD/OldVersions/IDLE ROLLER SHAFT.0002.ipt
Design/CAD/OldVersions/IDLE ROLLER.0001.iam
Design/CAD/OldVersions/LEFT FRAME.0006.iam
Design/CAD/OldVersions/LEFT TOP TUBE.0010.ipt
Design/CAD/OldVersions/MAGNET MODEL.0001.ipt
Design/CAD/OldVersions/METAL BACKPLATE.0001.ipt
Design/CAD/OldVersions/MOTOR BRACKET.0003.ipt
Design/CAD/OldVersions/MOTOR MODEL.0001.ipt
Design/CAD/OldVersions/POWER ROLLER END CAP.0002.ipt
Design/CAD/OldVersions/POWER ROLLER SHAFT.0003.ipt
Design/CAD/OldVersions/POWER SHAFT ASSEMBLY.0007.iam
Design/CAD/OldVersions/REAR ASSEMBLY.0002.iam
Design/CAD/OldVersions/REAR FRONT FRAME RISER.0001.ipt
Design/CAD/OldVersions/REAR RISER BRAKE.0003.ipt
Design/CAD/OldVersions/RIGHT FRAME.0002.iam
Design/CAD/OldVersions/RIGHT TOP TUBE.0010.ipt
Design/CAD/OldVersions/RISER.0003.ipt
Design/CAD/OldVersions/ROLLER TUBE.0001.ipt
Design/CAD/OldVersions/ROTATING MAGNET DISC.0002.ipt
Design/CAD/OldVersions/TEST SHAFT.0001.ipt
Design/CAD/POWER ROLLER END CAP.ipt
Design/CAD/POWER ROLLER SHAFT.ipt
Design/CAD/POWER SHAFT ASSEMBLY.iam
Design/CAD/REAR ASSEMBLY.iam
Design/CAD/REAR RISER BRAKE.ipt
Design/CAD/RIGHT FRAME.iam
Design/CAD/RIGHT TOP TUBE.ipt
Design/CAD/RISER.ipt
Design/CAD/ROLLER TUBE.ipt
Design/CAD/ROTATING MAGNET DISC.ipt
Design/CAD/TEST SHAFT.ipt
Design/Drawings/FRAME - FOLDED.idw
Design/Drawings/FRAME - OPEN.idw
Design/Drawings/FRONT FRAME ASSEMBLY.idw
Design/Drawings/IDLE ROLLER.idw
Design/Drawings/MAGNET MODEL.idw
Design/Drawings/MAGNETPLATE CONCEPT.idw
Design/Drawings/MEASURING WHEEL.idw
Design/Drawings/OldVersions/FRONT FRAME ASSEMBLY.0001.idw
Design/Drawings/OldVersions/IDLE ROLLER.0002.idw
Design/Drawings/OldVersions/MAGNET MODEL.0001.idw
Design/Drawings/OldVersions/MAGNETPLATE CONCEPT.0003.idw
Design/Drawings/OldVersions/MEASURING WHEEL.0001.idw
Design/Drawings/POWER SHAFT ASSEMBLY.idw
Design/Drawings/REAR ASSEMBLY.idw
Design/Workshop Drawings/A002.idw
Design/Workshop Drawings/A003.idw
Design/Workshop Drawings/A004.idw
Design/Workshop Drawings/A005.idw
Design/Workshop Drawings/A006.idw
Design/Workshop Drawings/A007.idw
Design/Workshop Drawings/OldVersions/A002.0005.idw
Design/Workshop Drawings/OldVersions/A004.0002.idw
Design/Workshop Drawings/OldVersions/A005.0001.idw
Design/Workshop Drawings/OldVersions/A006.0001.idw
Design/Workshop Drawings/OldVersions/P002.0001.idw
Design/Workshop Drawings/OldVersions/P003.0001.idw
Design/Workshop Drawings/OldVersions/P201.0008.idw
Design/Workshop Drawings/OldVersions/P202.0001.idw
Design/Workshop Drawings/OldVersions/P301.0001.idw
Design/Workshop Drawings/OldVersions/P302.0001.idw
Design/Workshop Drawings/OldVersions/P303.0001.idw
Design/Workshop Drawings/OldVersions/P403.0001.idw
Design/Workshop Drawings/OldVersions/P404.0001.idw
Design/Workshop Drawings/OldVersions/P408.0001.idw
Design/Workshop Drawings/OldVersions/P411.0003.idw
Design/Workshop Drawings/OldVersions/P502.0001.idw
Design/Workshop Drawings/OldVersions/P601.0001.idw
Design/Workshop Drawings/OldVersions/SP002.0001.idw
Design/Workshop Drawings/P001.idw
Design/Workshop Drawings/P002.idw
Design/Workshop Drawings/P003.idw
Design/Workshop Drawings/P004.idw
Design/Workshop Drawings/P005.idw
Design/Workshop Drawings/P201.idw
Design/Workshop Drawings/P202.idw
Design/Workshop Drawings/P203.idw
Design/Workshop Drawings/P204.idw
Design/Workshop Drawings/P301.idw
Design/Workshop Drawings/P302.idw
Design/Workshop Drawings/P303.idw
Design/Workshop Drawings/P402.idw
Design/Workshop Drawings/P403.idw
Design/Workshop Drawings/P404.idw
Design/Workshop Drawings/P405.idw
Design/Workshop Drawings/P406.idw
Design/Workshop Drawings/P407.idw
Design/Workshop Drawings/P408.idw
Design/Workshop Drawings/P409.idw
Design/Workshop Drawings/P410.idw
Design/Workshop Drawings/P411.idw
Design/Workshop Drawings/P412.idw
Design/Workshop Drawings/P501.idw
Design/Workshop Drawings/P502.idw
Design/Workshop Drawings/P601.idw
Design/Workshop Drawings/P602.idw
Design/Workshop Drawings/P603.idw
Design/Workshop Drawings/P701.idw
Design/Workshop Drawings/SP001.idw
Design/Workshop Drawings/SP002.idw
