TheMechatronic/Skripsie-2022/Design/Sketches/A002.pdf

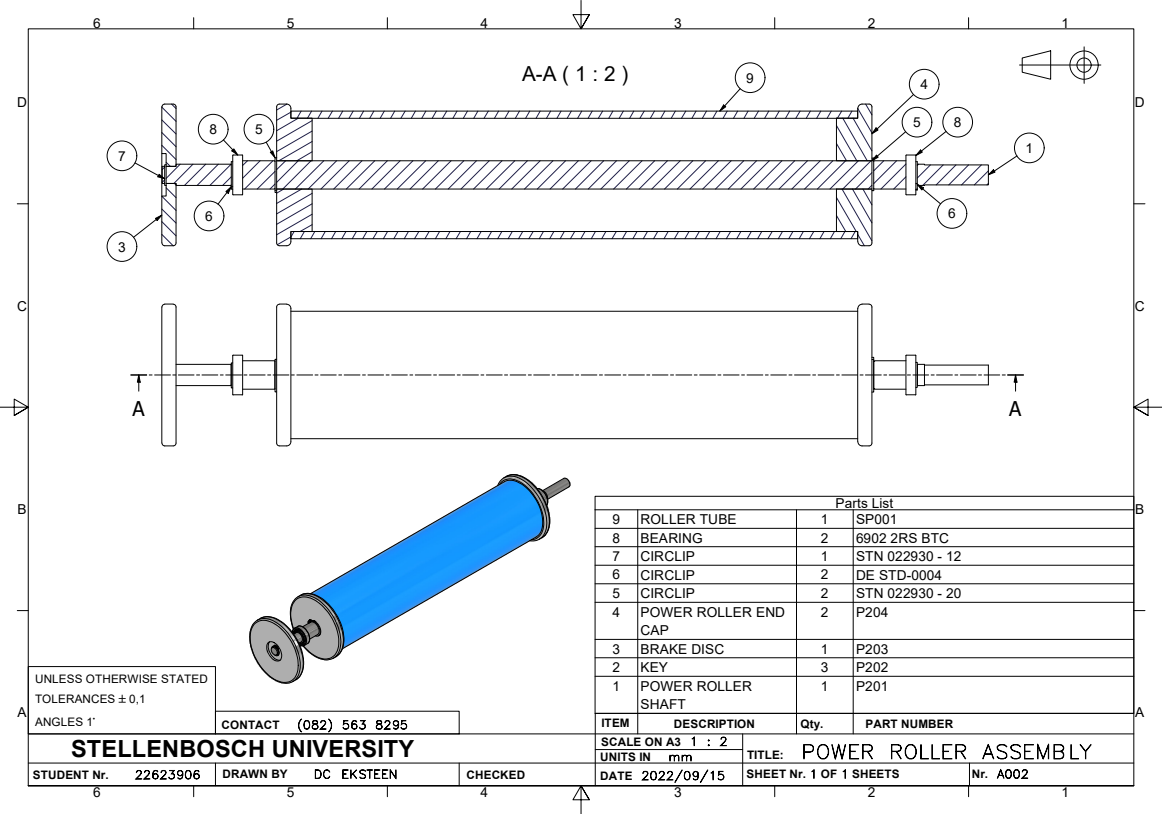
[picture p127: page 1]
Parts List; STUDENT Nr.; DRAWN BY; DC EKSTEEN; CHECKED; ITEM; DESCRIPTION; Qty.; PART NUMBER; SCALE ON A3 1 : 2; UNITS IN; SHEET Nr. 1 OF 1 SHEETS; TITLE:; POWER ROLLER ASSEMBLY; DATE 2022/09/15; ANGLES 1~; CONTACT

9 | ROLLER TUBE | 1 | SP001
8 | BEARING | 2 | 6902 2RS BTC
7 | CIRCLIP | 1 | STN 022930 - 12
6 | CIRCLIP | 2 | DE STD-0004
5 | CIRCLIP | 2 | STN 022930 - 20
4 | POWER ROLLER END CAP | 2 | P204

3 | BRAKE DISC | 1 | P203
2 | KEY | 3 | P202
1 | POWER ROLLER SHAFT | 1 | P201

UNLESS OTHERWISE STATED
TOLERANCES `0,1
STELLENBOSCH UNIVERSITY
