TheMechatronic/Skripsie-2022/Design/Sketches/P201.pdf

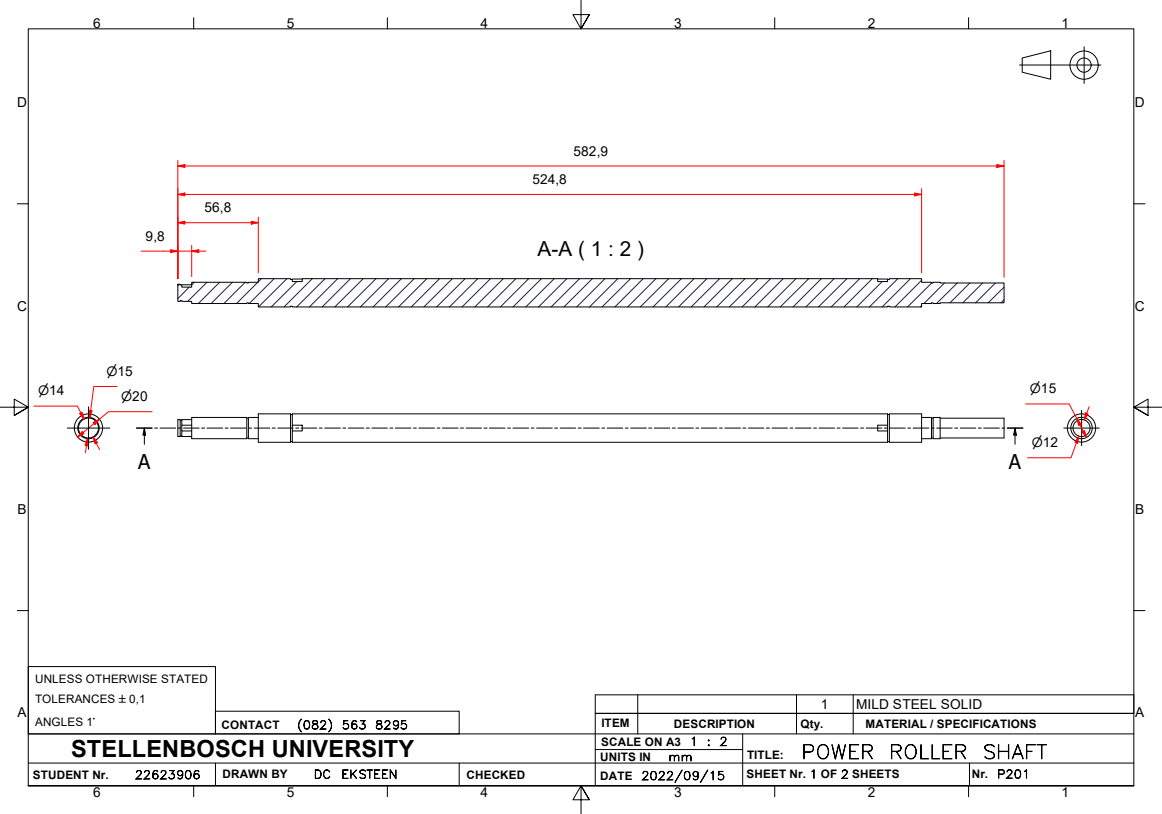
[picture p128: page 1]
MILD STEEL SOLID; STUDENT Nr.; DRAWN BY; DC EKSTEEN; CHECKED; ITEM; DESCRIPTION; Qty.; MATERIAL / SPECIFICATIONS; SCALE ON A3 1 : 2; UNITS IN; SHEET Nr. 1 OF 2 SHEETS; TITLE:; POWER ROLLER SHAFT; DATE 2022/09/15; ANGLES 1~; CONTACT

UNLESS OTHERWISE STATED
TOLERANCES `0,1
STELLENBOSCH UNIVERSITY

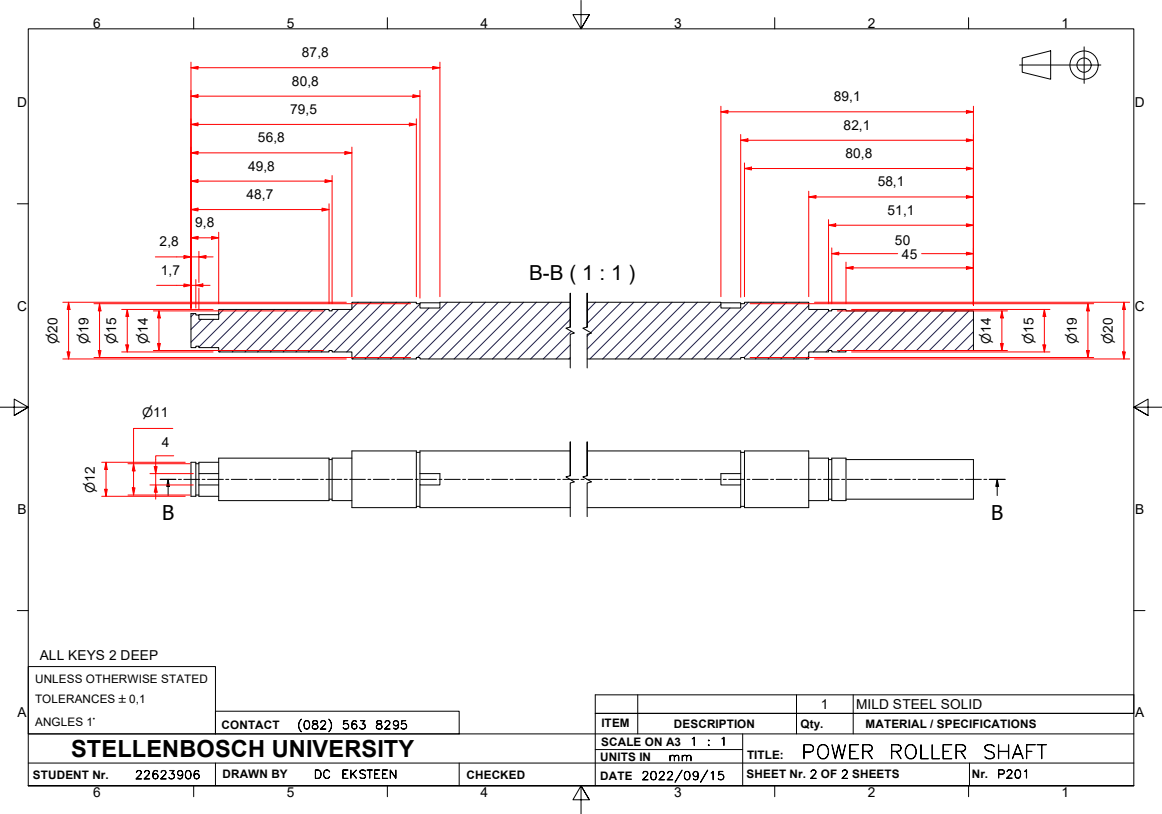
[picture p129: page 2]
MILD STEEL SOLID; STUDENT Nr.; DRAWN BY; DC EKSTEEN; CHECKED; ITEM; DESCRIPTION; Qty.; MATERIAL / SPECIFICATIONS; SCALE ON A3 1 : 1; UNITS IN; SHEET Nr. 2 OF 2 SHEETS; TITLE:; POWER ROLLER SHAFT; DATE 2022/09/15; ANGLES 1~; CONTACT

ALL KEYS 2 DEEP

UNLESS OTHERWISE STATED
TOLERANCES `0,1
STELLENBOSCH UNIVERSITY
