TheMechatronic/Skripsie-2022/Design/Sketches/P502.pdf

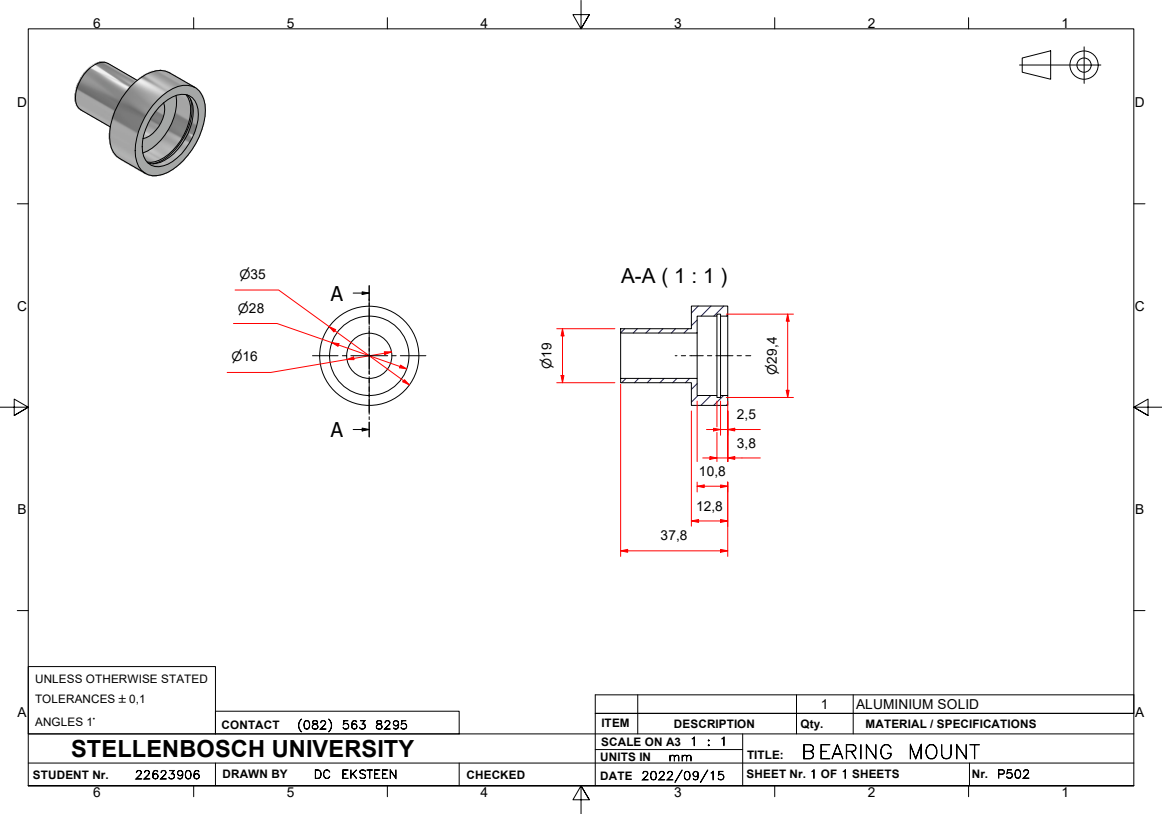
[picture p130: page 1]
ALUMINIUM SOLID; STUDENT Nr.; DRAWN BY; DC EKSTEEN; CHECKED; ITEM; DESCRIPTION; Qty.; MATERIAL / SPECIFICATIONS; SCALE ON A3 1 : 1; UNITS IN; SHEET Nr. 1 OF 1 SHEETS; TITLE:; BEARING MOUNT; DATE 2022/09/15; ANGLES 1~; CONTACT

UNLESS OTHERWISE STATED
TOLERANCES `0,1
STELLENBOSCH UNIVERSITY
