TheMechatronic/Skripsie-2022/Design/Sketches/SP002.pdf

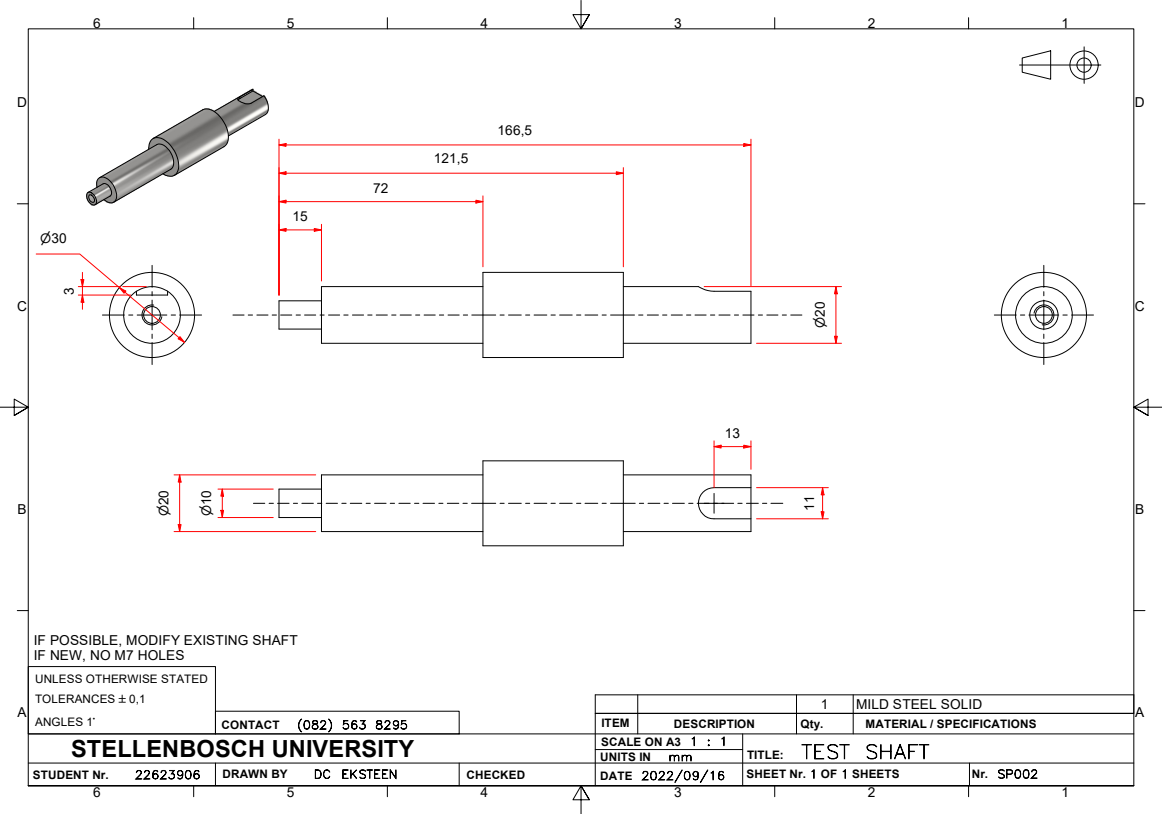
[picture p131: page 1]
MILD STEEL SOLID; STUDENT Nr.; DRAWN BY; DC EKSTEEN; CHECKED; ITEM; DESCRIPTION; Qty.; MATERIAL / SPECIFICATIONS; SCALE ON A3 1 : 1; UNITS IN; SHEET Nr. 1 OF 1 SHEETS; TITLE:; TEST SHAFT; DATE 2022/09/16; ANGLES 1~; CONTACT

IF POSSIBLE, MODIFY EXISTING SHAFT
IF NEW, NO M7 HOLES

UNLESS OTHERWISE STATED
TOLERANCES `0,1
STELLENBOSCH UNIVERSITY
