TheMechatronic/Skripsie-2022/(commit log)

2022-09-14 Add CAD files
    [472-028.ipt, BEARING AND MAGNET DISC MOUNT BRACKET.ipt, BEARING AND MAGNET DISC MOUNT.0001.ipt, BEARING AND MAGNET DISC MOUNT.ipt, BEARING BLOCK.ipt, BEARING.ipt, BRAKE BRACKET.ipt, BRAKE DISC.ipt]
2022-09-15 Add changes to drawings
    [A002.0001.idw, A002.idw, A004.idw, BEARING AND MAGNET DISC MOUNT BRACKET.0001.ipt, BEARING AND MAGNET DISC MOUNT BRACKET.ipt, BEARING AND MAGNET DISC MOUNT.0001.ipt, BEARING AND MAGNET DISC MOUNT.0002.ipt, BEARING AND MAGNET DISC MOUNT.ipt]
2022-09-15 Revised Drawings
    [A002.0001.idw, A002.0002.idw, A002.idw, A003.idw, A004.0002.idw, A004.idw, A005.0001.idw, A005.idw]
2022-09-15 Addd assembly drawings
    [FRAME - FOLDABLE.0002.iam, FRAME - FOLDABLE.0003.iam, FRAME - FOLDABLE.iam, FRAME - FOLDED.0003.iam, FRAME - FOLDED.iam, FRAME - FOLDED.idw, FRAME - OPEN.0001.iam, FRAME - OPEN.iam]
2022-09-16 Revise Drawings
    [A002.0002.idw, A002.0005.idw, A002.idw, IDLE ROLLER SHAFT.0001.ipt, IDLE ROLLER SHAFT.0002.ipt, IDLE ROLLER SHAFT.ipt, P201.0004.idw, P201.0008.idw]
2022-09-18 Report Work + Refine Matlab Files
    [MAGNET MODEL.0001.ipt, MAGNET MODEL.idw, MAGNET MODEL.ipt]
2022-09-19 Report Work
    [MAGNET MODEL.0001.idw, MAGNET MODEL.idw, MAGNETPLATE CONCEPT.0002.idw, MAGNETPLATE CONCEPT.idw, MAGNETPLATE CONCEPT.ipt]
2022-09-20 Report Work Add Electronic Design Section
    [MEASURING WHEEL.idw]
2022-09-27 BLE Updated
    [IDLE ROLLER.0002.idw, IDLE ROLLER.idw]
2022-10-20 Report: Hardware almost finished
    [FRONT FRAME ASSEMBLY.0001.iam, FRONT FRAME ASSEMBLY.0001.idw, FRONT FRAME ASSEMBLY.iam, FRONT FRAME ASSEMBLY.idw, MAGNETPLATE CONCEPT.0002.idw, MAGNETPLATE CONCEPT.0003.idw, MAGNETPLATE CONCEPT.idw, POWER SHAFT ASSEMBLY.0006.iam]
2022-11-10 Final Commit
    [Elastic.ipt, FRAME - FOLDABLE.0003.iam, FRAME - FOLDABLE.0004.iam, FRAME - FOLDABLE.iam, FRAME - FOLDED.0004.iam, FRAME - FOLDED.0005.iam, FRAME - FOLDED.iam, FRAME - FOLDED.stp]
